minadanesh/apsc496/documents/concept alternatives assignment/Functional Decomposition.JPG

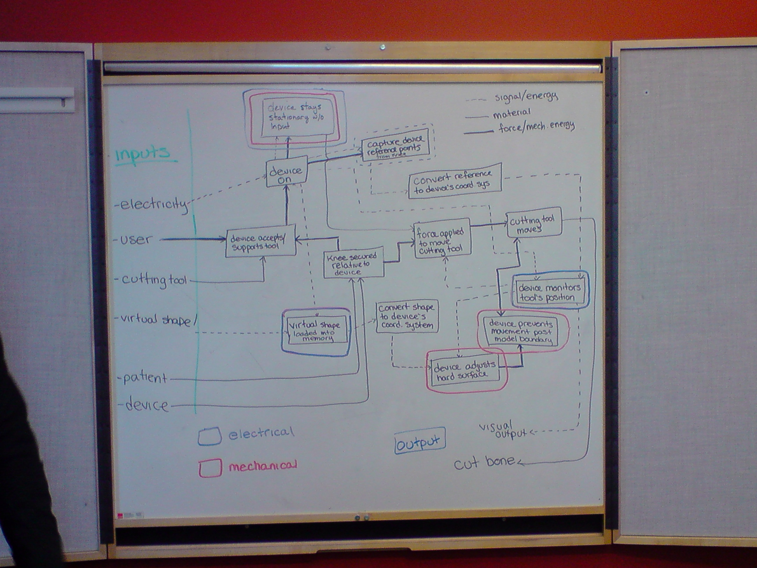
documents/concept alternatives assignment/Functional Decomposition.JPG
