minadanesh/apsc496/design_documents/Praxim Models/Joint 1_2 Cross Section.jpg

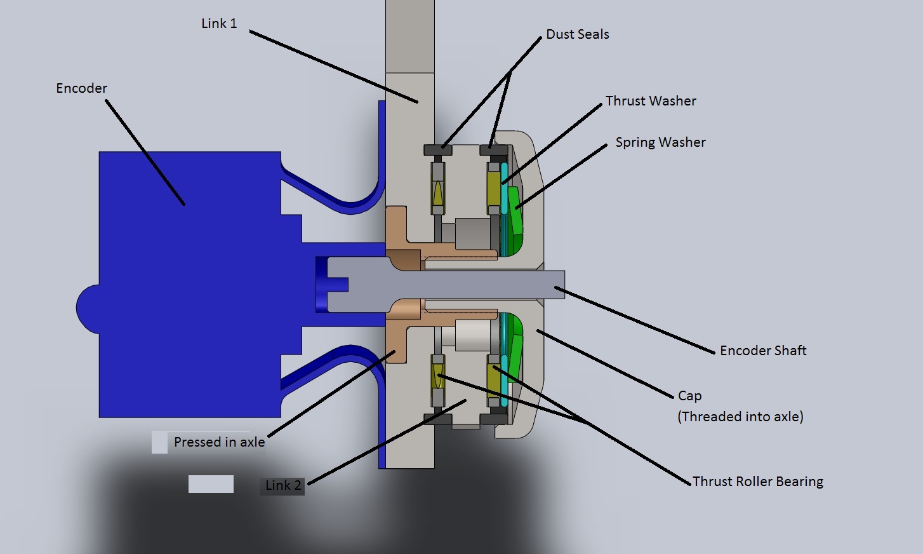
design_documents/Praxim Models/Joint 1_2 Cross Section.jpg
