minadanesh/apsc496/design_documents/control_system/rtos/bsp-TI-omap3530-src/readme.txt

QNX Neutrino 6.4.1 BSP for TI OMAP3530 1.0.0
Build: 201001071551
For documentation related to this BSP, please refer to the pages dedicated to this BSP on the Foundry27
http://community.qnx.com/sf/wiki/do/viewPage/projects.bsp/wiki/BSPAndDrivers
