minadanesh/apsc496/documents/concept alternatives assignment/APSC 496 - Concept Presentation (V2).pptx

## Praxim Haptic 3D Surface Emulation

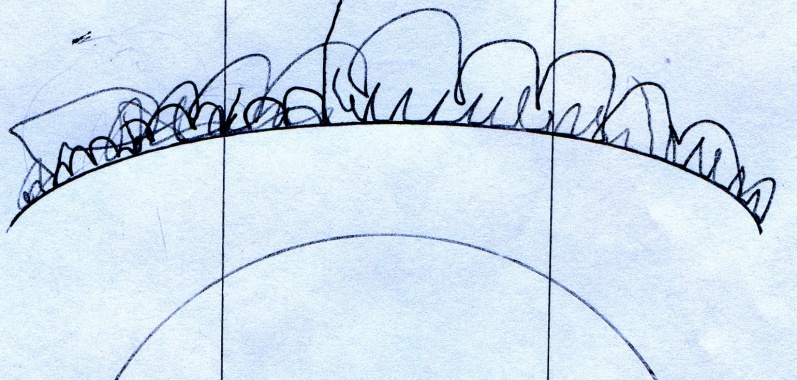
[picture p46: figure]
SCANNED 1

Erica Wodzak
Davy Chiu
David Mountford
Ibrahim Gadala
Nicholas Adams

## Outline


- Background
- Dynamic Constraint Concept
- Functional Decomposition
- Concepts Generation
- Concept Selection

## Project Background

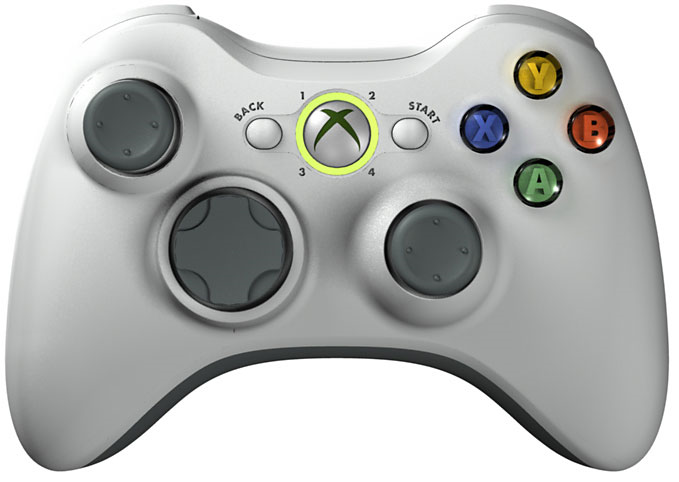
[picture p47: figure]
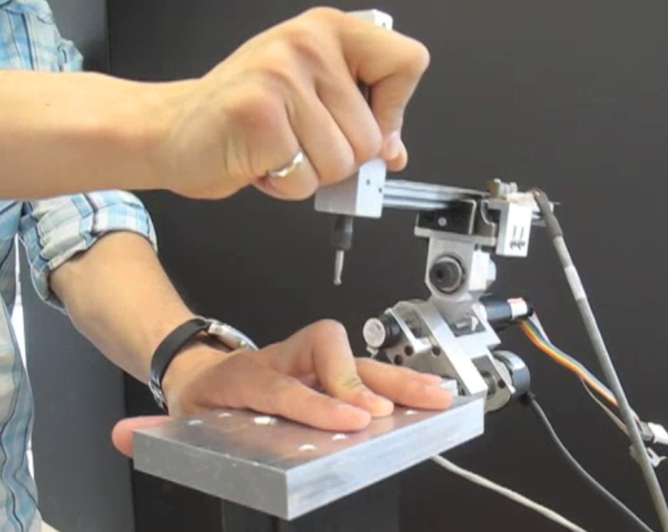
[picture p48: figure]
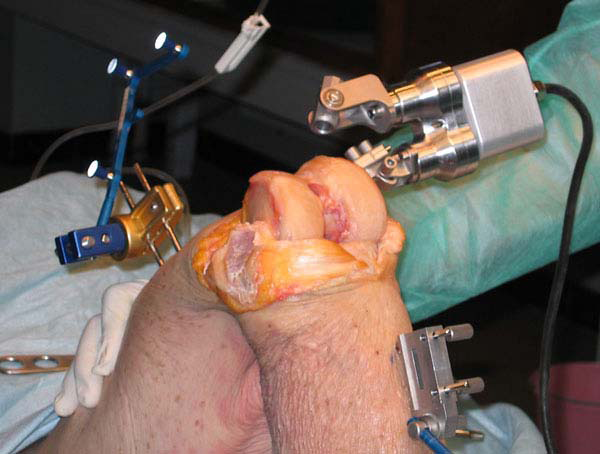
[picture p49: figure]

## Dynamic Physical Constraint Concept

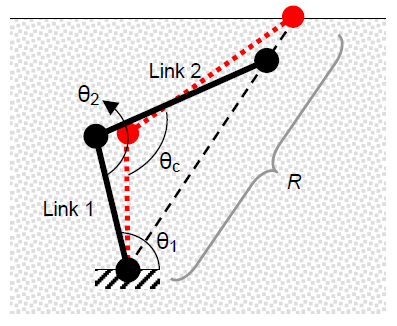
[picture p50: figure]
SCANNED 2-INVERTED 2

## Functional Decomposition

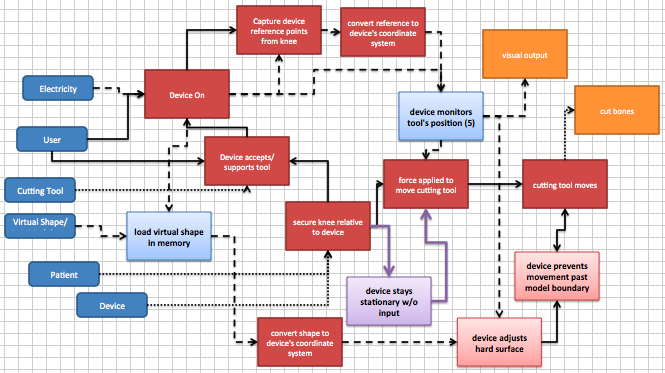
[picture p51: figure]

## Functional Decomposition

Device Stays In Position Under Gravitational Influence

## Concept Generation: High Joint Friction

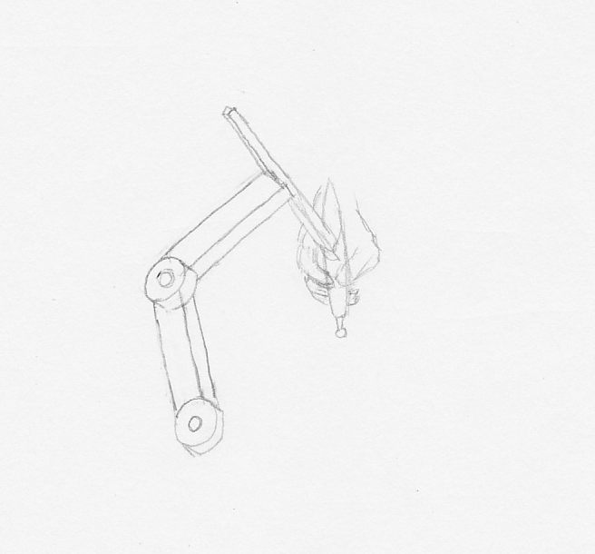
[picture p52: figure]

- Joint friction equal to arm’s free weight

## Concept Generation: Hydraulics

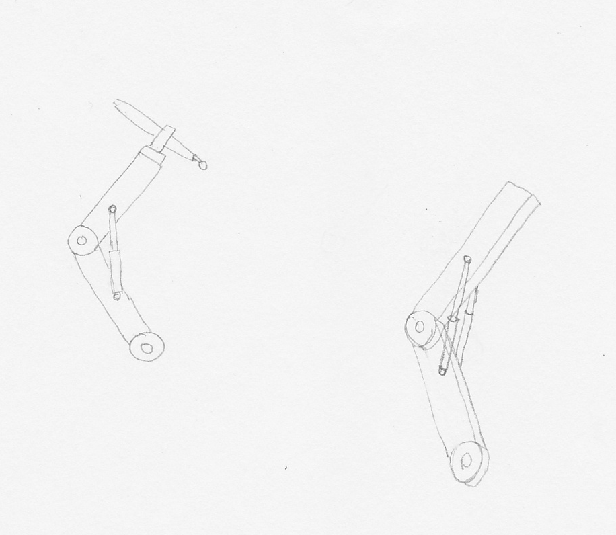
[picture p53: figure]

- Hydraulic damper resisting arm’s weight

## Concept Generation: Counterweight

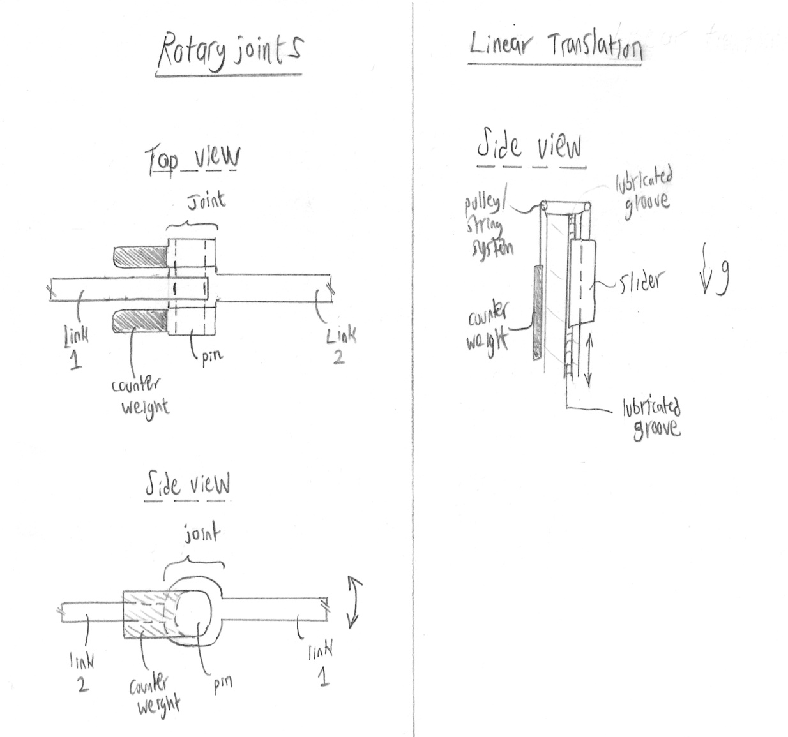
[picture p54: figure]

- Counterweight at joint balances the weight of the arm

## Concept Generation: Motor

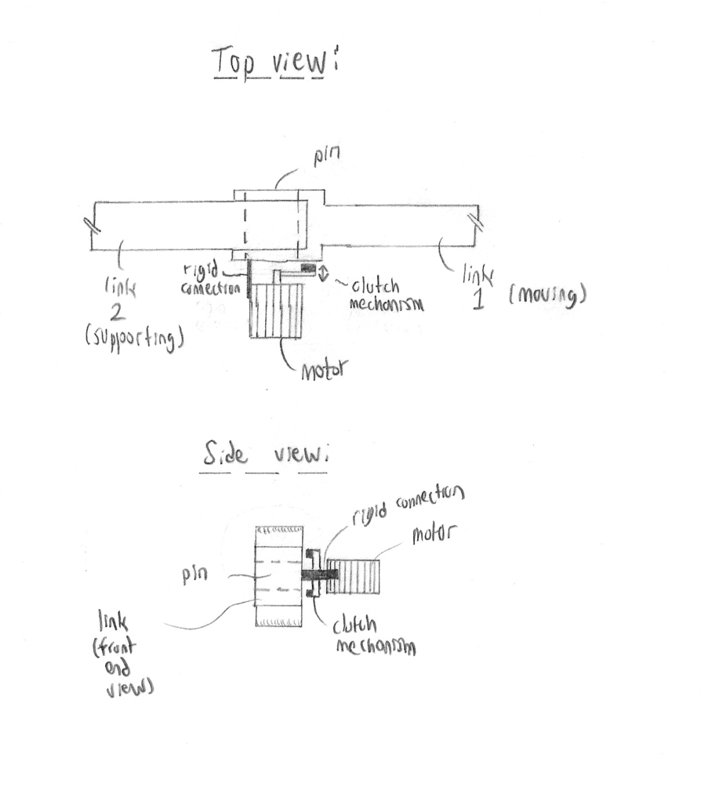
[picture p55: figure]

- Motor and clutch/brake mechanism prevents arm free-fall
