minadanesh/apsc496/documents/concept alternatives assignment/APSC 496 - Concept Presentation.pptx

## Praxim Haptic 3D Surface Emulation

SCANNED 1

Erica Wodzak
Davy Chiu
David Mountford
Ibrahim Gadala
Nicholas Adams

## Outline


- Background
- Dynamic Constraint Concept
- Functional Decomposition
- Concepts Generation
- Concept Selection

## Project Background


## Dynamic Physical Constraint Concept

SCANNED 2-INVERTED 2

## Functional Decomposition


## Functional Decomposition

Device Stays In Position Under Gravitational Influence

## Concept Generation: High Joint Friction


- Joint friction equal to arm’s free weight

## Concept Generation: High Joint Friction


- Hydraulic damper resisting arm’s weight
