minadanesh/apsc496/documents/concept alternatives assignment/APSC 496 - Praxim Haptic Emulation 3D Hard Surfaces.pptx

## Praxim Haptic Emulation of 3D Hard Surfaces

SCANNED 1

TEAM
Erica Wodzak
Davy Chiu
David Mountford
Ibrahim Gadala
Nicholas Adams

## Outline

- Project background
- Dynamic Physical Constraint concept
- Functional Decomposition
- Concepts
  - Counter weight
  - Motor
  - Friction
  - Damper
  - Spring
- Summary


## Project Background


## Dynamic Physical Constraint Concept

SCANNED 2-INVERTED 2
