minadanesh/apsc496/documents/concept alternatives assignment/friction & damper.pptx

## Friction

- Friction in joint equal to weight


## Damper

- Hydraulic damper resisting weight

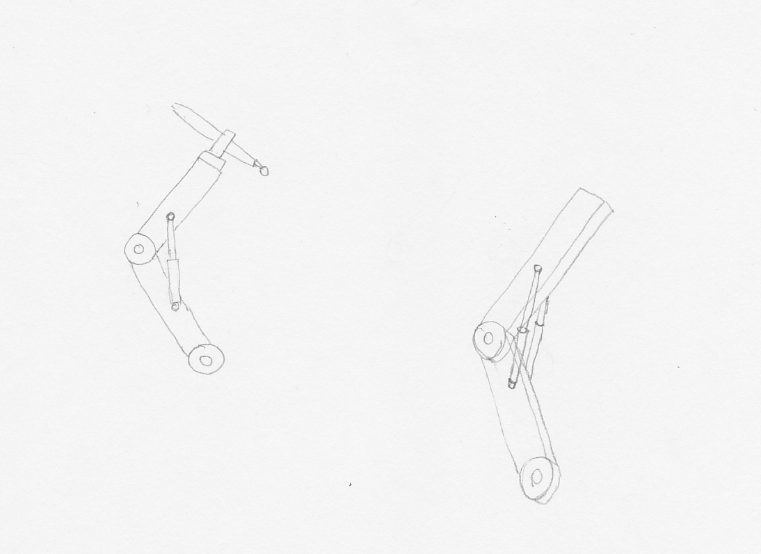
[picture p56: figure]
