minadanesh/apsc496/status reports/overall hours report.xlsx

Sheet: all
 | Working Hours | Meeting Hours | Total Hours
David | 133 | 39.5 | 172.5
Davy | 238.5 | 56 | 294.5
Erica | 68.25 | 32 | 100.25
Ibrahim | 123.5 | 46.5 | 170
Nich | 112.5 | 43 | 155.5
total | 675.75 | 217 | 892.75
average/person | 135.15 | 43.4 | 178.55
average/person/week | 9.01 | 2.89 | 11.90
number of weeks | 15.0 | 17.57142857

Sheet: weekly
2010-01-01 | 2010-01-10 | 2010-01-17 | 2010-01-24 | 2010-01-31 | 2010-02-07 | 2010-02-14 | 2010-02-21 | 2010-02-28 | 2010-03-07 | 2010-03-14 | 2010-03-21 | 2010-03-28 | 2010-04-04 | 2010-04-11 | 2010-04-18 | 2010-04-25 | 2010-05-02 | 2010-05-09 | 2010-05-16
David | 12.5 | 7 | 4.5 | 7 | 8 | 4.5 | 22 | 3 | 10.5 | 3 | 2 | 3.5 | 14 | 27 | 29 | 19 | 0 | 0 | 0
Davy | 24.5 | 9.5 | 13 | 27 | 3.5 | 9.5 | 10.5 | 11.5 | 24.5 | 22.5 | 4 | 26.5 | 17.5 | 51 | 50.5 | 39 | 0 | 0 | 0
Erica | 8 | 5.5 | 4.75 | 6.75 | 9 | 0 | 0.5 | 6.5 | 7 | 21 | 1 | 4 | 7 | 6 | 3 | 17 | 0 | 0 | 0
Ibrahim | 8 | 7 | 8 | 13 | 6 | 5.5 | 1 | 6 | 9.5 | 22 | 8 | 4 | 7 | 21 | 30.5 | 26.5 | 0 | 0 | 0
Nich | 15 | 2 | 13 | 14 | 6.5 | 7.5 | 10 | 3.5 | 5 | 6.5 | 12 | 4 | 2.5 | 15 | 34 | 17 | 0 | 0 | 0
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
