minadanesh/apsc496/status reports/david.xlsx

Date | Hours | Comment
2010-01-05 | 1 | Weekly Meeting
2010-01-05 | 3 | Group Meeting
2010-01-07 | 3 | Group Meeting
2010-01-08 | 2 | Knex Party
2010-01-09 | 0.5 | Purchase Meccano
2010-01-09 | 3 | Meccano Party
2010-01-14 | 1 | Group Meeting
2010-01-14 | 1 | Deriving equations for tool position
2010-01-14 | 3 | Update Matlab model for PT1b
2010-01-14 | 1 | Simplified gravity comp fbd and rough software block diagram
2010-01-15 | 1 | Freebody diagrams on gravity compensation
2010-01-18 | 0.5 | Analysis of motor placement
2010-01-19 | 1 | Group Meeting
2010-01-19 | 1 | Weekly Meeting
2010-01-20 | 1 | Meeting with Nich on gravity compensation
2010-01-21 | 1 | Group Meeting
2010-01-26 | 2 | Group Meeting
2010-01-26 | 1 | Weekly Meeting
2010-01-28 | 1 | Group Meeting
2010-01-29 | 2 | Solid Modelling
2010-01-29 | 1 | Solid Modelling
2010-02-01 | 1 | Client pre-meeting
2010-02-01 | 1 | Client Meeting
2010-02-02 | 4 | Solid Modelling
2010-02-04 | 2 | Design Breakdown
2010-02-08 | 0.5 | Group Meeting
2010-02-08 | 1 | Weekly Meeting
2010-02-11 | 3 | Design and Decisions Meeting
2010-02-18 | 1 | Group Meeting on Skype
2010-02-19 | 12 | Solid Modeling of design (span of reading break)
2010-02-19 | 4 | Joint 1-2 design
2010-02-19 | 4 | Bearing selection and research for joint 1-2
2010-02-20 | 1 | Group Meeting on Skype
2010-02-23 | 3 | Group Meeting
2010-03-02 | 1.5 | Group Meeting
2010-03-02 | 1 | Weekly Meeting
2010-03-01 | 2 | Power supply research
2010-03-01 | 2 | Preliminary wiring harness design
2010-03-02 | 1 | Trying to understand the bone mount
2010-03-06 | 3 | Log book catch-up
2010-03-09 | 2 | Group Meeting
2010-03-09 | 1 | Weekly Meeting
2010-03-16 | 2 | Group Meeting
2010-03-23 | 2.5 | Group Meeting
2010-03-23 | 1 | Weekly Meeting
2010-03-30 | 1 | Weekly Meeting
2010-04-01 | 9 | Finalizing Design and Modelling
2010-04-02 | 4 | Documenting Design
2010-04-05 | 2 | Producing Manufacturing Drawings
2010-04-06 | 3 | Producing Manufacturing Drawings
2010-04-06 | 6 | Lathe Work
2010-04-07 | 3 | Producing Manufacturing Drawings
2010-04-08 | 4 | Lathe Work
2010-04-08 | 3 | Updating Models and Producing Manufacting Drawings
2010-04-09 | 2 | Lathe Work
2010-04-11 | 4 | Updating backed up models after models became corrupt
2010-04-12 | 1 | Listed parts w/ status and estimated time required to finish
2010-04-12 | 1 | Reviewed parts list to ensure everything has been ordered
2010-04-12 | 4 | Lathe Work
2010-04-16 | 16 | Machining
2010-04-17 | 3 | Final Report - Drawings and writeup
2010-04-19 | 4 | Machining
2010-04-20 | 2 | Machining
2010-04-21 | 5 | Machining
2010-04-22 | 8 | Assembly
