minadanesh/apsc496/status reports/davy.xlsx

Date | Hours | Comment
2010-01-02 | 3 | Review reference material (Plaskos Thesis)
2010-01-03 | 3 | Review reference material (Nikolai, 2008 Group)
2010-01-05 | 1 | Weekly Meeting
2010-01-05 | 3 | Group Meeting
2010-01-06 | 4 | PM - Meeting Preparation
2010-01-07 | 3 | Group Meeting
2010-01-08 | 1 | Knex Party
2010-01-08 | 3 | PM - Meeting Summary, Calendar Updates
2010-01-09 | 0.5 | Purchase Meccano
2010-01-09 | 3 | Meccano Party
2010-01-11 | 2 | Microcontroller research
2010-01-11 | 0.5 | PM - Meeting Preparation
2010-01-12 | 2 | Group Meeting
2010-01-12 | 1 | Weekly Meeting
2010-01-14 | 1 | Group Meeting
2010-01-17 | 3 | Control System Research
2010-01-19 | 1 | Group Meeting
2010-01-19 | 1 | Weekly Meeting
2010-01-21 | 1 | Group Meeting
2010-01-22 | 2 | TAR Research
2010-01-24 | 1.5 | CFP Update
2010-01-24 | 1.5 | PM - Meeting Preparation and Updates
2010-01-24 | 2 | TAR - electrical and software (matlab)
2010-01-25 | 4 | TAR - electrical and software
2010-01-26 | 2 | Group Meeting
2010-01-26 | 1 | Weekly Meeting
2010-01-26 | 4 | TAR - microcontroller minimum speed calculation
2010-01-27 | 6 | TAR - microcontroller speed simulation and writeup
2010-01-28 | 4 | TAR compilation
2010-01-28 | 1 | Group Meeting
2010-02-01 | 1 | Group Meeting - Chris meeting prep
2010-02-01 | 1 | Chris Meeting
2010-02-02 | 1.5 | Group Meeting
2010-02-08 | 1.5 | Group Meeting
2010-02-08 | 1 | Weekly Meeting
2010-02-11 | 3 | Design and Decision Meeting
2010-02-13 | 1.5 | Researched sterilizable motor
2010-02-14 | 0.5 | Encoder speed requirement calculation
2010-02-14 | 2 | Researched QNX installation methods and issues
2010-02-15 | 3 | Ordered control system components
2010-02-18 | 1 | Group Meeting on Skype
2010-02-18 | 0.5 | Gravity Compensation motor experiment
2010-02-20 | 1 | Group Meeting on Skype
2010-02-21 | 2.5 | QNX Setup
2010-02-22 | 4 | QNX Setup
2010-02-22 | 1 | Motor controller cables research
2010-02-23 | 3 | Group Meeting
2010-02-24 | 1 | Motor Testing
2010-03-02 | 1.5 | Group Meeting
2010-03-02 | 1 | Weekly Meeting
2010-03-03 | 8 | QNX GPIO debug
2010-03-04 | 2 | Group Meeting
2010-03-06 | 4 | QNX - Interrupts
2010-03-07 | 8 | QNX - Interrupts
2010-03-08 | 1 | RMA/ship motor/encoder
2010-03-08 | 5 | QNX - Interrupts
2010-03-09 | 2 | Group Meeting
2010-03-09 | 1 | Weekly Meeting
2010-03-10 | 4 | QNX - Interrupts/Encoder test
2010-03-12 | 1.5 | Encoder/motor controller interface order
2010-03-16 | 2 | Group Meeting
2010-03-19 | 2 | OMAP UART documentation
2010-03-22 | 3 | QNX 3D implementation design
2010-03-23 | 2.5 | Group Meeting
2010-03-23 | 1 | Weekly Meeting
2010-03-24 | 3.5 | Physical interface board design
2010-03-25 | 2 | QNX - Encoder Test
2010-03-26 | 0.5 | Skype Meeting
2010-03-26 | 6 | QNX - Encoder Test
2010-03-27 | 8 | QNX - Encoder Test
2010-03-30 | 1.5 | Group Meeting
2010-03-30 | 1 | Weekly Meeting
2010-04-02 | 2 | Beagleboard diagnostic
2010-04-03 | 5 | AVR-CAN interface
2010-04-04 | 8 | beagleboard avr-can interface
2010-04-05 | 8 | beagleboard avr-can interface
2010-04-06 | 1.5 | Group Meeting
2010-04-06 | 1 | Weekly Meeting
2010-04-07 | 6 | beagleboard avr-can interface
2010-04-08 | 2 | Group Meeting
2010-04-09 | 1 | buying parts for interface board
2010-04-09 | 6.5 | interface board soldering and assembly
2010-04-10 | 8 | interface board debug
2010-04-11 | 3 | pair programming with Erica
2010-04-11 | 6 | serial interface debug
2010-04-12 | 1 | Ordering encoder and misc parts
2010-04-12 | 7 | serial interface debug
2010-04-13 | 0.5 | Weekly Meeting
2010-04-13 | 5 | serial interface debug
2010-04-14 | 1 | Buying parts for AVR board
2010-04-14 | 5 | Soldering AVR interface board/making cables
2010-04-15 | 4 | Helping out with machining
2010-04-16 | 1 | Looking for enclosure material
2010-04-17 | 1 | PM - Plan of action
2010-04-17 | 4 | Final Report - digrams and writeup
2010-04-18 | 12 | Final Report editing, Poster design
2010-04-19 | 10 | Soldering/making cables, searching for plexiglass supplier
2010-04-20 | 9 | Ordering enclosure parts and interface motor
2010-04-21 | 8 | Final debug and assembly
