minadanesh/apsc496/status reports/ibrahim.xlsx

Date | Hours | Comment
2010-01-05 | 1 | Weekly Meeting
2010-01-07 | 3 | Group Meeting
2010-01-08 | 1 | K'Nex Meeting
2010-01-09 | 3 | Meccano Meeting at Nick's Place
2010-01-11 | 4 | CFP Motor, Gear and Positioning write-up
2010-01-12 | 2 | Group Meeting
2010-01-12 | 1 | Weekly Meeting
2010-01-19 | 1 | Group Meeting
2010-01-19 | 1 | Weekly Meeting
2010-01-21 | 1 | Group Meeting
2010-01-24 | 5 | Torque theta graphs and motor selction writeup for TAR
2010-01-26 | 2 | Group Meeting
2010-01-26 | 1 | Weekly Meeting
2010-01-27 | 4 | TAR - motor and torque
2010-01-28 | 1 | Group Meeting
2010-02-01 | 1 | Group Meeting - Chris meeting prep
2010-02-01 | 1 | Chris Meeting
2010-02-01 | 1 | encoder analysis
2010-02-02 | 1 | Group Meeting
2010-02-04 | 2 | Encoder Research
2010-02-08 | 1.5 | Group Meeting
2010-02-08 | 1 | Weekly Meeting
2010-02-11 | 3 | Design and Decision Meeting
2010-02-18 | 1 | Group Meeting on Skype
2010-02-22 | 3 | Motor controller cables order
2010-02-23 | 3 | Group Meeting
2010-03-02 | 1.5 | Group Meeting
2010-03-02 | 1 | Weekly Meeting
2010-03-04 | 2 | Group Meeting
2010-03-06 | 5 | Preliminary Offest Joint Design
2010-03-08 | 6 | Detailed Offset Link/Link5/Tool Mount Drawings
2010-03-09 | 2 | Group Meeting
2010-03-09 | 1 | Weekly Meeting
2010-03-09 | 3 | Session 1 with Dave (design and solidworks) - Markus Talk
2010-03-10 | 2 | Session 2 with Dave (design and solidworks)
2010-03-11 | 4 | Final Tool Mount/Offset Drawings and Part research/listing
2010-03-11 | 1 | Lecture in Scarfe
2010-03-12 | 3 | Final Tool Mount/Offset Drawings and Part research/listing cont'd
2010-03-16 | 2 | Group Meeting
2010-03-16 | 1 | Material Ordering
2010-03-18 | 2 | Fastener Ordering and checkup with Perry
2010-03-19 | 3 | Bearing ordering-chechup-switch-reordering
2010-03-23 | 2.5 | Group Meeting
2010-03-23 | 1 | Weekly Meeting
2010-03-26 | 0.5 | Skype Meeting
2010-03-30 | 1.5 | Group Meeting
2010-03-30 | 1 | Weekly Meeting
2010-04-01 | 4.5 | Machine Shop: Rotating Base cutting and milling
2010-04-06 | 7.5 | Machine Shop (extended hours): Rotating Base milling
2010-04-07 | 4.5 | Machine work, preparation, discussions, cleanup
2010-04-08 | 4.5 | Machine work, preparation, discussions, cleanup
2010-04-09 | 4.5 | Machine work, preparation, discussions, cleanup
2010-04-12 | 4.5 | Machine work, preparation, discussions, cleanup
2010-04-13 | 4.5 | Machine work, preparation, discussions, cleanup
2010-04-14 | 4.5 | Machine work, preparation, discussions, cleanup
2010-04-15 | 4.5 | Machine work, preparation, discussions, cleanup
2010-04-16 | 4.5 | Machine work, preparation, discussions, cleanup
2010-04-18 | 8 | Final Report writeup
2010-04-19 | 4.5 | Machine work, preparation, discussions, cleanup
2010-04-20 | 2 | Machine work, preparation, discussions, cleanup
2010-04-21 | 12 | Machine work, assembly, poster
