minadanesh/apsc496/status reports/nicholas.xlsx

Date | Hours | Comment
2010-01-05 | 1 | Weekly Meeting
2010-01-05 | 3 | Group Meeting
2010-01-07 | 3 | Group Meeting
2010-01-07 | 2 | Winnowing Documentation
2010-01-08 | 2 | Knex Party
2010-01-09 | 3 | Meccano Party
2010-01-10 | 1 | Tool Research
2010-01-12 | 1 | Weekly Meeting
2010-01-19 | 1 | Group Meeting
2010-01-19 | 1 | Weekly Meeting
2010-01-19 | 3 | Physical Prototyping writeup
2010-01-20 | 1 | Meeting with David on gravity compensation
2010-01-21 | 1 | Group Meeting
2010-01-23 | 3 | TAR writeup
2010-01-24 | 3 | Gravity compensation model
2010-01-26 | 2 | Group Meeting
2010-01-26 | 1 | Weekly Meeting
2010-01-27 | 7 | TAR - gravity compensation
2010-01-28 | 1 | Group Meeting
2010-02-01 | 1 | Group Meeting - Chris meeting prep
2010-02-01 | 1 | Chris Meeting
2010-02-02 | 1.5 | Group Meeting
2010-02-04 | 3 | Design breakdown
2010-02-08 | 1.5 | Group Meeting
2010-02-08 | 1 | Weekly Meeting
2010-02-11 | 3 | Design and Decision Meeting
2010-02-14 | 1 | Rotating base design
2010-02-14 | 1 | Sizing calculations
2010-02-15 | 3 | Coupling selection
2010-02-18 | 1 | Group Meeting on Skype
2010-02-19 | 0.5 | Sizing calculations
2010-02-19 | 0.5 | Gear box calculations
2010-02-19 | 2 | Motor selection background
2010-02-20 | 1 | Group Meeting on Skype
2010-02-23 | 3 | Group Meeting
2010-02-23 | 0.5 | Maxon motor types
2010-03-04 | 2 | Group Meeting
2010-03-04 | 2 | Implant Review
2010-03-04 | 1 | Motor precision requirements
2010-03-09 | 1.5 | Group Meeting
2010-03-09 | 1 | Weekly Meeting
2010-03-14 | 4 | Previous documentation review
2010-03-15 | 2 | Final documentation structure
2010-03-16 | 2 | Group Meeting
2010-03-18 | 1 | TAR Review
2010-03-18 | 3 | Rotation gravity compensation spreadsheet for new design
2010-03-23 | 2.5 | Group Meeting
2010-03-23 | 1 | Weekly Meeting
2010-03-26 | 0.5 | Skype Meeting
2010-03-30 | 1.5 | Group Meeting
2010-03-30 | 1 | Weekly Meeting
2010-04-05 | 3 | Gravity comp. curves
2010-04-06 | 6 | Gravity comp write up
2010-04-06 | 1 | Testing procedure
2010-04-09 | 4 | Machining
2010-04-10 | 1 | Testing procedure
2010-04-12 | 4 | Machining
2010-04-13 | 4 | Machining
2010-04-15 | 4 | Machining
2010-04-17 | 4 | Machining
2010-04-16 | 4 | Final documentation
2010-04-17 | 12 | Final documentation
2010-04-18 | 2 | Final documentation
2010-04-19 | 5 | Final Report Editing
2010-04-20 | 2 | Machining
2010-04-21 | 8 | Maching, assembly
