minadanesh/apsc496/design_documents/control_system/power.xlsx

consumer | voltage | current | peak current | power | peak power
HC motor | 24 | 1.41 | 6.97 | 33.84 | 167.28
HC encoder | 5 | 0.05 | 0.05 | 0.25 | 0.25
HC motor controller | 24 | 0.05 | 0.05 | 1.2 | 1.2
GC motor | 24 | 1.41 | 6.97 | 33.84 | 167.28
GC encoder | 5 | 0.05 | 0.05 | 0.25 | 0.25
GC motor controller | 24 | 0.05 | 0.05 | 1.2 | 1.2
processor circuit | 5 | 0.2 | 0.5 | 1 | 2.5
link1-2 encoder | 24 | 0.05 | 0.05 | 1.2 | 1.2
link5 encoder | 5 | 0.06 | 0.06 | 0.3 | 0.3
total |  | 3.33 | 14.75 | 73.08 | 341.46
