minadanesh/apsc496/documents/proposal/graphs.pdf

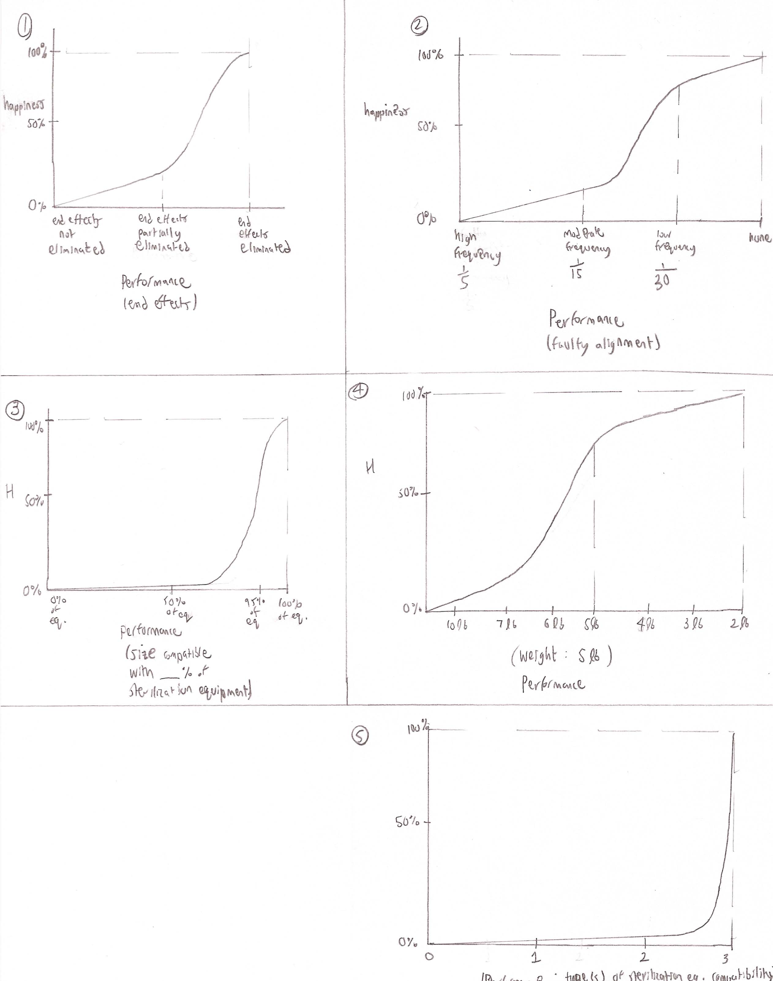
[picture p95: page 1]
