minadanesh/apsc496/finance/receipts/sawbones.pdf

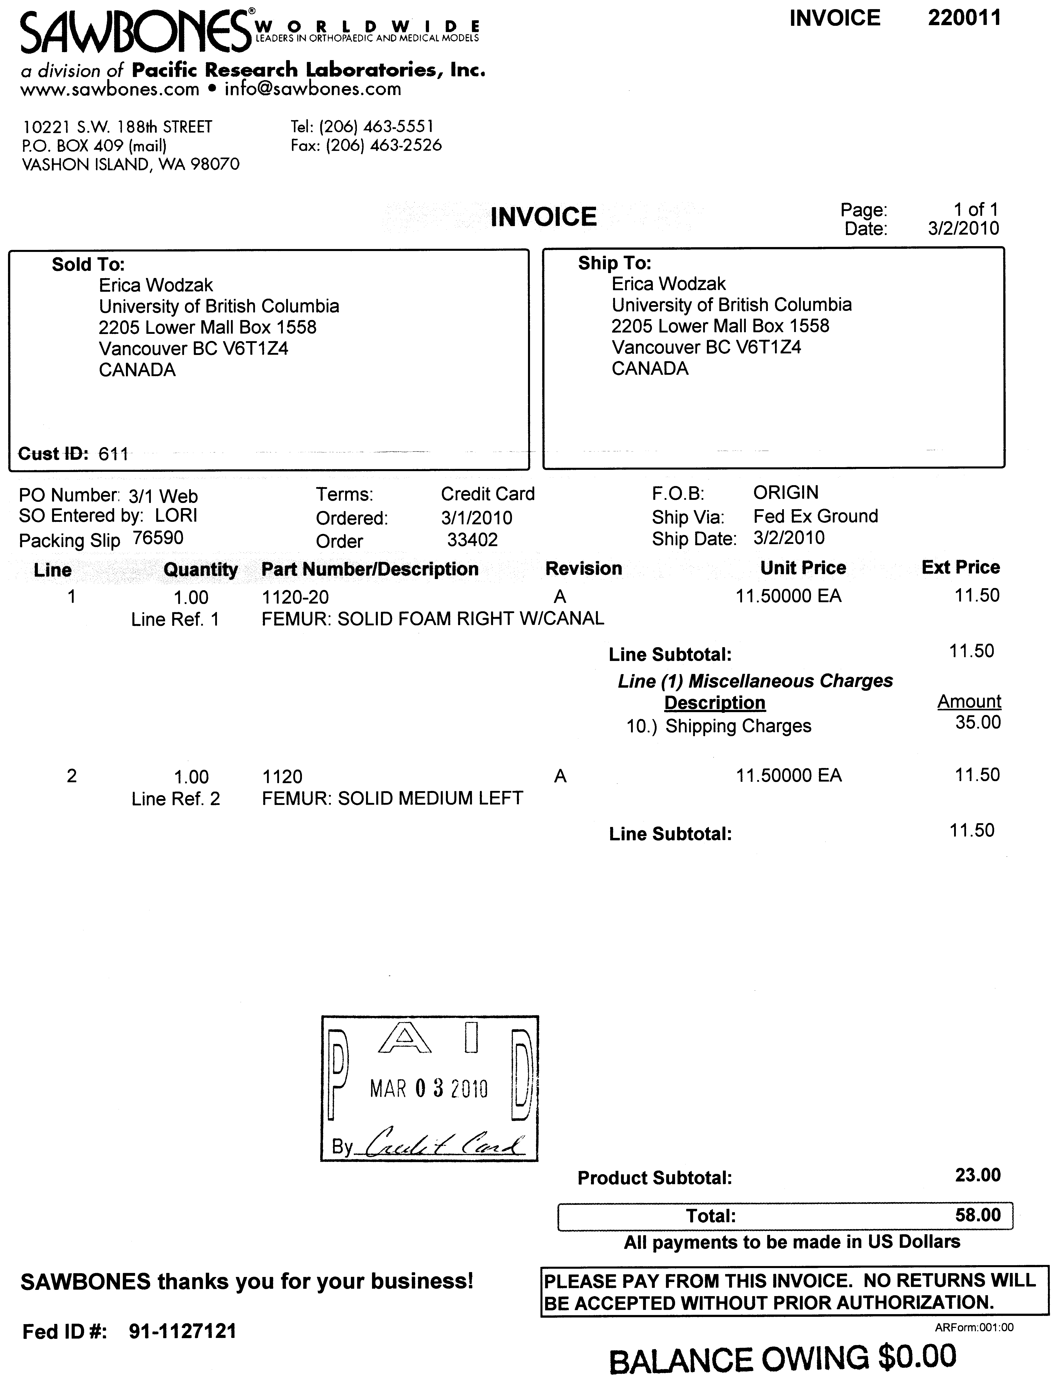
[picture p96: page 1]
