minadanesh/apsc496/status reports/erica.xlsx

Date | Hours | Comment
2010-01-05 | 1 | Weekly Meeting
2010-01-07 | 3 | Group Meeting
2010-01-09 | 4 | Knee Implant Research
2010-01-12 | 2 | Weekly Meeting
2010-01-12 | 1 | Group Meeting
2010-01-14 | 1 | Group Meeting
2010-01-16 | 1.5 | Research Implant Company
2010-01-19 | 1 | Group Meeting
2010-01-19 | 1 | Weekly Meeting
2010-01-21 | 1 | Group Meeting
2010-01-24 | 1.75 | CFP Update/Edit
2010-01-26 | 1 | TAR - motor speed
2010-01-27 | 3 | TAR - motor speed
2010-01-28 | 1 | Group Meeting
2010-02-01 | 1 | Group Meeting - Chris meeting prep
2010-02-01 | 1 | Chris Meeting
2010-02-02 | 1.5 | Group Meeting
2010-02-03 | 2.5 | CFP Update/Edit
2010-02-06 | 3 | CFP Update and misc
2010-02-20 | 0.5 | Group Meeting on Skype
2010-02-23 | 2 | Group Meeting
2010-02-26 | 2.5 | Order Femurs
2010-02-28 | 2 | Experimental Procedure
2010-03-02 | 1 | Weekly Meeting
2010-03-04 | 2 | Group Meeting
2010-03-05 | 2 | Pseudocode writeup
2010-03-09 | 2 | Group Meeting
2010-03-09 | 1 | Weekly Meeting
2010-03-10 | 8 | QNX & protocol procedure
2010-03-11 | 7 | Hard Constrait Programming
2010-03-13 | 3 | Hard Constrait Programming
2010-03-16 | 1 | Group Meeting
2010-03-23 | 2.5 | Group Meeting
2010-03-23 | 1 | Weekly Meeting
2010-03-26 | 0.5 | Skype Meeting
2010-04-02 | 7 | Hard Constrait Programming
2010-04-06 | 1 | Weekly Meeting
2010-04-08 | 2 | Group Meeting
2010-04-11 | 3 | Pair Programming Hard Constraint
2010-04-19 | 2 | Final Report Editing
2010-04-20 | 3 | Poster writeup
2010-04-21 | 12 | Poster and presentation
