minadanesh/apsc496/documents/technical analysis report/speed calculations [Erica].xlsx

 |  |  |  |  |  | Using Solver:
Preset Conditions:
Link 1 Length: | 7 | cm |  |  |  | if theta = | 160 | degrees
Link 2 Length: | 7 | cm
 |  |  |  |  |  | then h = | 13.787 | cm
 |  |  |  |  |  |  |  |  | ∆q = | 2.247
Tool Height, h (cm) | q (deg) | c (deg) | a (deg) | h | ∆a
13.950 | 170.3122995 | 4.8 | 175.16 | 13.95 |  | if h = | 13.737 | (0.5mm less than above)
13.900 | 166.2954885 | 6.9 | 173.15 | 13.90 | 2.008
13.850 | 163.2104915 | 8.4 | 171.61 | 13.85 | 1.542 | then theta = | 157.753 | degrees
13.800 | 160.6073478 | 9.7 | 170.30 | 13.80 | 1.302
13.750 | 158.3118869 | 10.8 | 169.16 | 13.75 | 1.148
13.700 | 156.2347427 | 11.9 | 168.12 | 13.70 | 1.039 | Iteration 2:
13.650 | 154.3228385 | 12.8 | 167.16 | 13.65 | 0.956
13.600 | 152.5417466 | 13.7 | 166.27 | 13.60 | 0.891 | if theta = | 100 | degrees
13.550 | 150.8673404 | 14.6 | 165.43 | 13.55 | 0.837
13.500 | 149.2822189 | 15.4 | 164.64 | 13.50 | 0.793 | then h = | 10.725 | cm
13.450 | 147.7731891 | 16.1 | 163.89 | 13.45 | 0.755 |  | 10.675 |  | ∆q = | 0.630
13.400 | 146.3300155 | 16.8 | 163.17 | 13.40 | 0.722
13.350 | 144.9445923 | 17.5 | 162.47 | 13.35 | 0.693 | if h = | 10.675 | (0.5mm less than above)
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
