minadanesh/apsc496/documents/technical analysis report/Torque vs Theta [Ibrahim].xlsx

L1 (cm) | 7 |  | Motor Arm Length (cm) | 1
L2 (cm) | 7
Load (kg) | 15
theta2 (deg) | L3 (cm) | theta1 (deg) | Force perpindicular to link 1 (N) | Motor Torque required (Nm)
90 | 4.288019592e-16 | 90 | 9.014029757e-15 | 9.014029757e-17
89 | 0.1221668451 | 89 | 2.568121607 | 0.02568121607
88 | 0.2442964769 | 88 | 5.13546094 | 0.0513546094
87 | 0.3663516937 | 87 | 7.701235961 | 0.07701235961
86 | 0.4882953162 | 86 | 10.26466511 | 0.1026466511
85 | 0.6100901992 | 85 | 12.82496755 | 0.1282496755
84 | 0.7316992429 | 84 | 15.38136337 | 0.1538136337
83 | 0.8530854038 | 83 | 17.93307388 | 0.1793307388
82 | 0.9742117067 | 82 | 20.47932181 | 0.2047932181
81 | 1.095041255 | 81 | 23.01933153 | 0.2301933153
80 | 1.215537244 | 80 | 25.55232934 | 0.2555232934
79 | 1.335662968 | 79 | 28.07754367 | 0.2807754367
78 | 1.455381836 | 78 | 30.5942053 | 0.305942053
77 | 1.57465738 | 77 | 33.10154765 | 0.3310154765
76 | 1.693453269 | 76 | 35.59880694 | 0.3559880694
75 | 1.811733316 | 75 | 38.08522249 | 0.3808522249
74 | 1.929461491 | 74 | 40.56003691 | 0.4056003691
73 | 2.046601933 | 73 | 43.02249635 | 0.4302249635
72 | 2.163118961 | 72 | 45.47185072 | 0.4547185072
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
