minadanesh/apsc496/documents/proposal/happy graphs.xlsx

performace | happiness
end effects not eliminated | 0%
 | 8%
end effects partially eliminated | 25%
 | 75%
end effects eliminated | 100%
performance | happiness
high frequency 1/5 | 0%
 | 5%
moderate frequency 1/15 | 11%
 | 25%
low frequency 1/30 | 80%
 | 94%
none | 100%
performance | happiness
0% | 0%
 | 2%
50% | 3%
 | 15%
95% | 90%
100% | 100%
performance | happiness
 | 0%
10 | 2%
7 | 10%
6 | 30%
5 | 75%
4 | 87%
3 | 93%
2 | 100%
performance | happiness
0 | 0%
 | 1%
1 | 2%
 | 3%
2 | 6.5%
 | 25%
3 | 100%
