minadanesh/apsc496/design_documents/Praxim Models/Full model v1.jpg

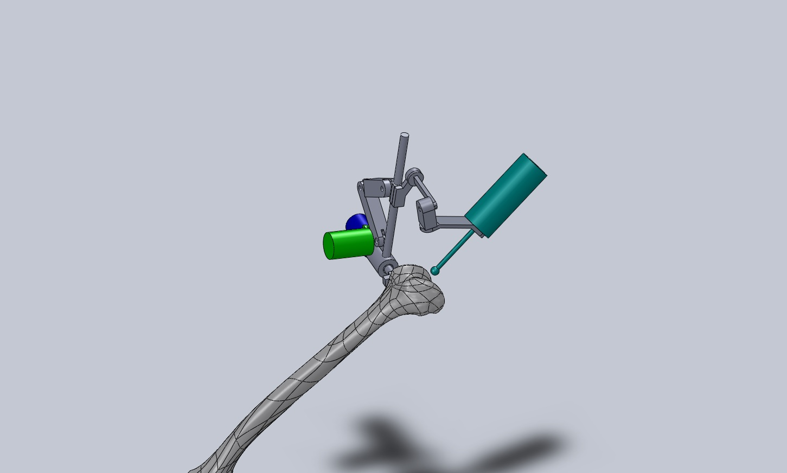
design_documents/Praxim Models/Full model v1.jpg
