minadanesh/apsc496/design_documents/Praxim Models/Pt1b_modified.jpg

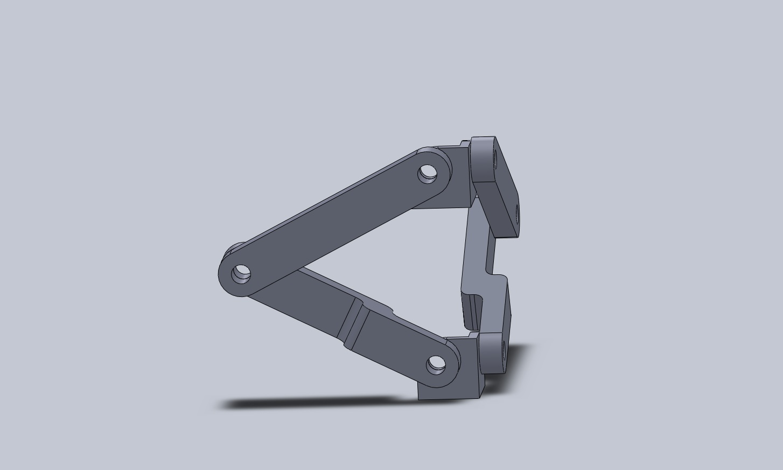
design_documents/Praxim Models/Pt1b_modified.jpg
