minadanesh/apsc496/finance/receipts/beagleboard-digikey (davy)/Image0001.JPG

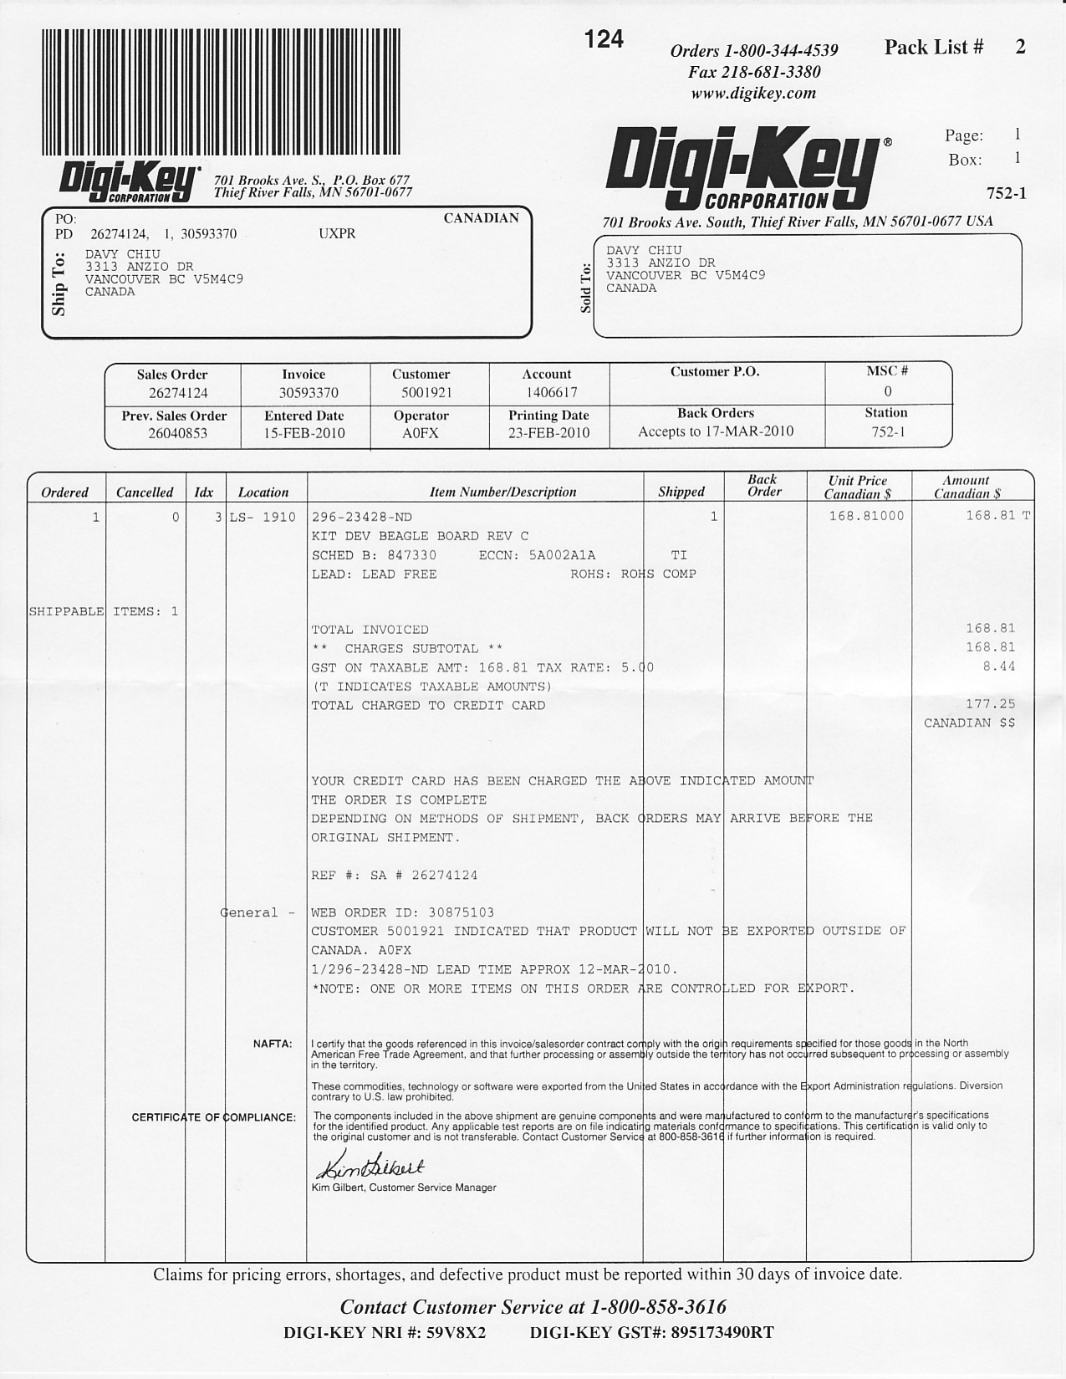
finance/receipts/beagleboard-digikey (davy)/Image0001.JPG
