minadanesh/apsc496/finance/receipts/beagleboard-digikey (davy)/Image0002.JPG

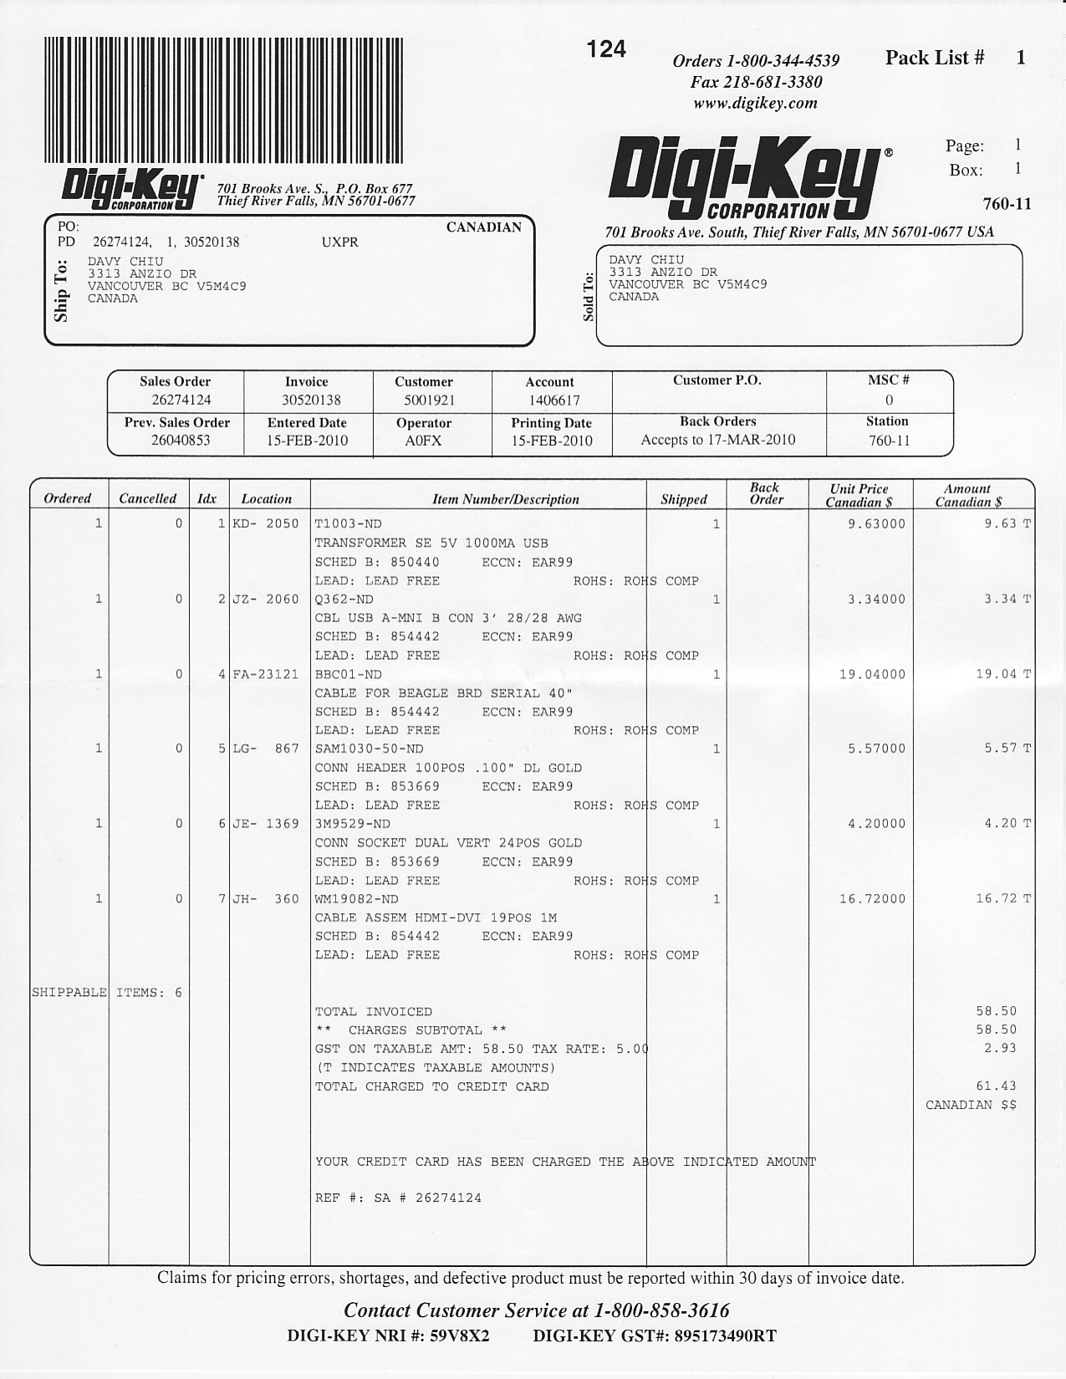
finance/receipts/beagleboard-digikey (davy)/Image0002.JPG
