minadanesh/apsc496/finance/receipts/beagleboard-digikey (davy)/Image0006.JPG

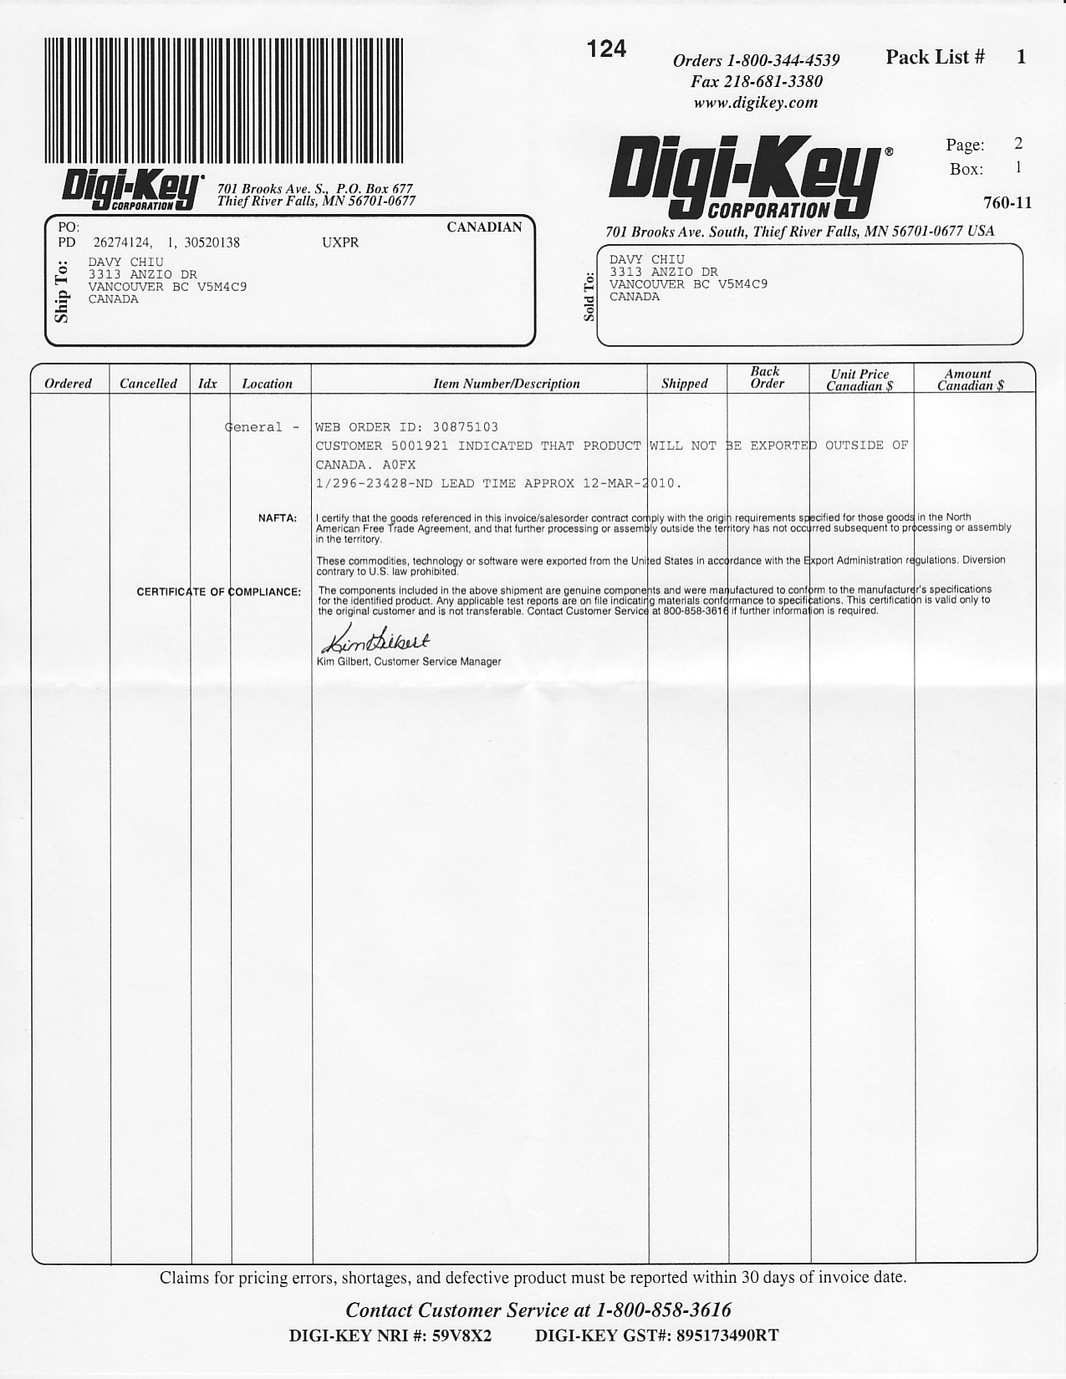
finance/receipts/beagleboard-digikey (davy)/Image0006.JPG
