minadanesh/apsc496/finance/receipts/circuitboard 2 (davy).JPG

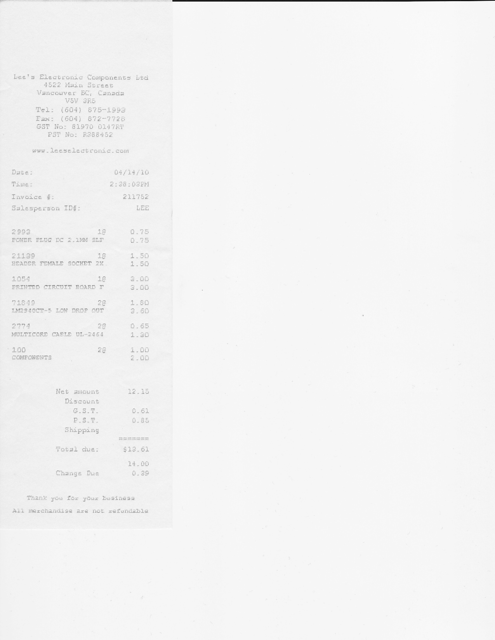
finance/receipts/circuitboard 2 (davy).JPG
