minadanesh/apsc496/finance/receipts/circuitboard (davy).JPG

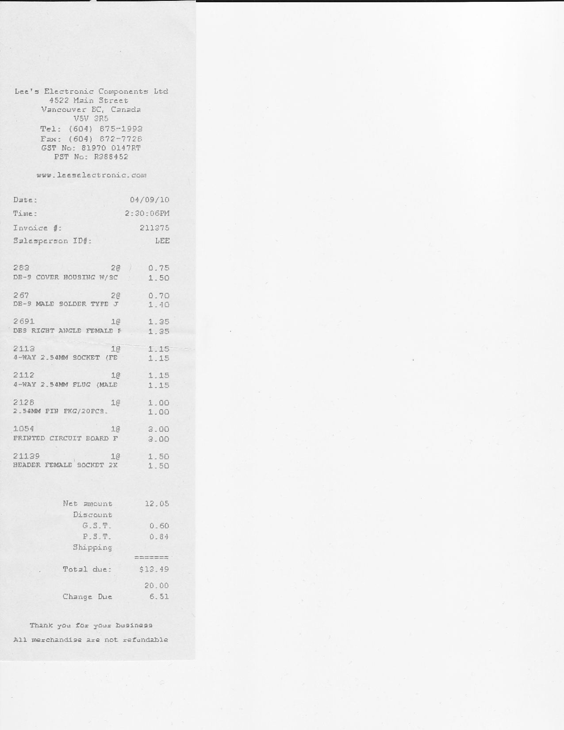
finance/receipts/circuitboard (davy).JPG
