minadanesh/apsc496/finance/receipts/encoder-digikey (davy)/Image0001.JPG

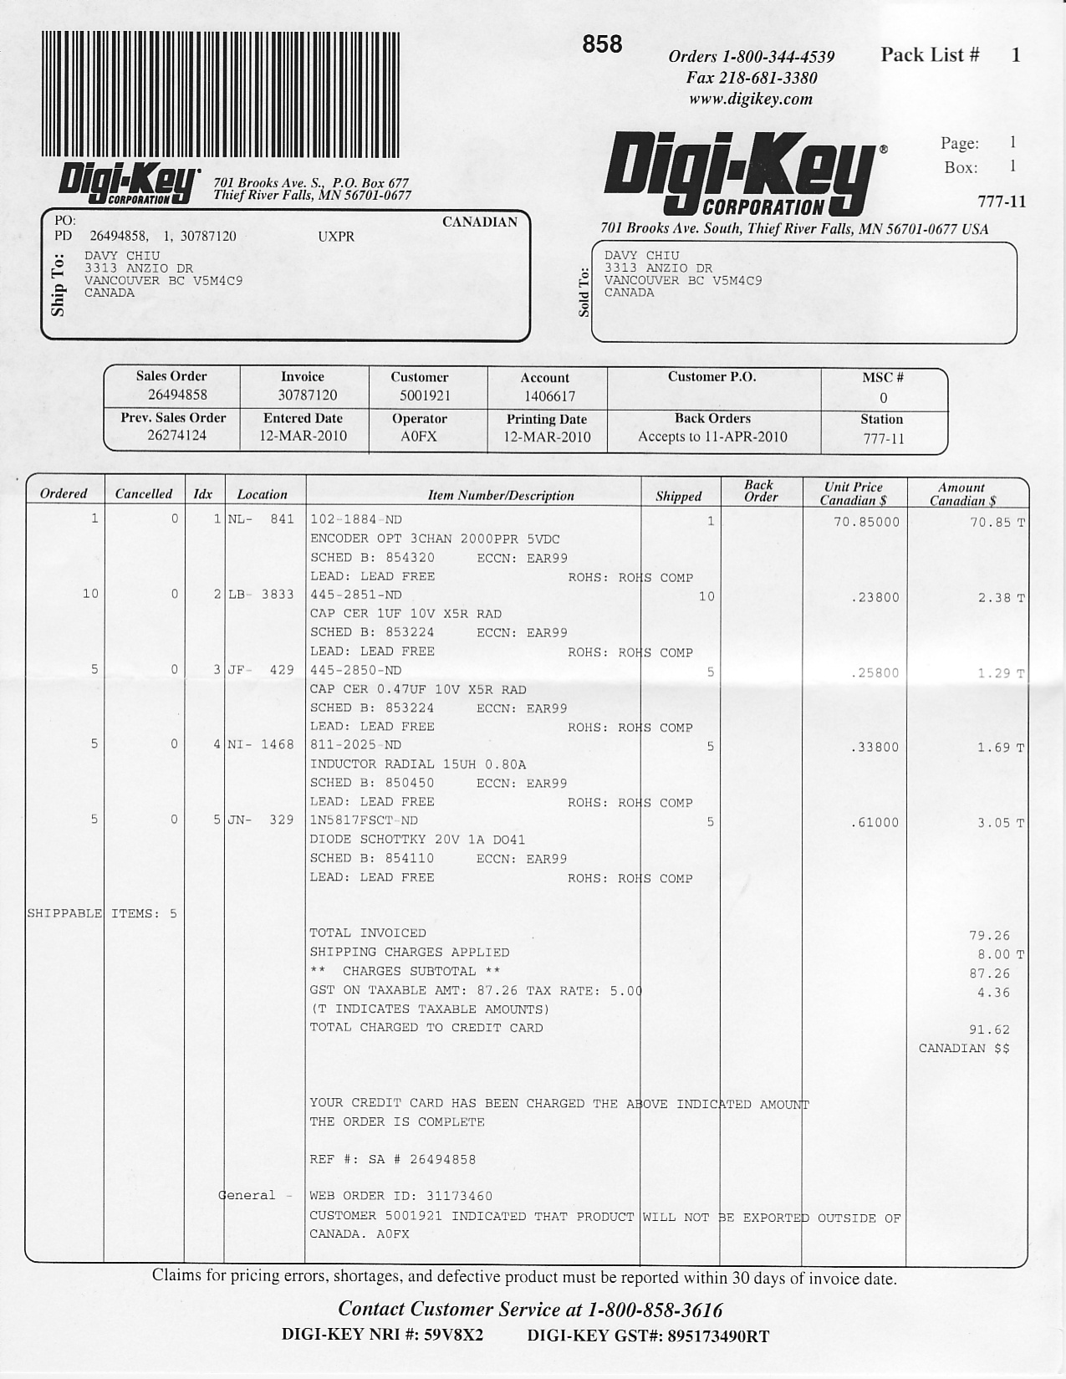
finance/receipts/encoder-digikey (davy)/Image0001.JPG
