minadanesh/apsc496/finance/receipts/encoder-digikey (davy)/Image0002.JPG

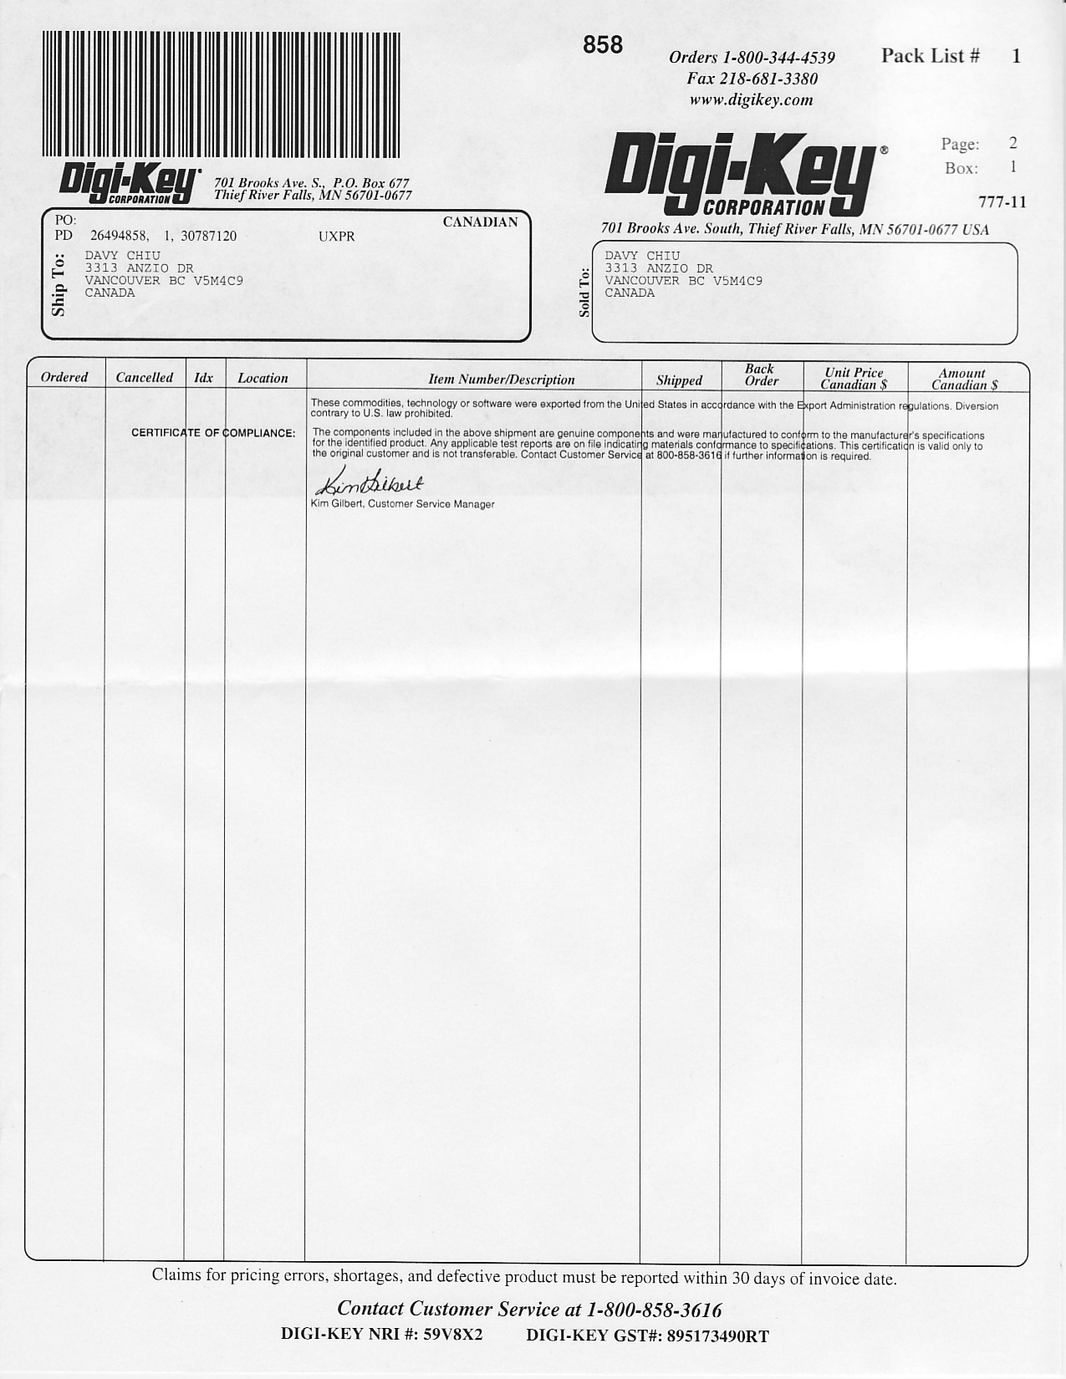
finance/receipts/encoder-digikey (davy)/Image0002.JPG
