minadanesh/apsc496/finance/receipts/encoder-digikey (davy)/Image0003.JPG

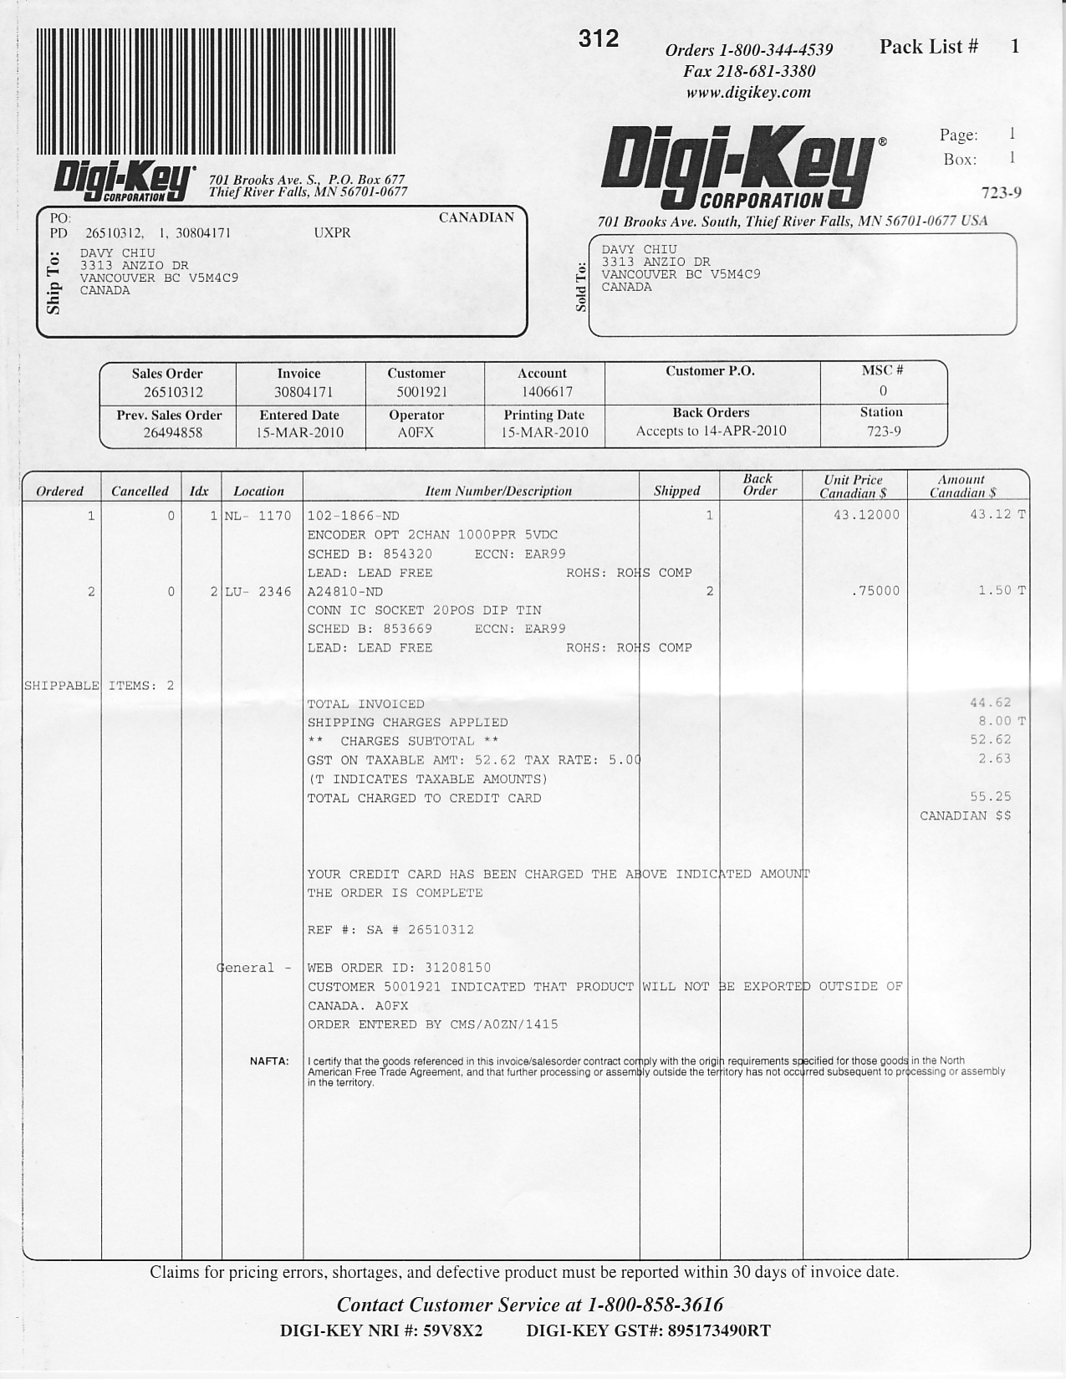
finance/receipts/encoder-digikey (davy)/Image0003.JPG
