minadanesh/apsc496/finance/receipts/encoder-digikey (davy)/Image0004.JPG

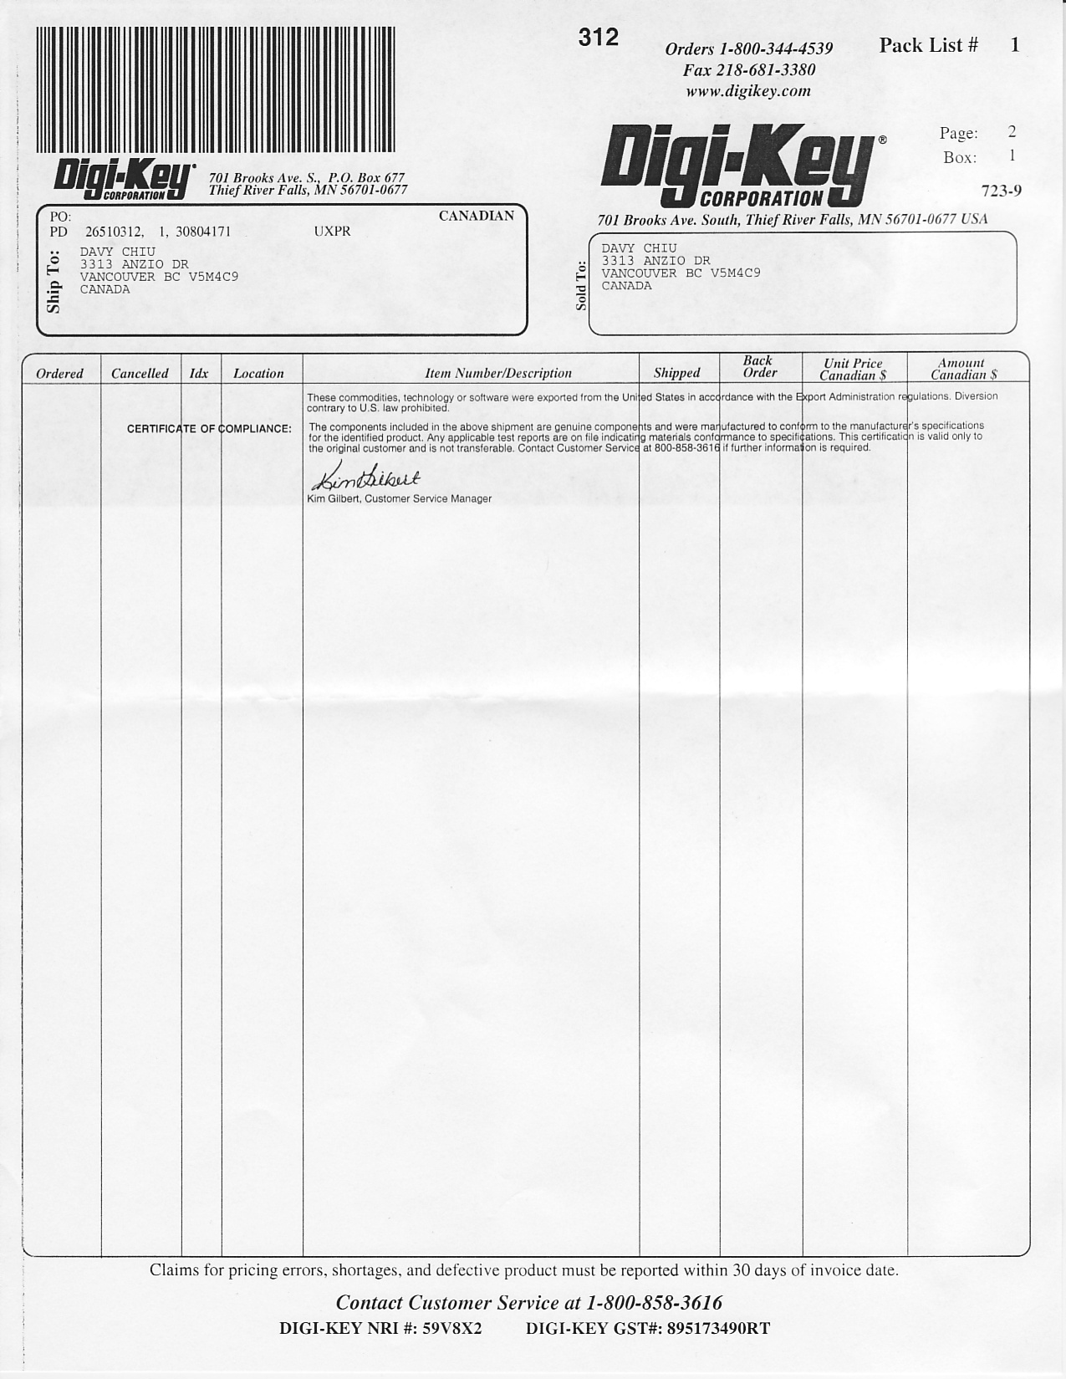
finance/receipts/encoder-digikey (davy)/Image0004.JPG
