minadanesh/apsc496/finance/receipts/encoder-digikey (davy)/Image0005.JPG

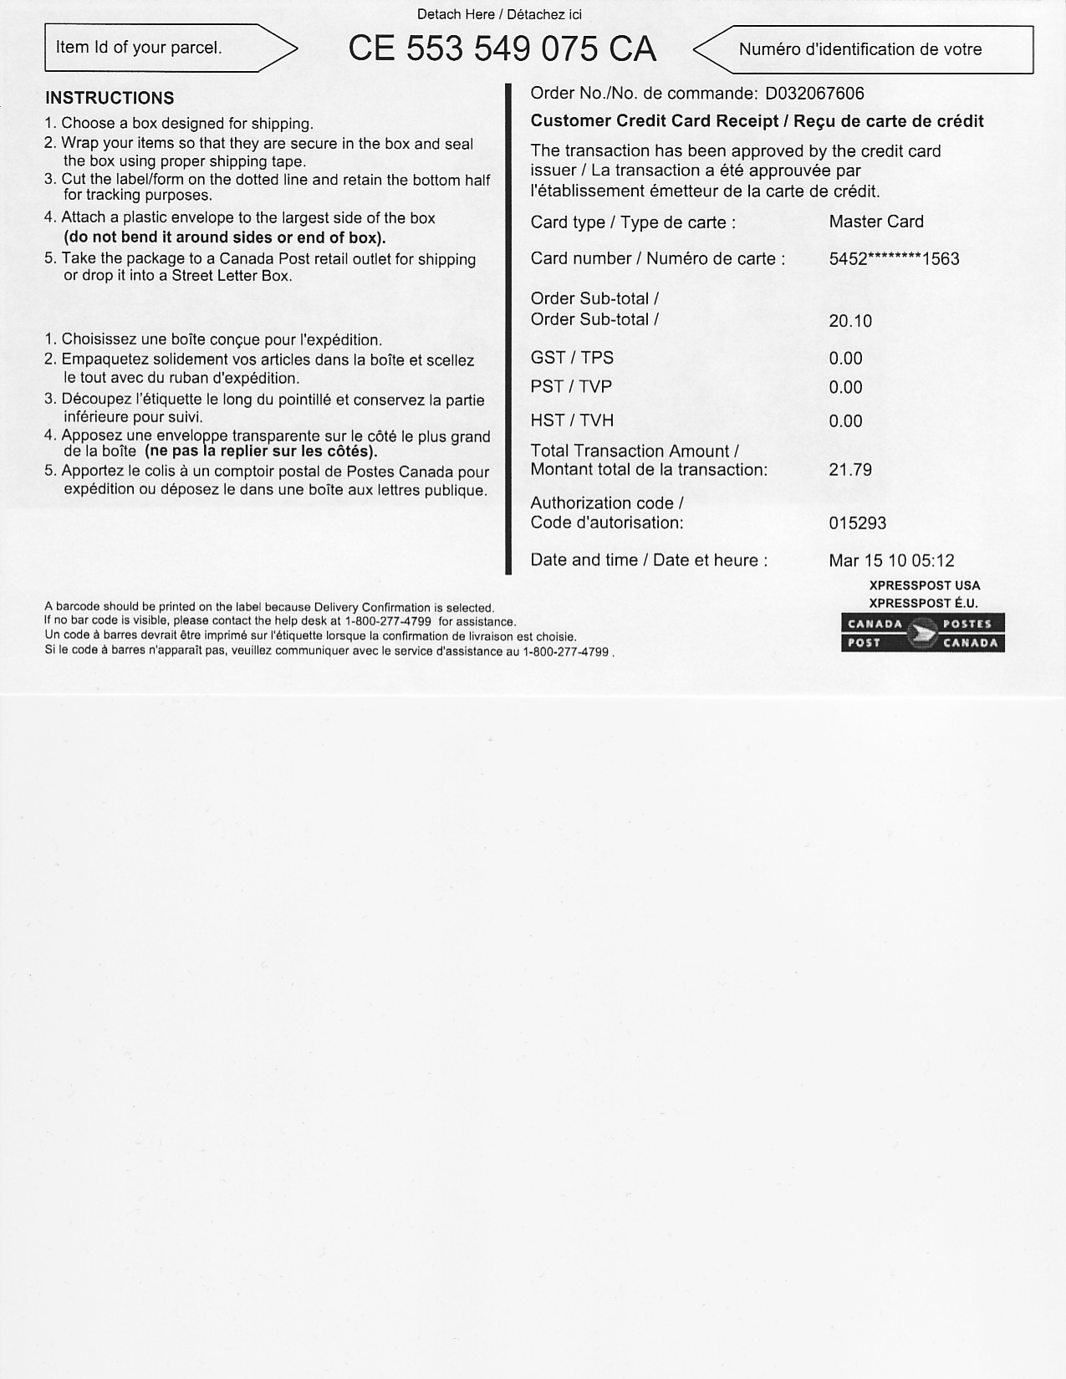
finance/receipts/encoder-digikey (davy)/Image0005.JPG
