minadanesh/apsc496/finance/receipts/knex (dave).JPG

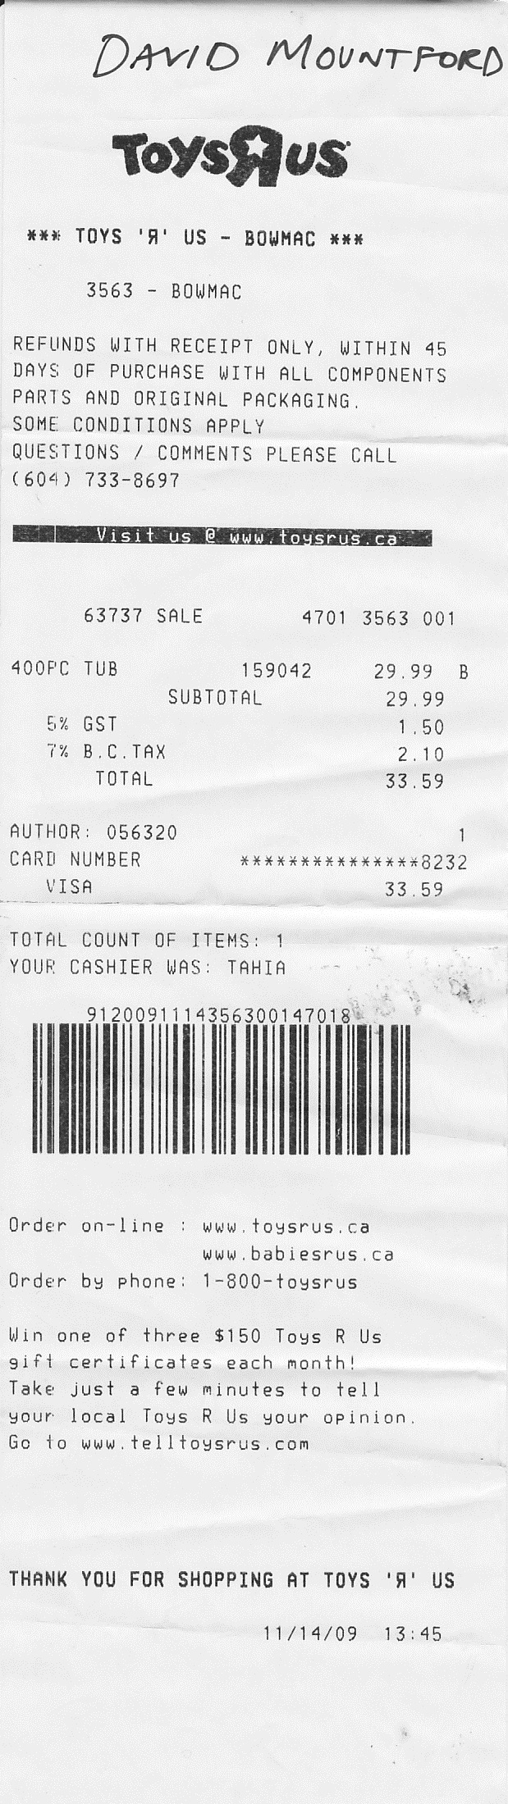
finance/receipts/knex (dave).JPG
