minadanesh/apsc496/finance/receipts/plexiglass (davy).JPG

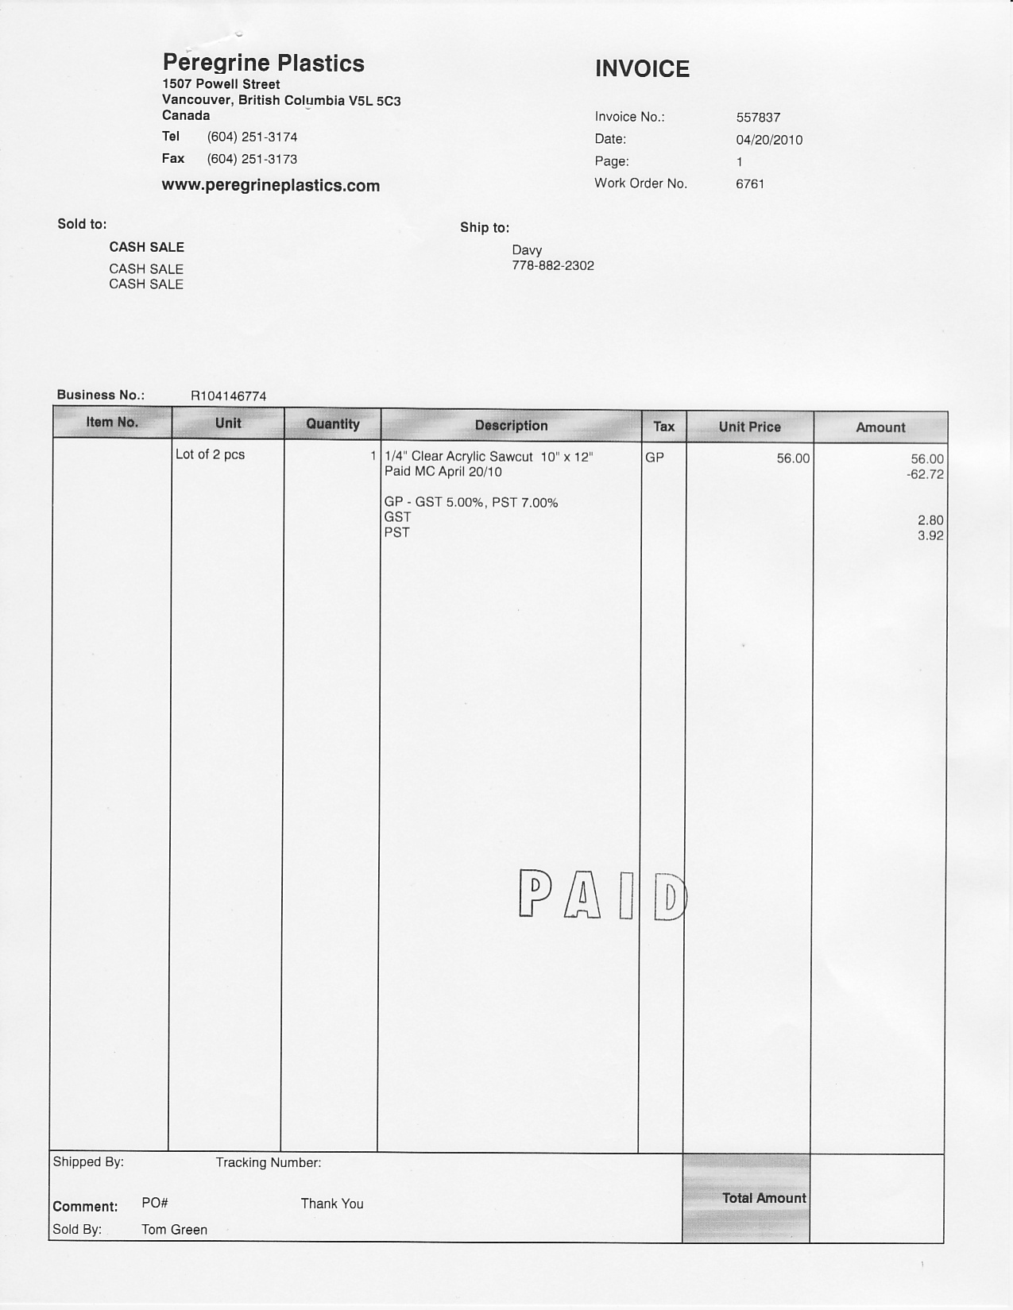
finance/receipts/plexiglass (davy).JPG
