minadanesh/apsc496/meeting minutes/meeting files/1-7 KNex Meeting/DSC04099.JPG

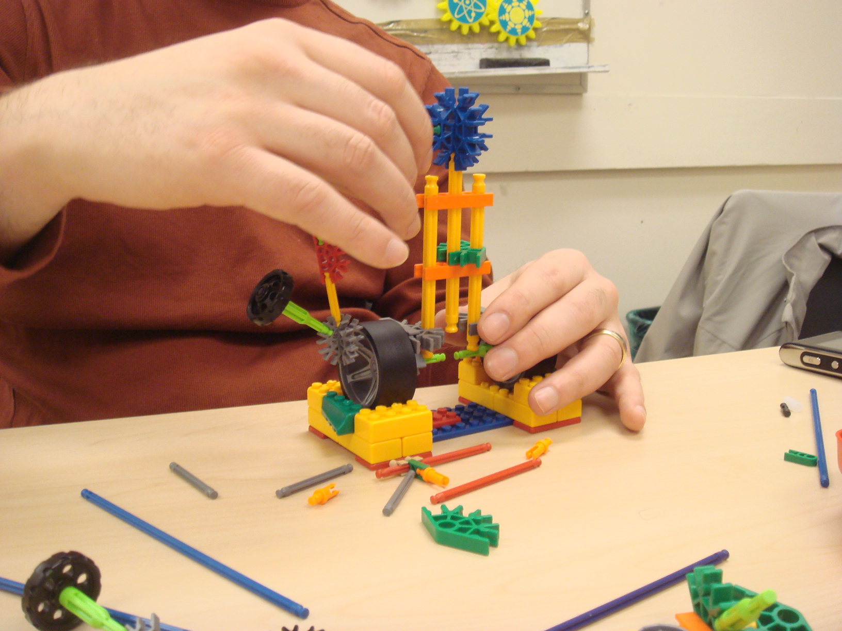
meeting minutes/meeting files/1-7 KNex Meeting/DSC04099.JPG
