minadanesh/apsc496/schedules/David.jpg

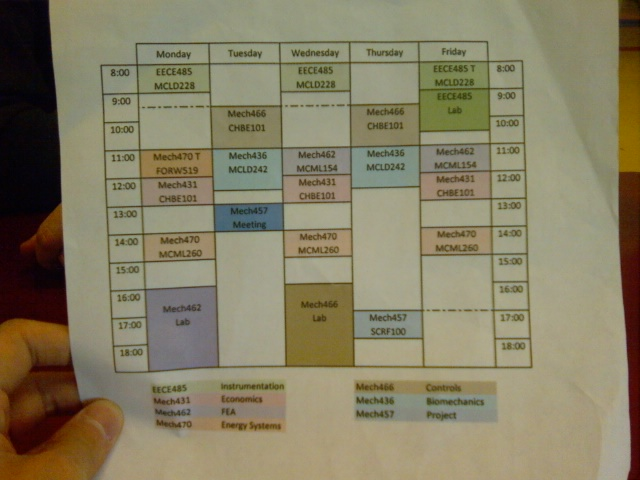
schedules/David.jpg
