minadanesh/apsc496/schedules/Davy.jpg

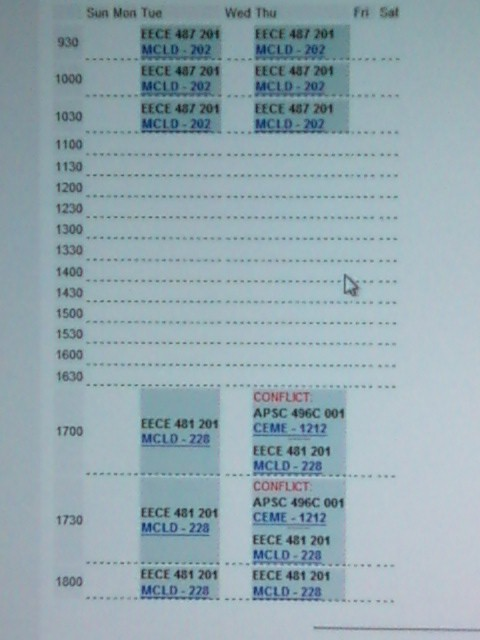
schedules/Davy.jpg
