minadanesh/apsc496/schedules/Nich.png

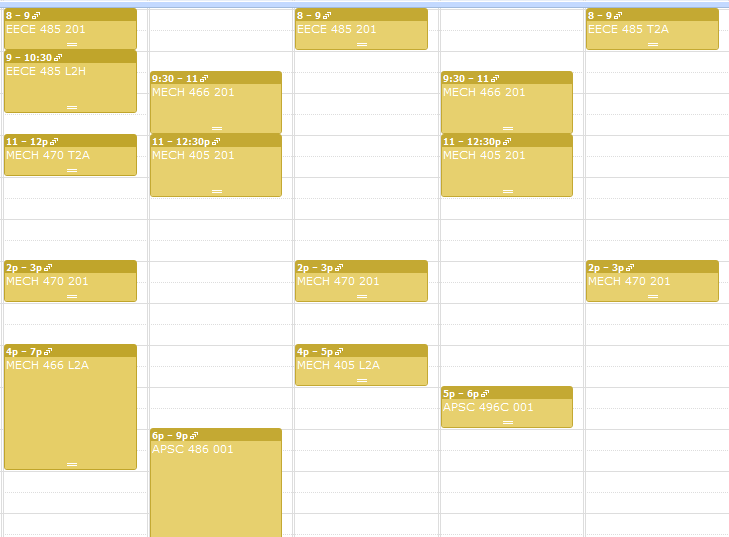
schedules/Nich.png
