minadanesh/apsc496/documents/BOM total.xls

Sheet: SKF
SKF
Part Number | QTY
618/7 | 4
618/4 | 10
618/6 | 2
619/4 | 2

Sheet: McMaster Carr
ALL FROM MCMASTER CARR |  |  | Unit Price | Total
Part # | QTY
8448k21 | 2 | Rubber gasket material | 7.86 | 15.72
92168a101 | 1 | M3 Wave Washers | 5.05 | 5.05
95263A122 | 1 | M3 Hex Cap Screws | 5.93 | 5.93
96445K227 | 1 | Disc Spring 7mm | 3.47 | 3.47
96475K221 | 2 | Disc Spring 4mm | 9 | 18
91828A255 | 1 | M7 Thin Hex Nuts | 4.34 | 4.34
90710A035 | 1 | M4 Thin Hex Nuts | 5.19 | 5.19
90270A655 | 3 | M4 Hex Cap Bolt | 2.57 | 7.71
91111A118 | 1 | 4mm Lockspring | 1.43 | 1.43
93849A103 | 2 | Washer/Bearing Spacer | 0.92 | 1.84
93395A147 | 1 | M2 Machine Screw | 4.53 | 4.53
92125A130 | 1 | M3 Machine Screw | 4.48 | 4.48
93475A250 | 1 | Bearing Spacer | 3.4 | 3.4
91111A132 | 1 | 13mm OD Washer | 5.4 | 5.4
90967A110 | 1 | Axle Retaining Ring | 4.69 | 4.69
93395A262 | 1 | M4 Machine Screw | 7.78 | 7.78
94205A250 (http://www.mcmaster.com/) | 1 | 6mm Hex Lock Nut | 6.52 | 6.52
8984K393 | 1 | 303 SS Round 1.5" | 29.96 | 29.96
9084K253 | 1 | 303 SS Flat 3/16" x 2" | 44.76 | 44.76
88915K221 | 1 | 303 SS Round .5" | 12.28 | 12.28
89665K691 | 1 | 303 SS Hex 9/16" | 9.6 | 9.6
9084K451 | 1 | 303 SS Flat 3/8" x 5/4" | 21.68 | 21.68
8984K183 | 1 | 303 SS Round 1" | 15.73 | 15.73
9084K681 | 1 | 303 SS Flat 5/8" x 1.5" | 35.33 | 35.33
9084K233 (http://www.mcmaster.com/itm/find.ASP?tab=find&context=psrchDtlLink&fasttrack=False&searchstring=9084K233) | 1 | 303 SS Flat 3/16" x 5/4" | 30.36 | 30.36
9084K564 (http://www.mcmaster.com/itm/find.ASP?tab=find&context=psrchDtlLink&fasttrack=False&searchstring=9084K564) | 1 | 303 SS Square 3" | 166.36 | 166.36
 |  |  | TOTAL: | 471.54
