minadanesh/apsc496/documents/Parts Left w Est Time.xlsx

Sheet: Waterjet
Part | Qty | Status
Primary Links | 2 | Complete
Secondary Links | 2 | Complete
H. Offset | 1 | In progress
Link 5 | 1 | Complete
Tool Mount | 1 | Complete
Link Caps | 5 | Complete

Sheet: Mill
Part | Status | Est Time Remaining
P Link 1 | Not started | 2
P link 2 | Not started | 2
S Link 1 | Not started | 2
S Link 2 | Not started | 2
H Offset | Waiting for WJ | 2
Link 5 | Waiting for drawing | 2
Tool Mount | Waiting for drawing | 1
Link Caps | Waiting for drawing | 6
Rotating Base | Needs tapping | 2
Link 3 | In progress | 3
V Offset | Not started | 5
 |  | 29

Sheet: Lathe
Part | Status | Est Time Remaining
Bone Mount | Not started | 3
Base Axles | Need tapping | 1
P Link Axle | Need tapping | 0.5
S Link Axle | Need tapping | 0.5
Link 3 Axles | Need tapping | 0.5
Link 5 Axle | Need tapping | 0.5
P Link Encoder Shaft | Not started | 1
Link 5 Encoder Shaft | Not started | 1
 |  | 8
