minadanesh/apsc496/design_documents/Praxim Models/Final Model/687.sldasm

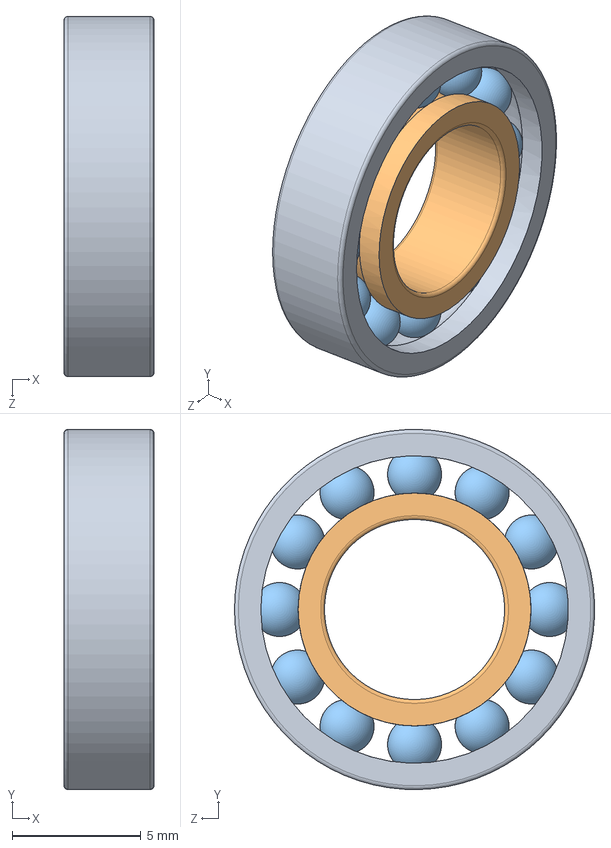
[picture p121: CAD file, 2010-04-12]
design_documents/Praxim Models/Final Model/687.sldasm
3.50 x 14.0 x 14.0 mm
687_Outer_Ring
687_Inner_Ring
687_Ball x 12
