minadanesh/apsc496/design_documents/Praxim Models/Tony idea/tony idea rough.SLDASM

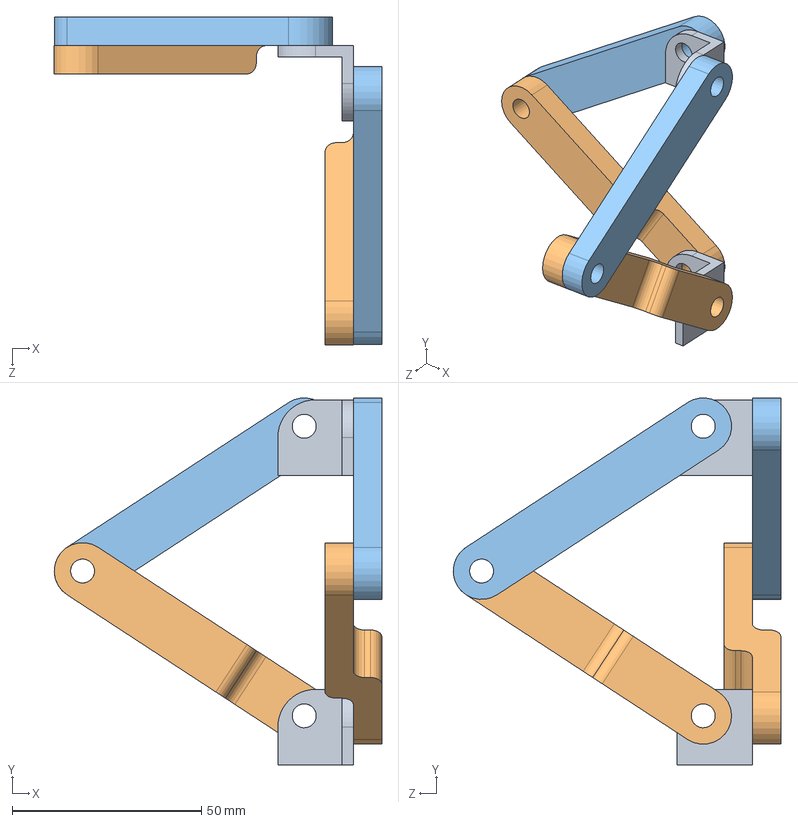
[picture p122: CAD file, 2010-02-20]
design_documents/Praxim Models/Tony idea/tony idea rough.SLDASM
86.6 x 97.0 x 86.6 mm
link1 x 2
link2 x 2
