minadanesh/apsc496/design_documents/Praxim Models/Version 3/AXK_2035.sldasm

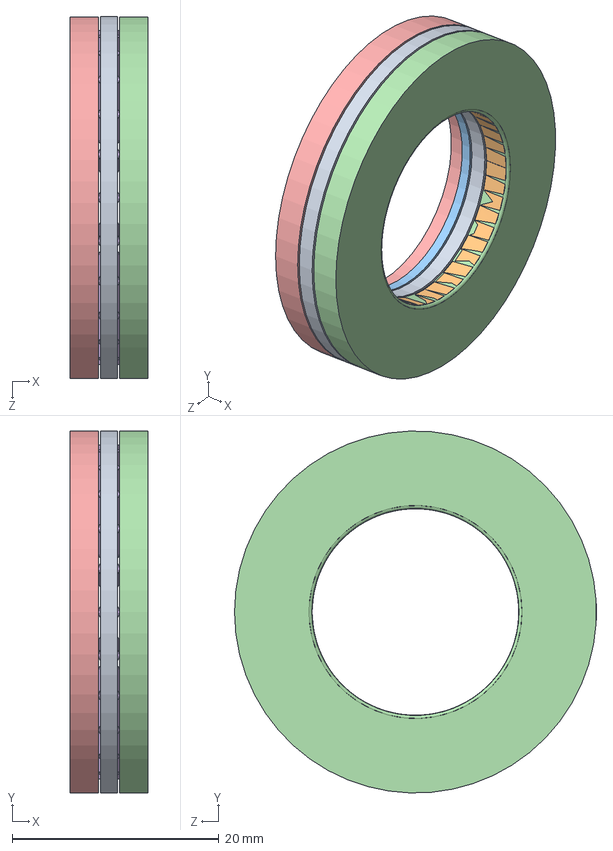
[picture p123: CAD file, 2010-02-20]
design_documents/Praxim Models/Version 3/AXK_2035.sldasm
7.50 x 35.0 x 35.0 mm
AXK_2035_PART1
AXK_2035_PART2
AXK_2035_PART3
AXK_2035_PART4
AXK_2035_PART5
AXK_2035_PART6 x 24
