minadanesh/apsc496/design_documents/Praxim Models/Final Model/MR74.sldasm

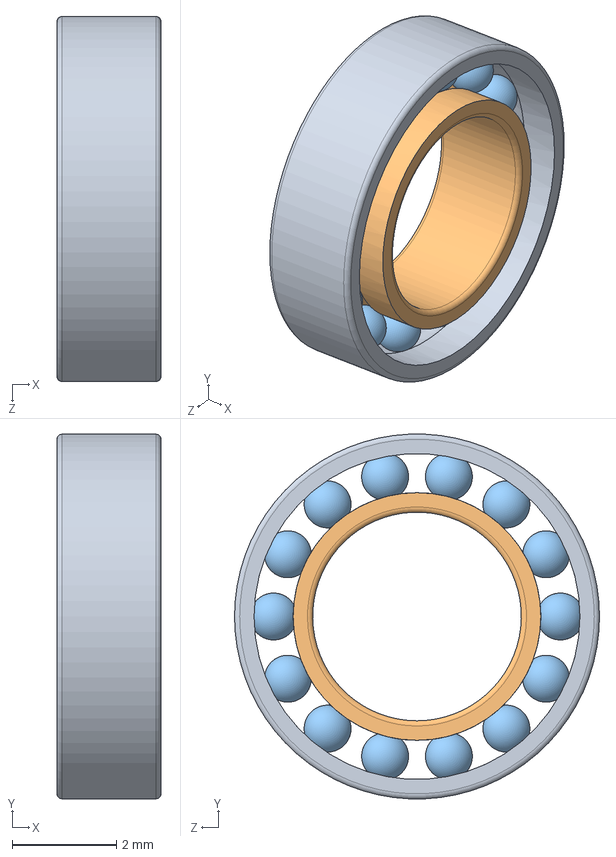
[picture p124: CAD file, 2010-04-12]
design_documents/Praxim Models/Final Model/MR74.sldasm
2.00 x 6.99 x 7.00 mm
MR74_Outer_Ring
MR74_Inner_Ring
MR74_Ball x 14
