minadanesh/apsc496/design_documents/Praxim Models/Final Model/Praxim Final.SLDASM

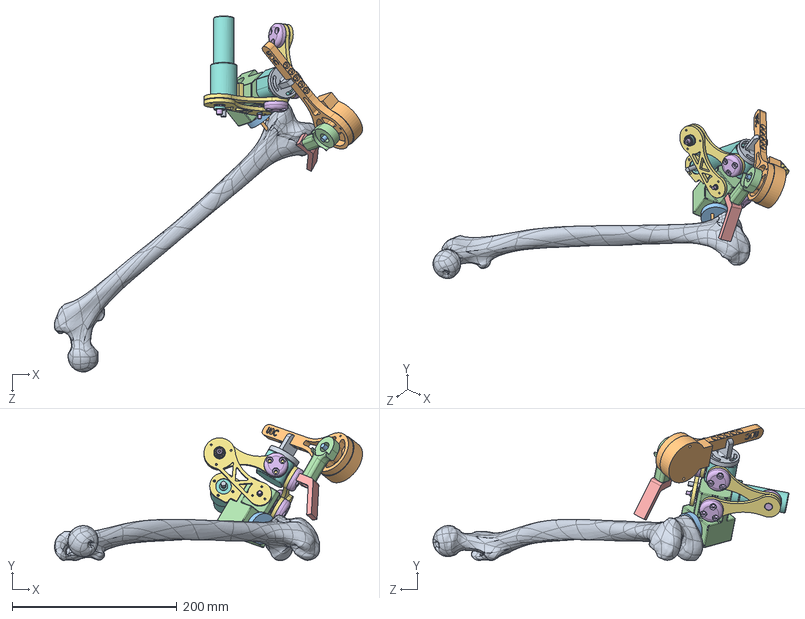
[picture p125: CAD file, 2010-04-12]
design_documents/Praxim Models/Final Model/Praxim Final.SLDASM
374.3 x 165.7 x 432.5 mm
SW3dPS-Large Human Femur
bone pin x 2
Bone Mount
Rotating Base
Axle Cap 1
Base Axle x 4
Primary Links x 2
687_Outer_Ring x 4
687_Inner_Ring x 4
687_Ball x 48
MR74_Outer_Ring x 10
MR74_Inner_Ring x 10
MR74_Ball x 140
link axke x 2
Seconday Links x 2
upper connection
vertical offset
h offeset v2
Tool Axle 1
Link 5
tool mount
Link Cap x 4
motor mount
motor
Motor Shart
LME-2000V-600K
