minadanesh/apsc496/design_documents/Praxim Models/Final Model/Primary Links.SLDPRT

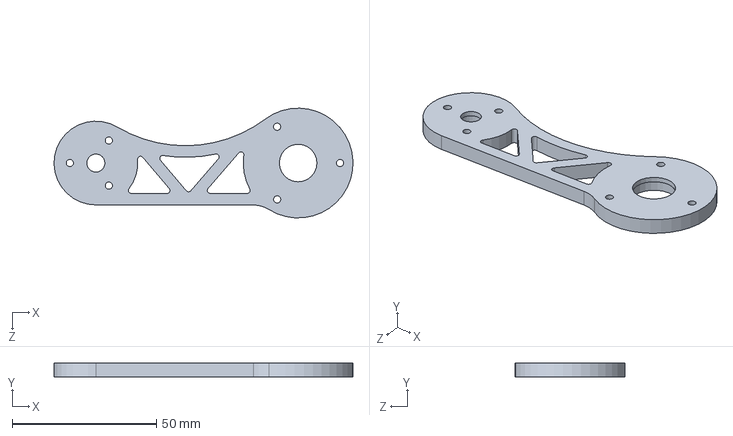
[picture p126: CAD file, 2010-04-12]
design_documents/Praxim Models/Final Model/Primary Links.SLDPRT
103.5 x 4.76 x 38.0 mm
