minadanesh/apsc496/design_documents/Praxim Models/Tony idea/link2.SLDPRT

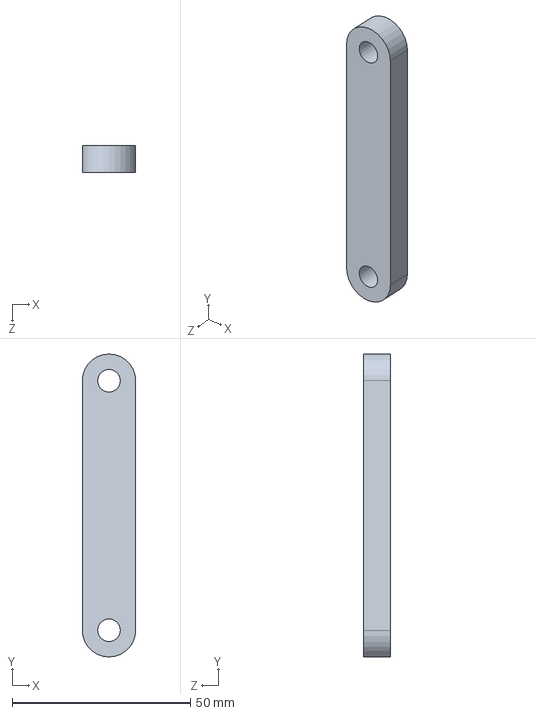
[picture p127: CAD file, 2010-02-20]
design_documents/Praxim Models/Tony idea/link2.SLDPRT
15.0 x 85.0 x 7.50 mm
