minadanesh/apsc496/design_documents/Praxim Models/Version 3/AXK_2035_PART3.sldprt

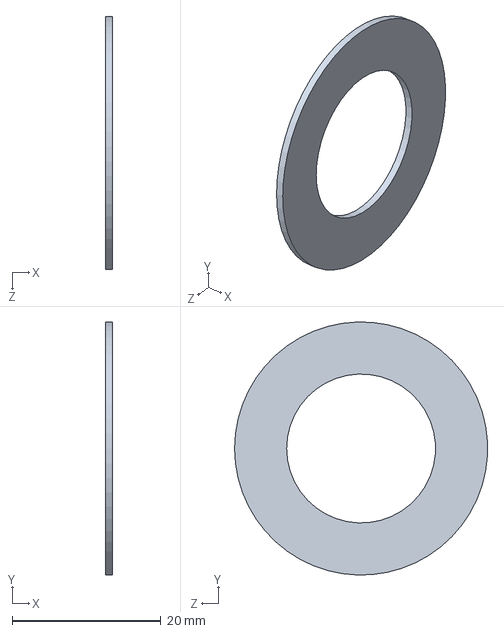
[picture p128: CAD file, 2010-02-20]
design_documents/Praxim Models/Version 3/AXK_2035_PART3.sldprt
1.00 x 34.0 x 34.0 mm
