minadanesh/apsc496/design_documents/Praxim Models/Tony idea/Part1.SLDPRT

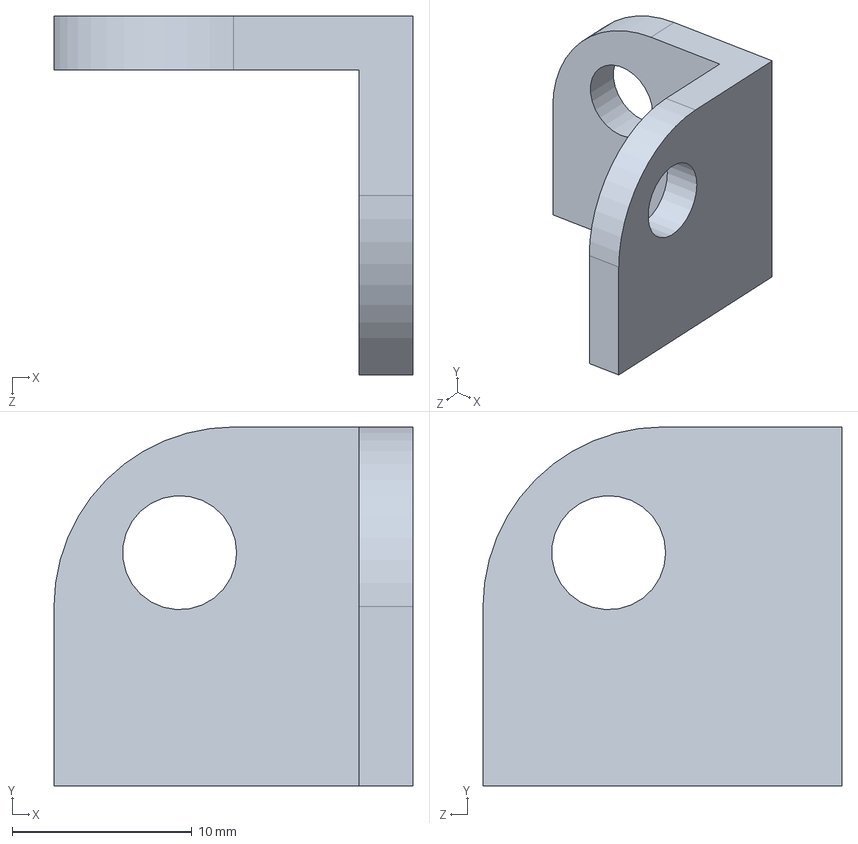
[picture p129: CAD file, 2010-02-20]
design_documents/Praxim Models/Tony idea/Part1.SLDPRT
20.0 x 20.0 x 20.0 mm
