minadanesh/apsc496/design_documents/Praxim Models/Version 3/Link 2_v3.SLDPRT

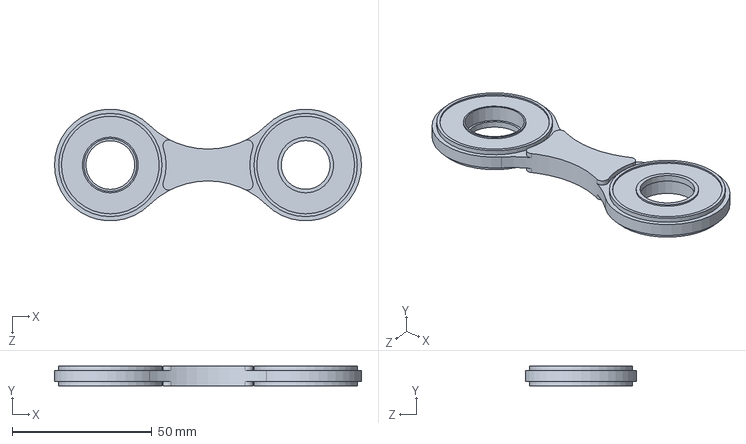
[picture p130: CAD file, 2010-02-20]
design_documents/Praxim Models/Version 3/Link 2_v3.SLDPRT
110.0 x 7.00 x 39.9 mm
