minadanesh/apsc496/design_documents/Praxim Models/Final Model/MR74_Outer_Ring.sldprt

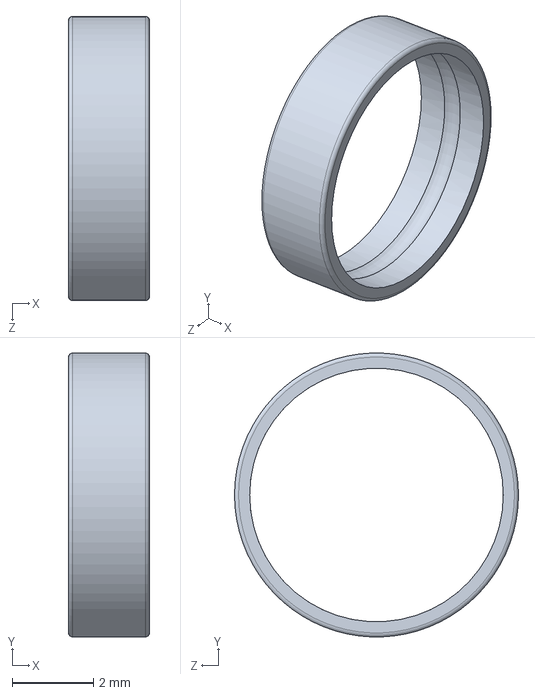
[picture p131: CAD file, 2010-04-12]
design_documents/Praxim Models/Final Model/MR74_Outer_Ring.sldprt
2.00 x 6.99 x 7.00 mm
