minadanesh/apsc496/design_documents/Praxim Models/Version 3/End Cap.SLDPRT

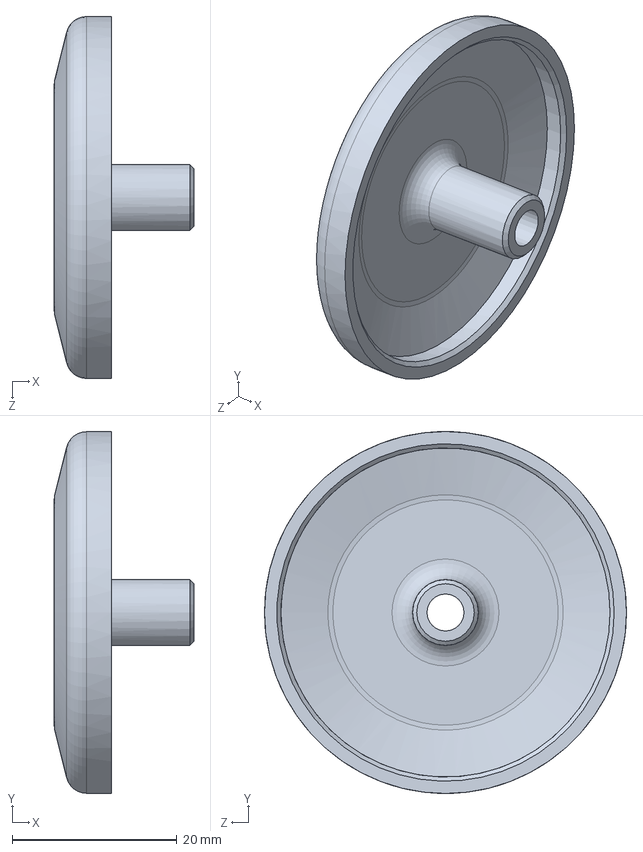
[picture p132: CAD file, 2010-02-20]
design_documents/Praxim Models/Version 3/End Cap.SLDPRT
17.0 x 44.0 x 44.0 mm
