minadanesh/apsc496/design_documents/Praxim Models/Final Model/687_Ball.sldprt

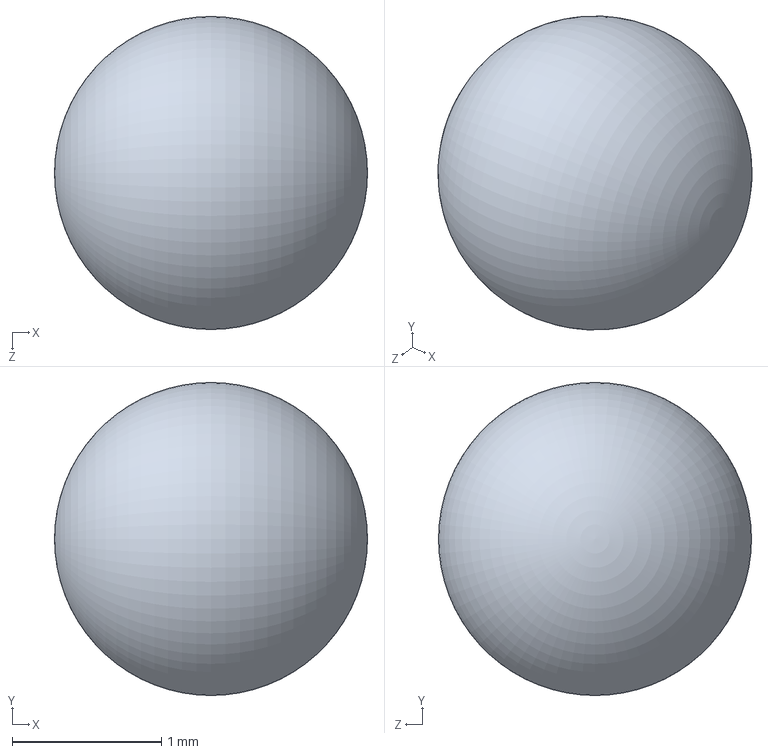
[picture p133: CAD file, 2010-04-12]
design_documents/Praxim Models/Final Model/687_Ball.sldprt
2.10 x 2.10 x 2.10 mm
