minadanesh/apsc496/design_documents/Praxim Models/Tony idea/link1.SLDPRT

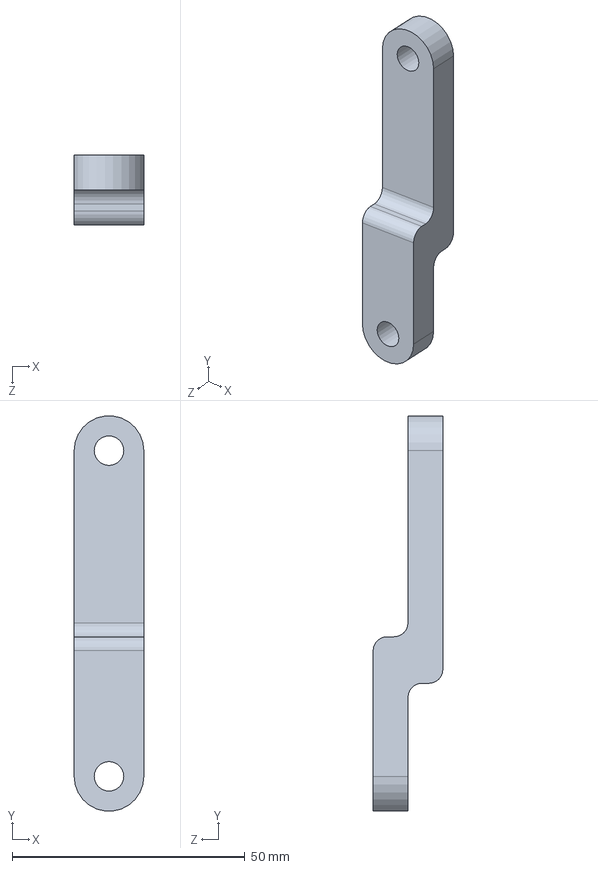
[picture p134: CAD file, 2010-02-20]
design_documents/Praxim Models/Tony idea/link1.SLDPRT
15.0 x 84.9 x 15.0 mm
