minadanesh/apsc496/design_documents/Praxim Models/Version 3/AXK_2035_PART2.sldprt

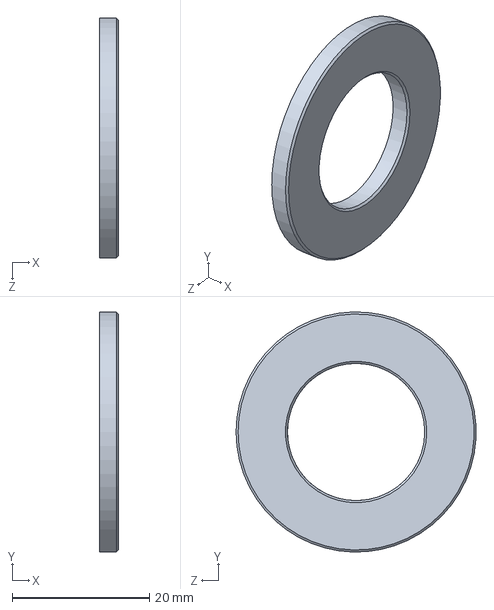
[picture p135: CAD file, 2010-02-20]
design_documents/Praxim Models/Version 3/AXK_2035_PART2.sldprt
2.75 x 35.0 x 35.0 mm
