minadanesh/apsc496/design_documents/Praxim Models/Final Model/motor.SLDPRT

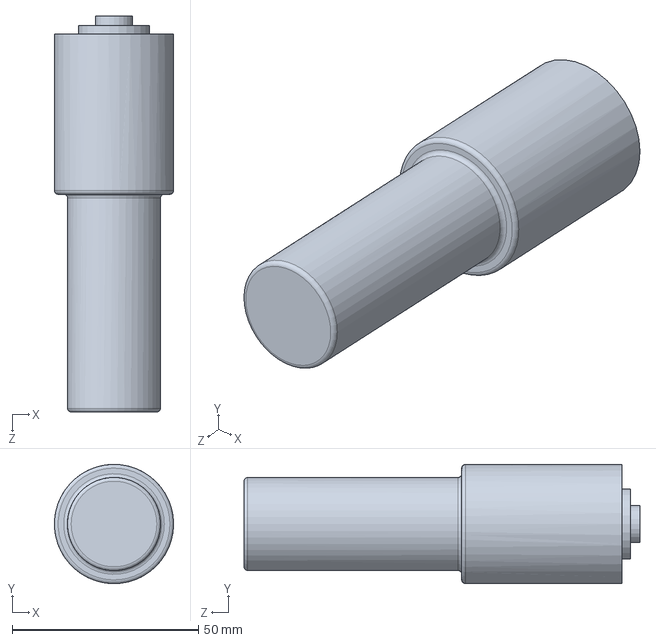
[picture p136: CAD file, 2010-04-12]
design_documents/Praxim Models/Final Model/motor.SLDPRT
32.0 x 32.0 x 106.2 mm
