minadanesh/apsc496/design_documents/Praxim Models/Version 3/AXK_2035_PART6.sldprt

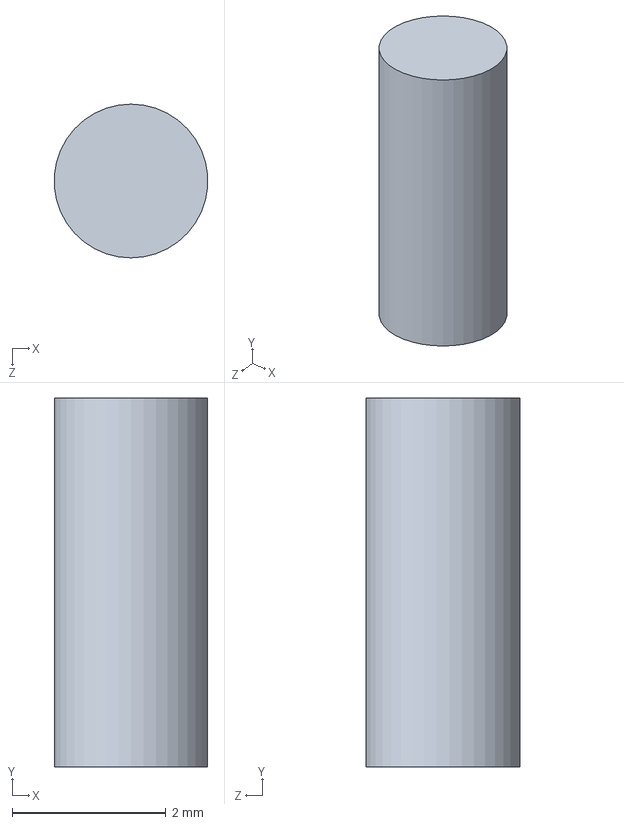
[picture p137: CAD file, 2010-02-20]
design_documents/Praxim Models/Version 3/AXK_2035_PART6.sldprt
1.99 x 4.80 x 2.00 mm
