minadanesh/apsc496/design_documents/Praxim Models/Final Model/LME-2000V-600K.SLDPRT

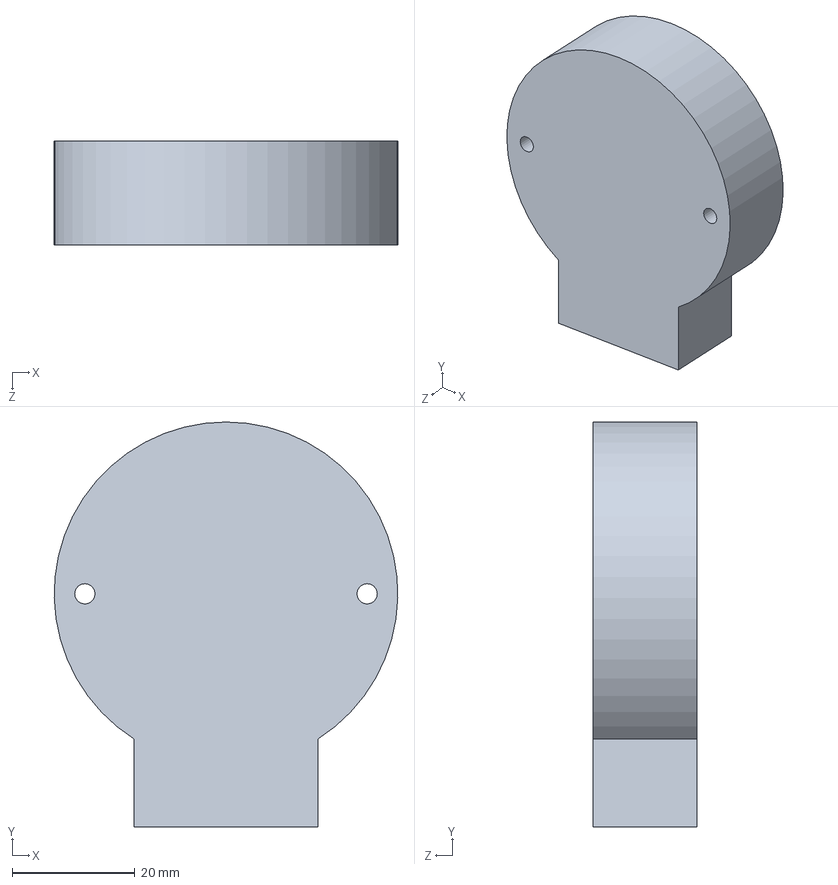
[picture p138: CAD file, 2010-04-12]
design_documents/Praxim Models/Final Model/LME-2000V-600K.SLDPRT
56.0 x 66.0 x 17.0 mm
