minadanesh/apsc496/design_documents/Praxim Models/Version 3/TRD-SH2500-BD.SLDPRT

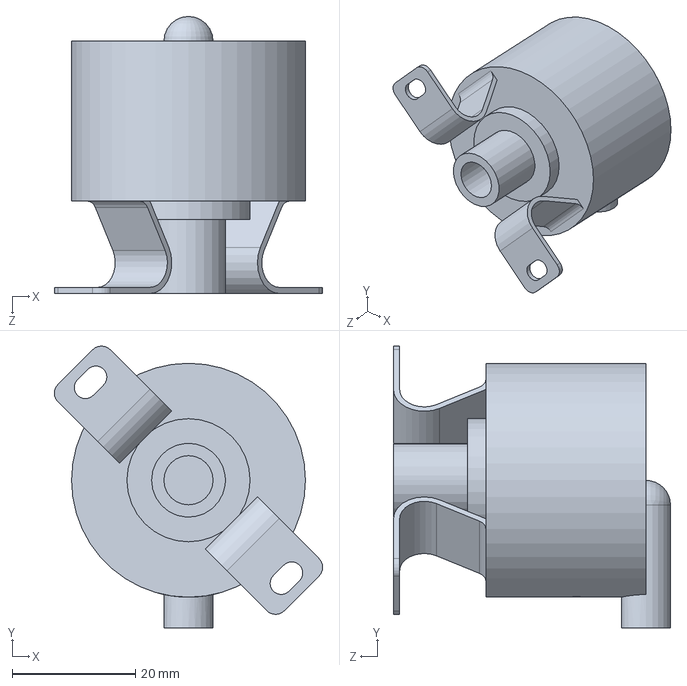
[picture p139: CAD file, 2010-02-20]
design_documents/Praxim Models/Version 3/TRD-SH2500-BD.SLDPRT
43.6 x 45.8 x 45.0 mm
