minadanesh/apsc496/design_documents/Praxim Models/Final Model/link axke.SLDPRT

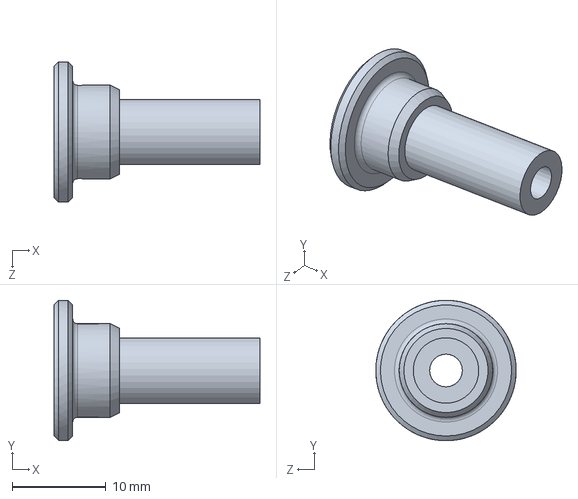
[picture p140: CAD file, 2010-04-12]
design_documents/Praxim Models/Final Model/link axke.SLDPRT
22.0 x 15.0 x 15.0 mm
