minadanesh/apsc496/design_documents/Praxim Models/Version 3/Shaft Attachment.SLDPRT

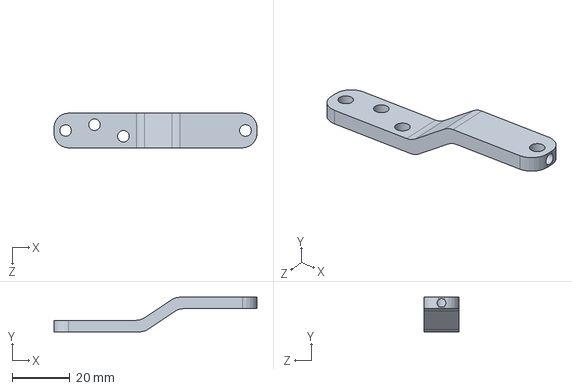
[picture p141: CAD file, 2010-02-20]
design_documents/Praxim Models/Version 3/Shaft Attachment.SLDPRT
70.2 x 12.0 x 12.0 mm
