minadanesh/apsc496/design_documents/Praxim Models/Final Model/Rotating Base.SLDPRT

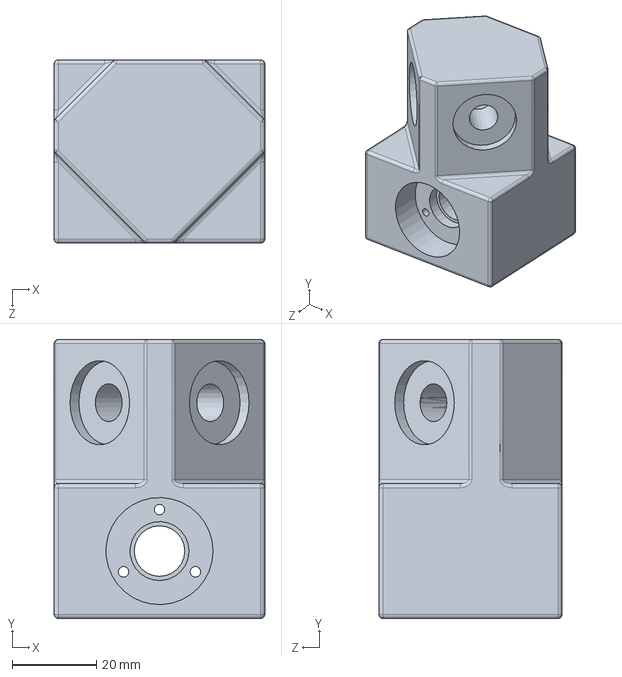
[picture p142: CAD file, 2010-04-12]
design_documents/Praxim Models/Final Model/Rotating Base.SLDPRT
50.0 x 66.2 x 43.5 mm
