minadanesh/apsc496/design_documents/Praxim Models/Final Model/687_Outer_Ring.sldprt

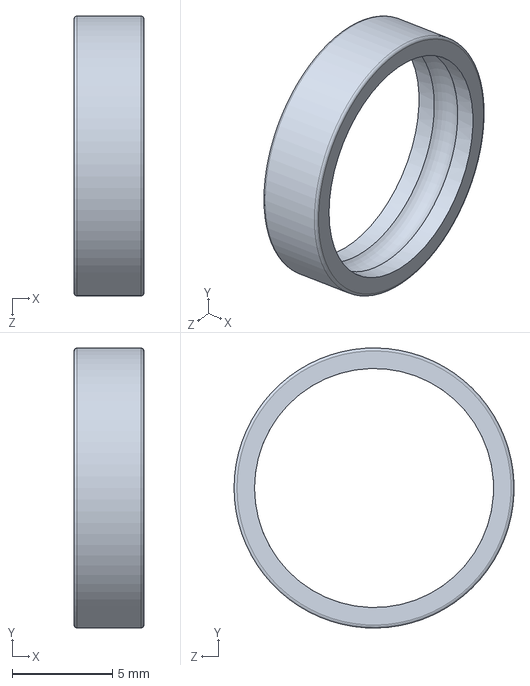
[picture p143: CAD file, 2010-04-12]
design_documents/Praxim Models/Final Model/687_Outer_Ring.sldprt
3.50 x 14.0 x 14.0 mm
