minadanesh/apsc496/design_documents/Praxim Models/Version 3/Encoder Shaft.SLDPRT

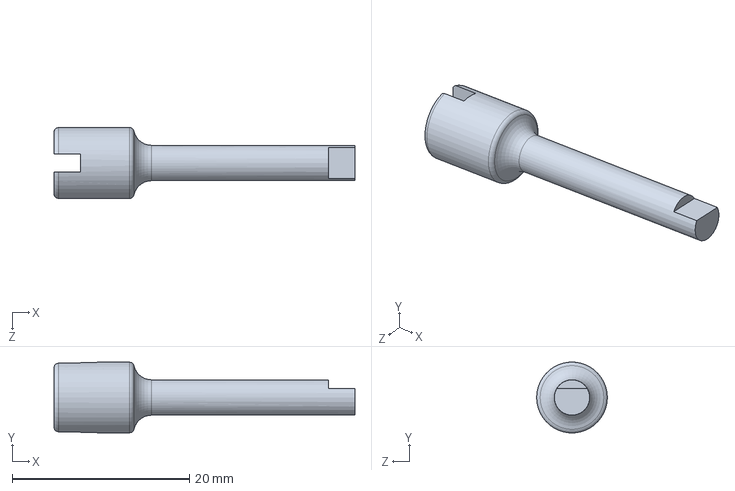
[picture p144: CAD file, 2010-02-20]
design_documents/Praxim Models/Version 3/Encoder Shaft.SLDPRT
34.0 x 7.98 x 8.00 mm
