minadanesh/apsc496/design_documents/Praxim Models/Final Model/Seconday Links.SLDPRT

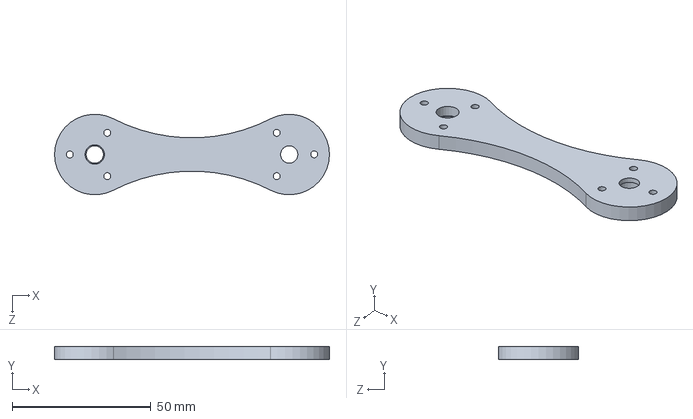
[picture p145: CAD file, 2010-04-12]
design_documents/Praxim Models/Final Model/Seconday Links.SLDPRT
99.0 x 4.76 x 28.9 mm
