minadanesh/apsc496/design_documents/Praxim Models/Final Model/Link Cap.SLDPRT

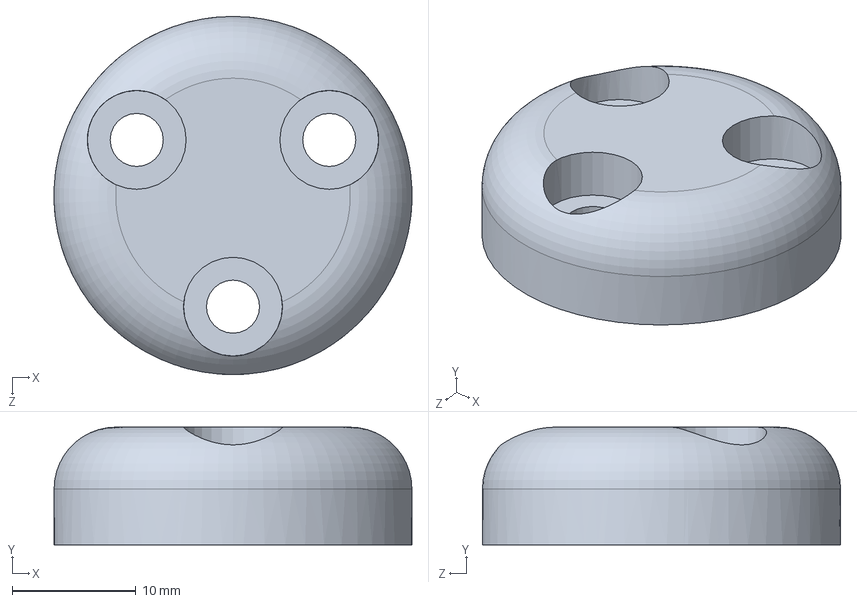
[picture p146: CAD file, 2010-04-12]
design_documents/Praxim Models/Final Model/Link Cap.SLDPRT
29.0 x 9.53 x 29.0 mm
