minadanesh/apsc496/design_documents/Praxim Models/Final Model/h offeset v2.SLDPRT

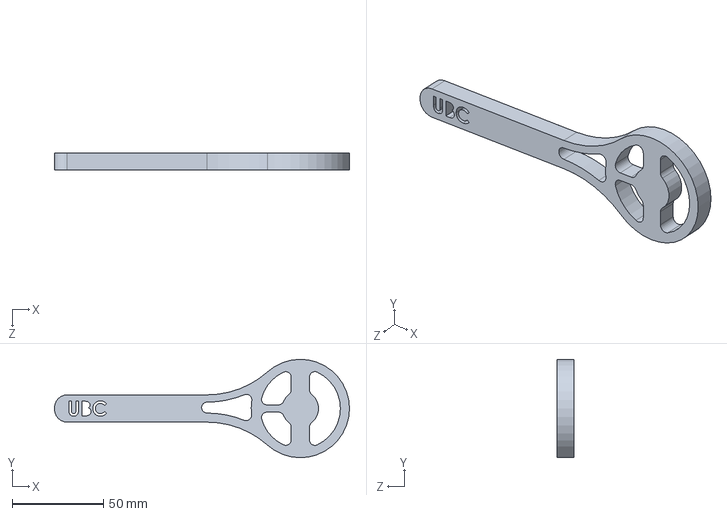
[picture p148: CAD file, 2010-04-12]
design_documents/Praxim Models/Final Model/h offeset v2.SLDPRT
162.0 x 54.0 x 9.53 mm
