minadanesh/apsc496/design_documents/Praxim Models/Version 3/Dust Seal.SLDPRT

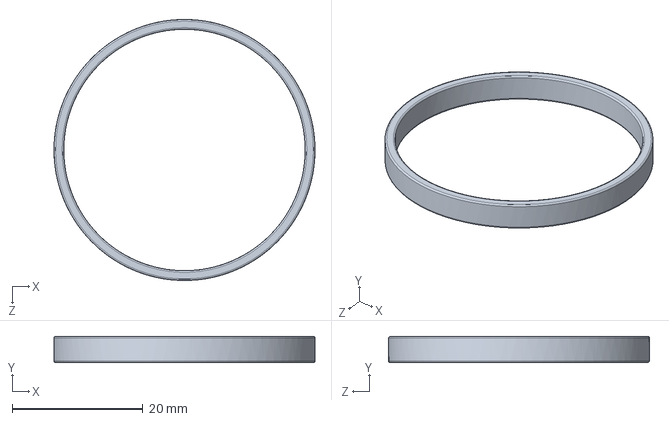
[picture p149: CAD file, 2010-02-20]
design_documents/Praxim Models/Version 3/Dust Seal.SLDPRT
40.0 x 4.00 x 40.0 mm
