minadanesh/apsc496/design_documents/Praxim Models/Final Model/Link 5.SLDPRT

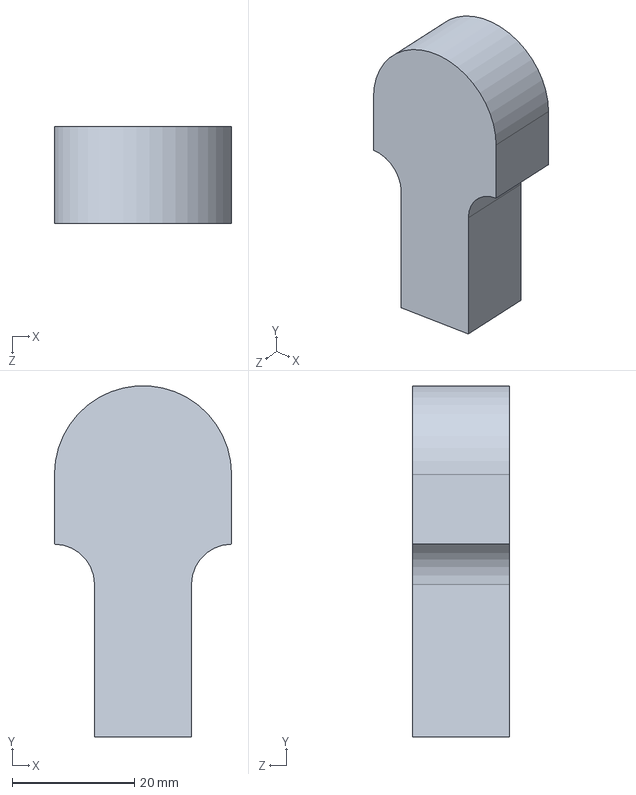
[picture p150: CAD file, 2010-04-12]
design_documents/Praxim Models/Final Model/Link 5.SLDPRT
29.0 x 57.5 x 15.9 mm
