minadanesh/apsc496/design_documents/Praxim Models/Version 3/Link 1_v3.SLDPRT

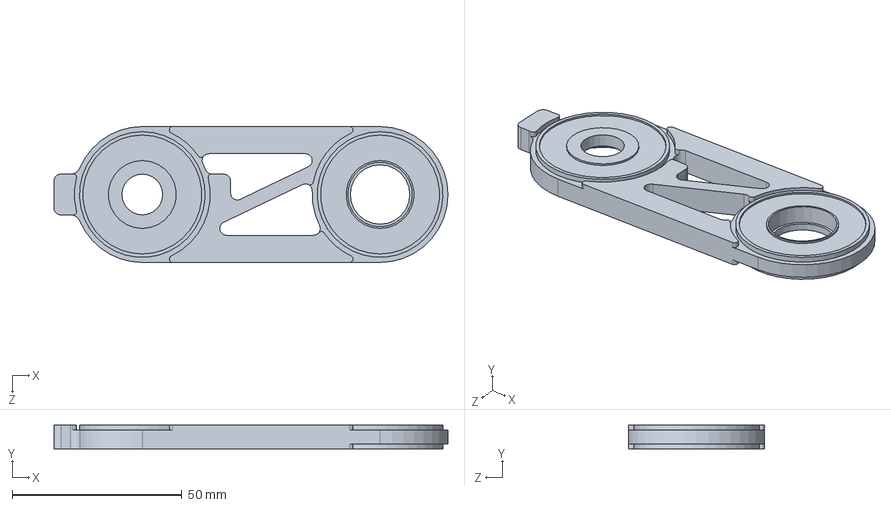
[picture p151: CAD file, 2010-02-20]
design_documents/Praxim Models/Version 3/Link 1_v3.SLDPRT
116.0 x 7.00 x 40.0 mm
