minadanesh/apsc496/design_documents/Praxim Models/Final Model/Motor Shart.SLDPRT

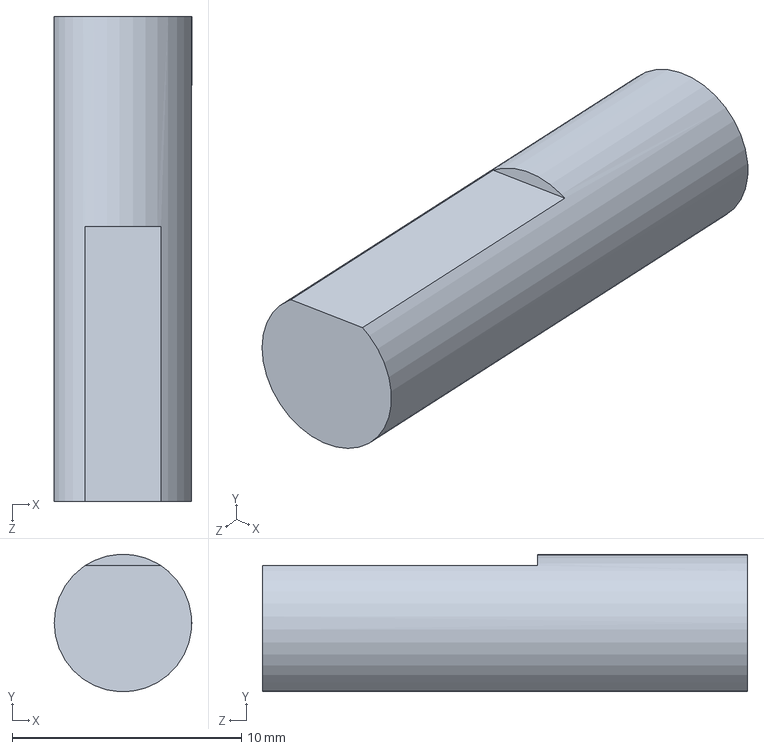
[picture p152: CAD file, 2010-04-12]
design_documents/Praxim Models/Final Model/Motor Shart.SLDPRT
6.00 x 5.99 x 21.1 mm
