minadanesh/apsc496/design_documents/Praxim Models/Version 3/AS2035.SLDPRT

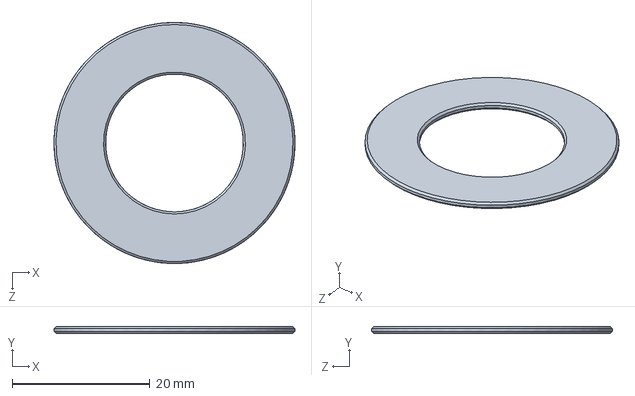
[picture p153: CAD file, 2010-02-20]
design_documents/Praxim Models/Version 3/AS2035.SLDPRT
35.0 x 1.00 x 35.0 mm
