minadanesh/apsc496/design_documents/Praxim Models/Final Model/Tool Axle 1.SLDPRT

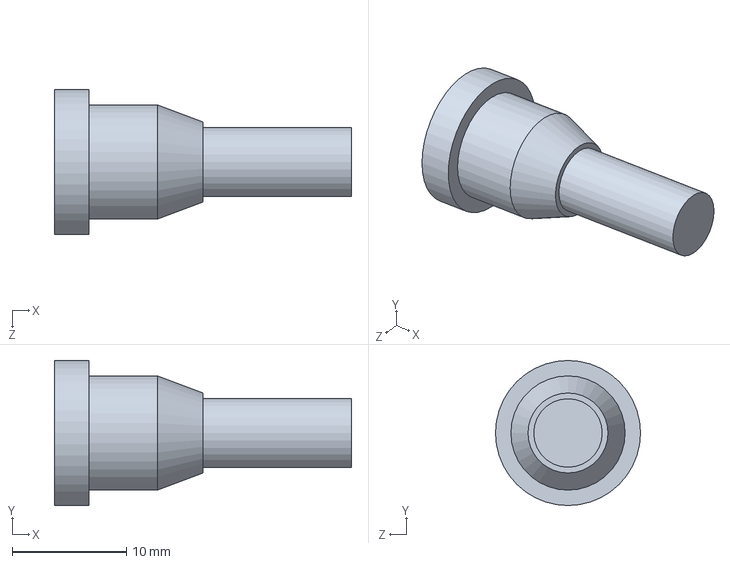
[picture p154: CAD file, 2010-04-12]
design_documents/Praxim Models/Final Model/Tool Axle 1.SLDPRT
26.0 x 12.7 x 12.7 mm
