minadanesh/apsc496/design_documents/Praxim Models/Version 3/AXK_2035_PART1.sldprt

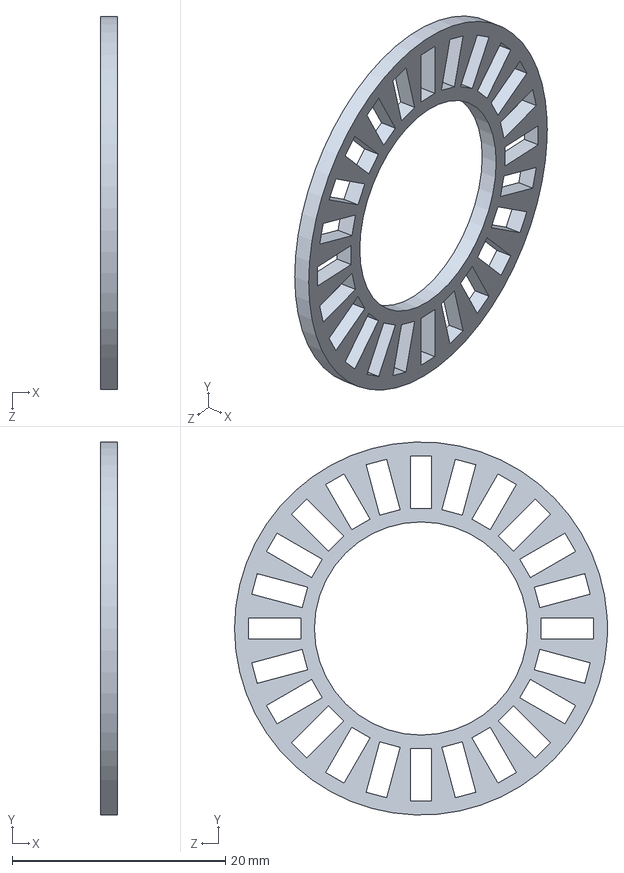
[picture p155: CAD file, 2010-02-20]
design_documents/Praxim Models/Version 3/AXK_2035_PART1.sldprt
1.60 x 35.0 x 35.0 mm
