minadanesh/apsc496/design_documents/Praxim Models/Final Model/Base Axle.SLDPRT

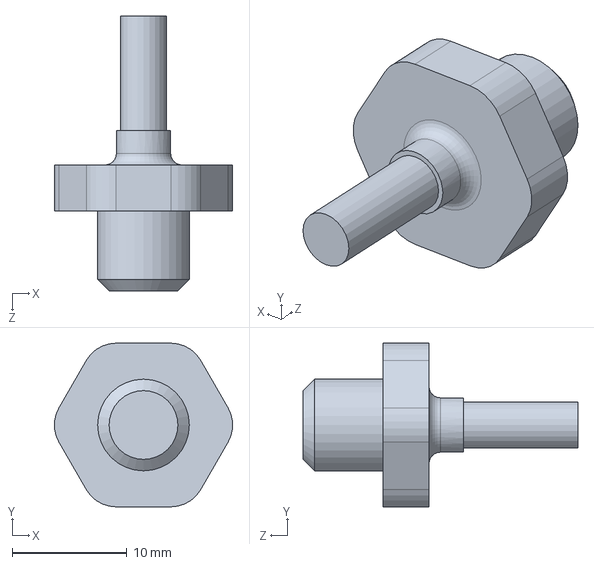
[picture p156: CAD file, 2010-04-12]
design_documents/Praxim Models/Final Model/Base Axle.SLDPRT
15.5 x 14.3 x 24.0 mm
