minadanesh/apsc496/design_documents/Praxim Models/Version 3/axle.SLDPRT

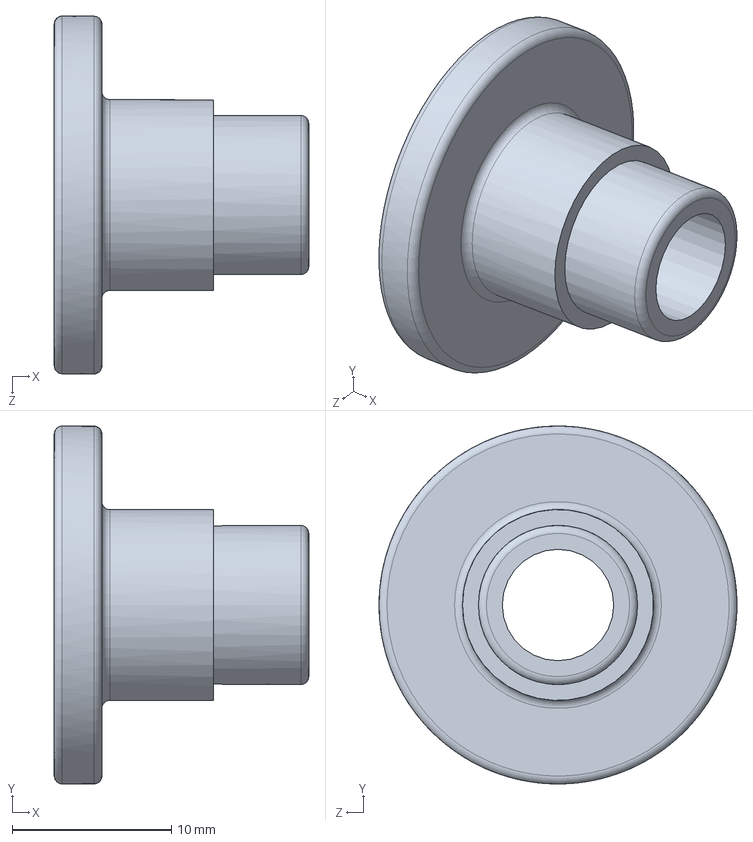
[picture p157: CAD file, 2010-02-20]
design_documents/Praxim Models/Version 3/axle.SLDPRT
16.0 x 22.5 x 22.5 mm
