minadanesh/apsc496/design_documents/Praxim Models/Final Model/vertical offset.SLDPRT

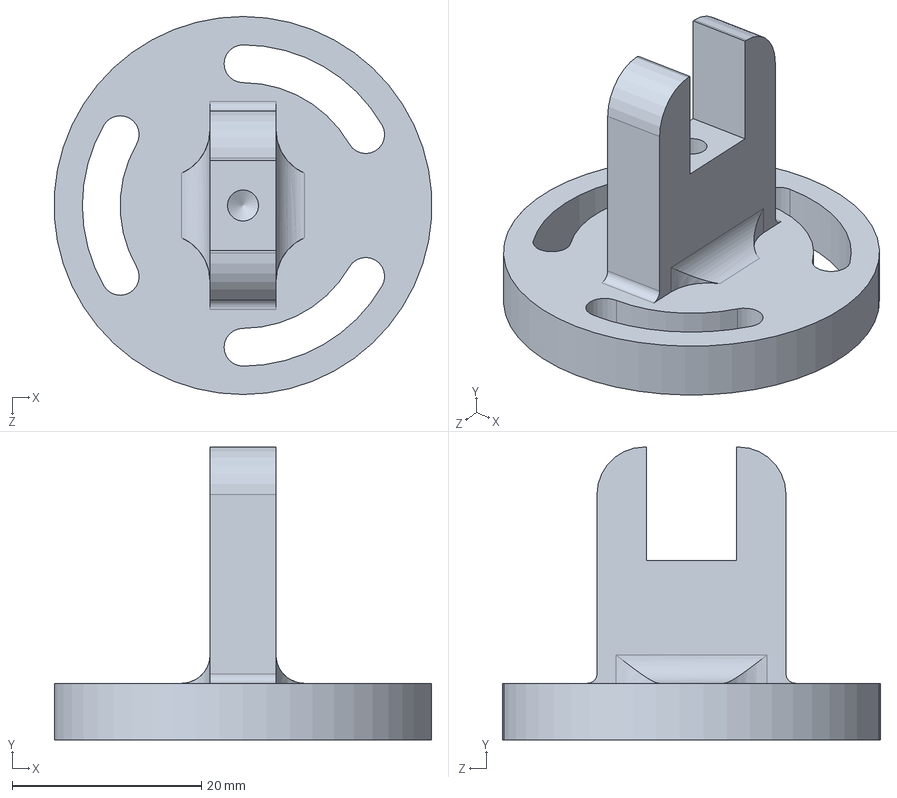
[picture p158: CAD file, 2010-04-12]
design_documents/Praxim Models/Final Model/vertical offset.SLDPRT
39.9 x 31.0 x 40.0 mm
