minadanesh/apsc496/design_documents/Praxim Models/Final Model/Bone Mount.SLDPRT

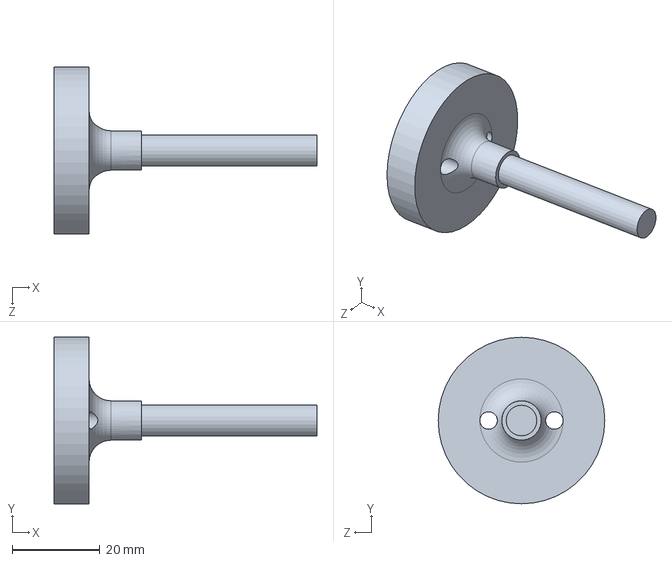
[picture p159: CAD file, 2010-04-12]
design_documents/Praxim Models/Final Model/Bone Mount.SLDPRT
60.0 x 38.0 x 38.0 mm
