minadanesh/apsc496/design_documents/Praxim Models/Final Model/Axle Cap 1.SLDPRT

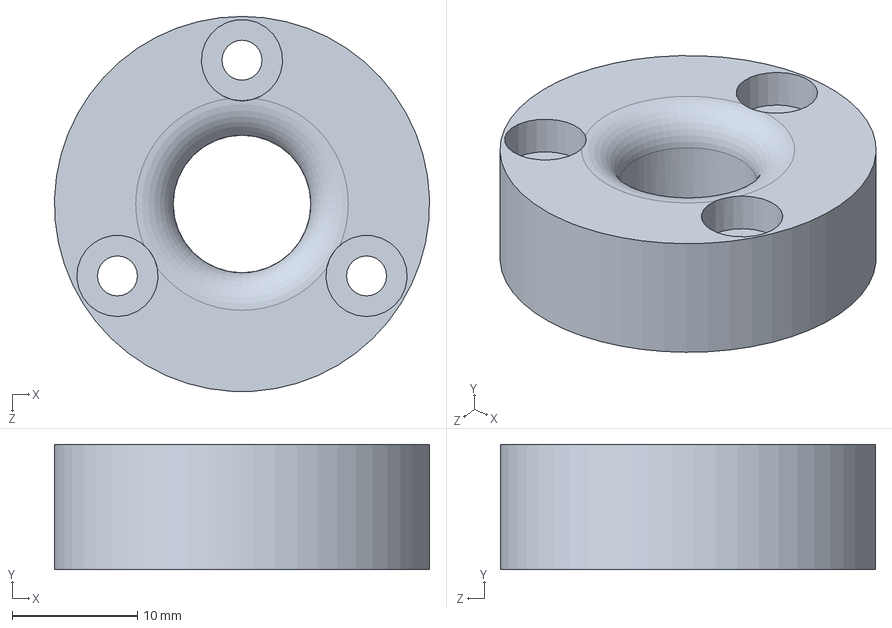
[picture p160: CAD file, 2010-04-12]
design_documents/Praxim Models/Final Model/Axle Cap 1.SLDPRT
30.0 x 10.0 x 30.0 mm
