minadanesh/apsc496/design_documents/Praxim Models/Final Model/MR74_Ball.sldprt

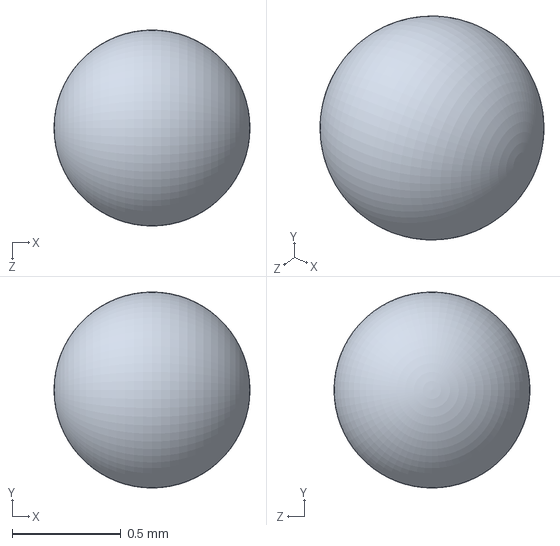
[picture p161: CAD file, 2010-04-12]
design_documents/Praxim Models/Final Model/MR74_Ball.sldprt
0.9 x 0.9 x 0.9 mm
