minadanesh/apsc496/design_documents/Praxim Models/Final Model/bone pin.SLDPRT

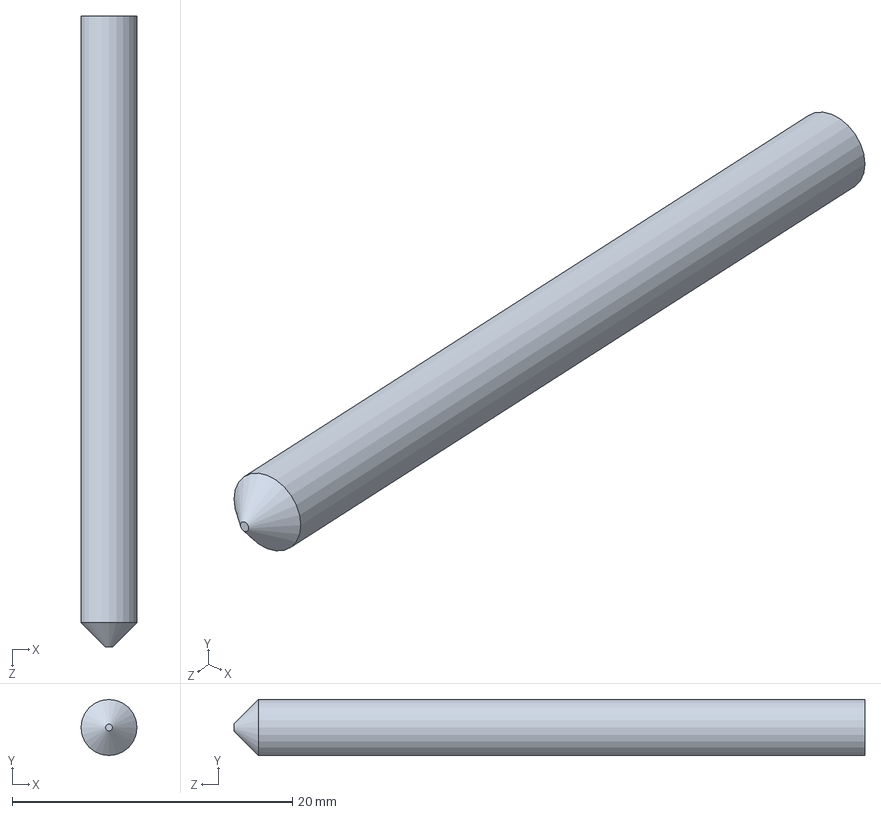
[picture p162: CAD file, 2010-04-12]
design_documents/Praxim Models/Final Model/bone pin.SLDPRT
4.00 x 4.00 x 45.0 mm
