minadanesh/apsc496/design_documents/Praxim Models/Final Model/tool mount.SLDPRT

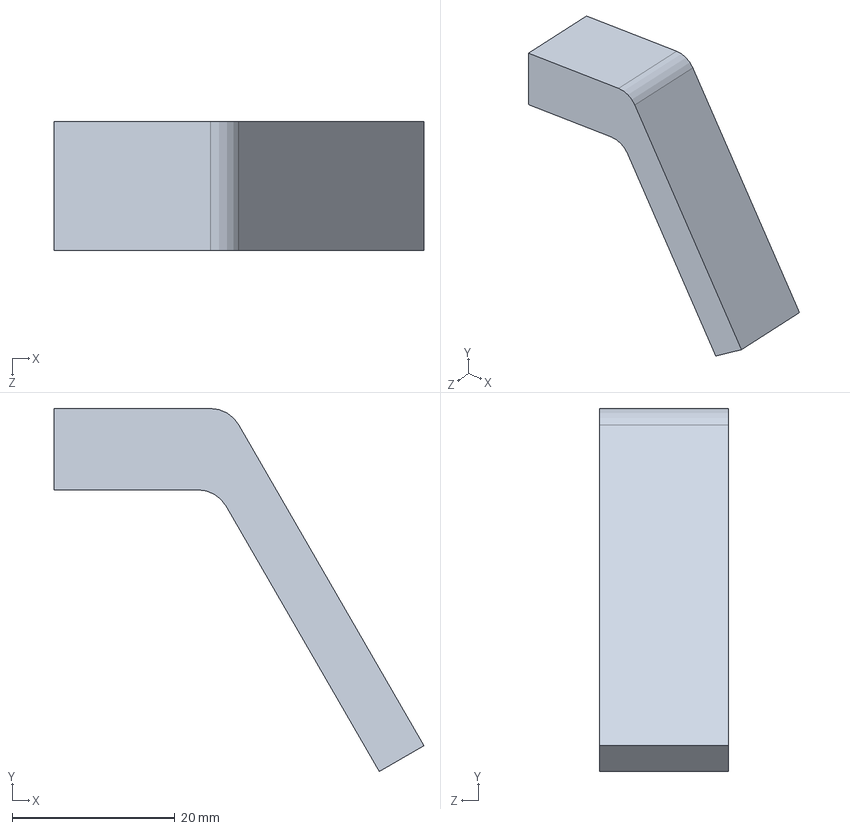
[picture p163: CAD file, 2010-04-12]
design_documents/Praxim Models/Final Model/tool mount.SLDPRT
45.5 x 44.6 x 15.9 mm
