minadanesh/apsc496/design_documents/Praxim Models/Final Model/primary cap.SLDPRT

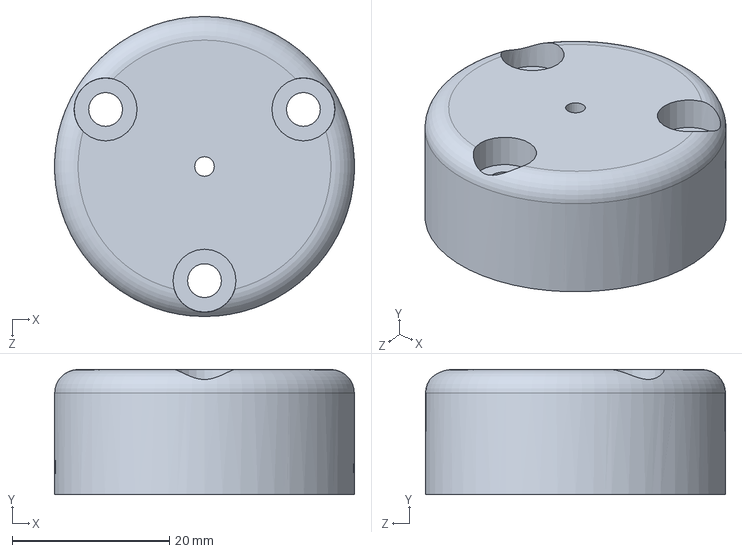
[picture p164: CAD file, 2010-04-12]
design_documents/Praxim Models/Final Model/primary cap.SLDPRT
38.1 x 15.9 x 38.1 mm
