minadanesh/apsc496/design_documents/Praxim Models/Final Model/upper connection.SLDPRT

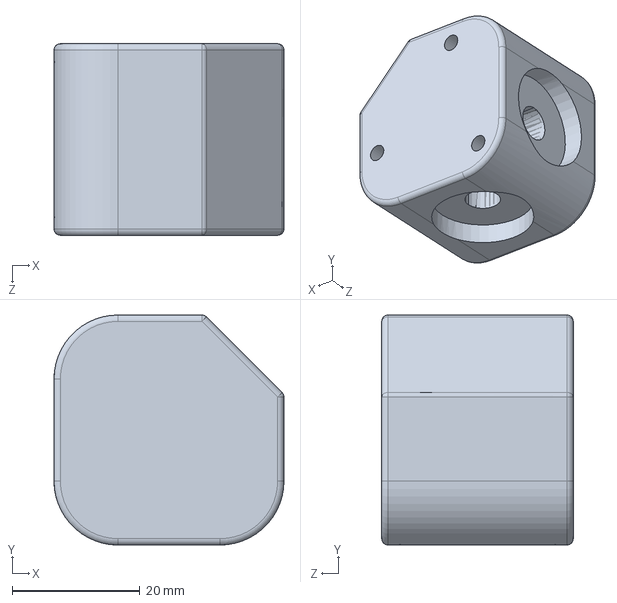
[picture p165: CAD file, 2010-04-12]
design_documents/Praxim Models/Final Model/upper connection.SLDPRT
36.0 x 36.0 x 30.0 mm
