minadanesh/apsc496/design_documents/Praxim Models/Final Model/MR74_Inner_Ring.sldprt

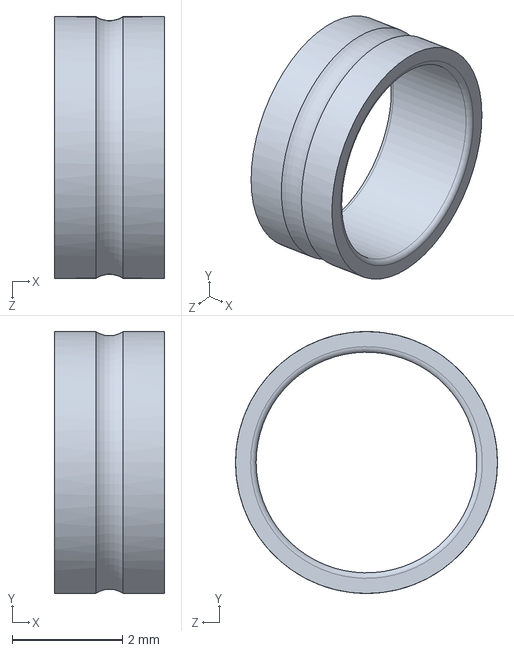
[picture p166: CAD file, 2010-04-12]
design_documents/Praxim Models/Final Model/MR74_Inner_Ring.sldprt
2.00 x 4.75 x 4.75 mm
