minadanesh/apsc496/design_documents/Praxim Models/Final Model/687_Inner_Ring.sldprt

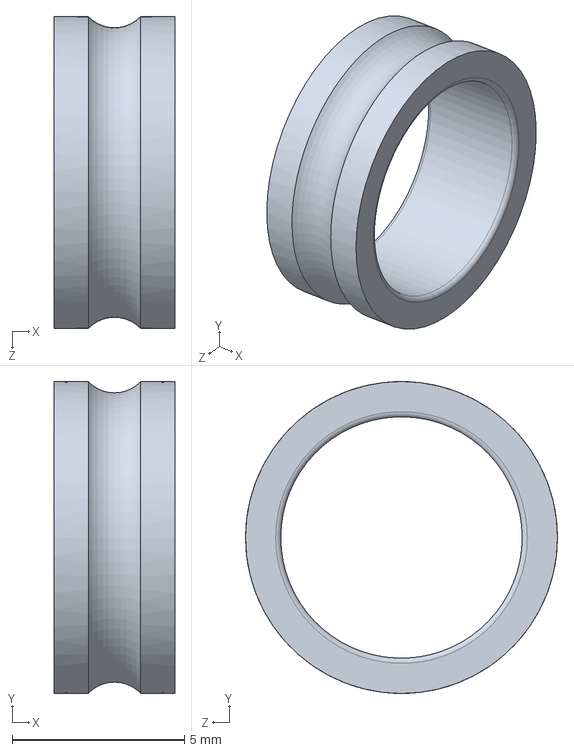
[picture p167: CAD file, 2010-04-12]
design_documents/Praxim Models/Final Model/687_Inner_Ring.sldprt
3.50 x 9.05 x 9.05 mm
