minadanesh/apsc496/design_documents/Praxim Models/Final Model/motor mount.SLDPRT

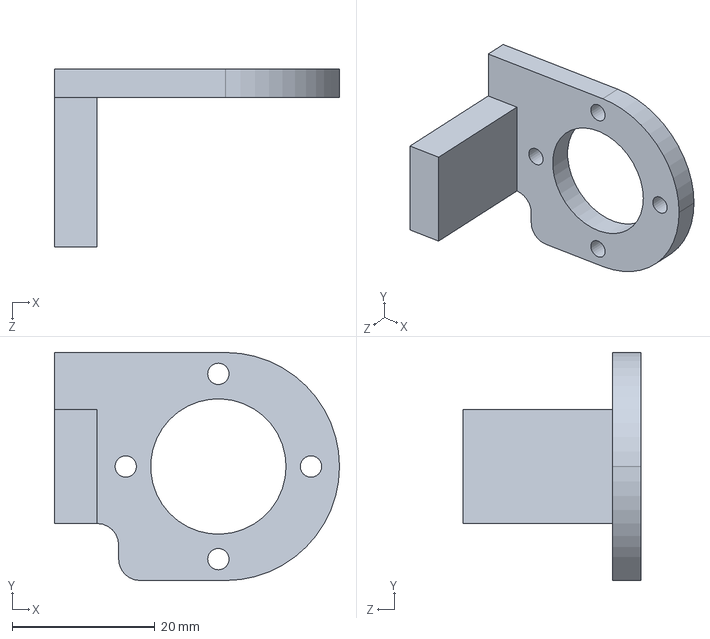
[picture p168: CAD file, 2010-04-12]
design_documents/Praxim Models/Final Model/motor mount.SLDPRT
40.0 x 32.0 x 25.0 mm
