minadanesh/apsc496/(list of files, cad)

Other CAD files:
design_documents/Praxim Models/Version 3/AXK_2035_PART5.sldprt
design_documents/Praxim Models/Version 3/Part1.SLDPRT
design_documents/Praxim Models/Final Model/Lathe Drawings.SLDDRW
design_documents/Praxim Models/Final Model/Link 5.SLDDRW
design_documents/Praxim Models/Final Model/Link Profiles.SLDDRW
design_documents/Praxim Models/Final Model/Links.SLDDRW
design_documents/Praxim Models/Final Model/Rotating Base.SLDDRW
design_documents/Praxim Models/Final Model/Seconday Links.SLDDRW
design_documents/Praxim Models/Final Model/h offeset v2.SLDDRW
design_documents/Praxim Models/Final Model/h offset.SLDDRW
design_documents/Praxim Models/Version 2/3200_A_2RS1TN9_MT33.sldasm
design_documents/Praxim Models/Version 2/3200_A_2RS1TN9_MT33_PART1.sldprt
design_documents/Praxim Models/Version 2/3200_A_2RS1TN9_MT33_PART2.sldprt
design_documents/Praxim Models/Version 2/3200_A_2RS1TN9_MT33_PART3.sldprt
design_documents/Praxim Models/Version 2/3200_A_2RS1TN9_MT33_PART4.sldprt
design_documents/Praxim Models/Version 2/3200_A_2RS1TN9_MT33_PART5.sldprt
design_documents/Praxim Models/Version 2/3200_A_2RS1TN9_MT33_PART6.sldprt
design_documents/Praxim Models/Version 2/Link 1.SLDPRT
design_documents/Praxim Models/Version 2/Link 2.SLDPRT
design_documents/Praxim Models/Version 2/Version 2.SLDASM
design_documents/Praxim Models/Version 2/axle1.SLDPRT
design_documents/Praxim Models/Version 2/axle2.SLDPRT
design_documents/Praxim Models/Version 2/link 3 a.SLDPRT
design_documents/Praxim Models/Version 2/link guide.SLDPRT
design_documents/Praxim Models/Version 2/rotating base.SLDPRT
design_documents/Praxim Models/Version 3/Spring Washer.SLDPRT
