minadanesh/apsc496/design_documents/Final Drawings/lathe 2.pdf

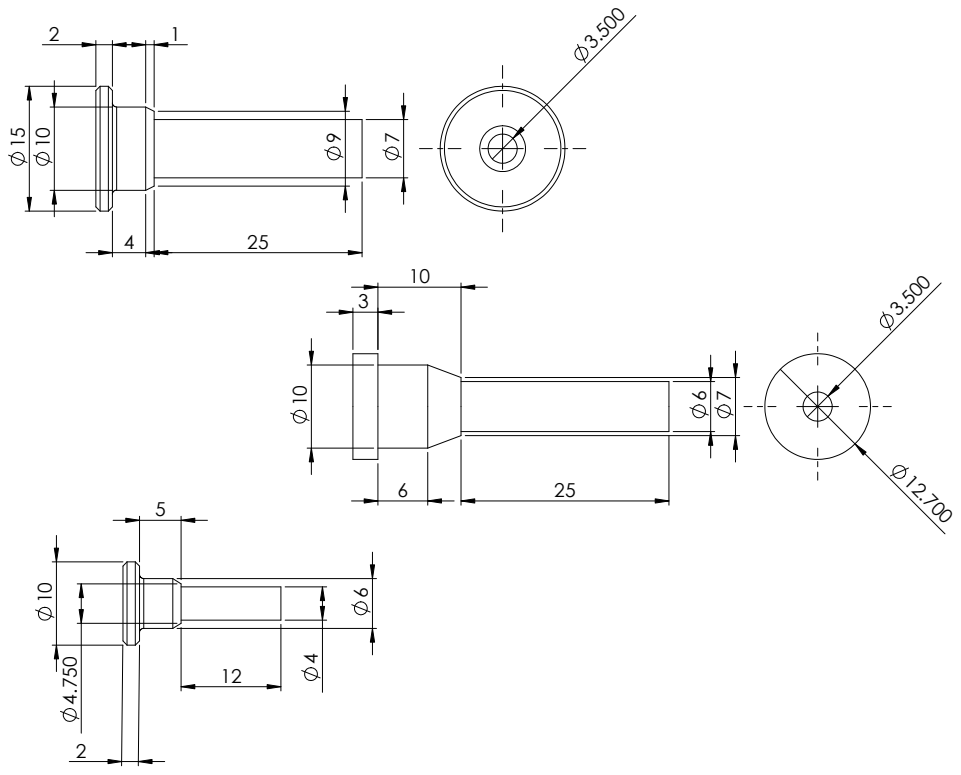
[picture p174: page 1]
