minadanesh/apsc496/design_documents/Final Drawings/vertical offset - Sheet1.pdf

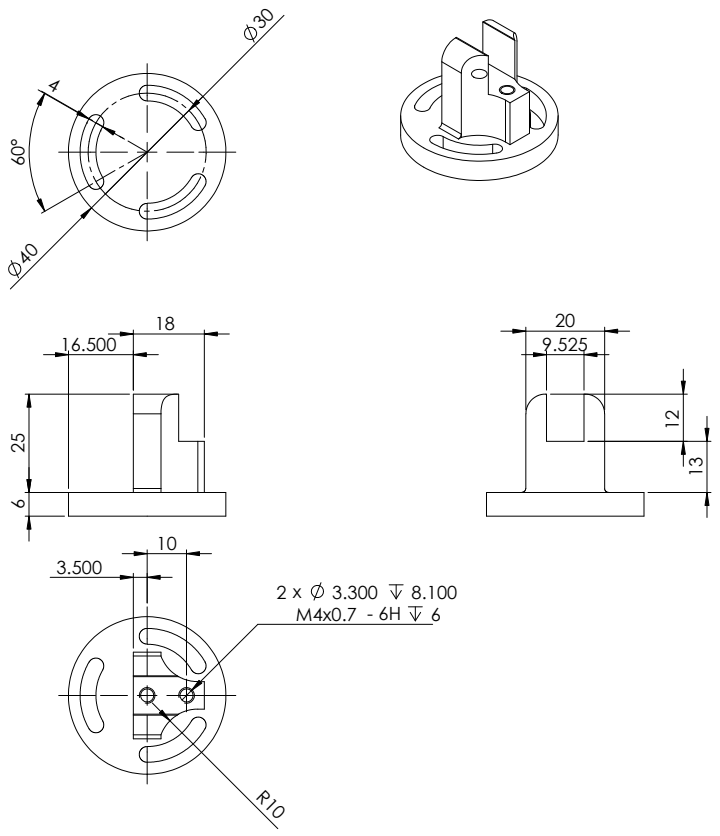
[picture p175: page 1]
