minadanesh/apsc496/design_documents/Final Drawings/Primary Links - Sheet1.pdf

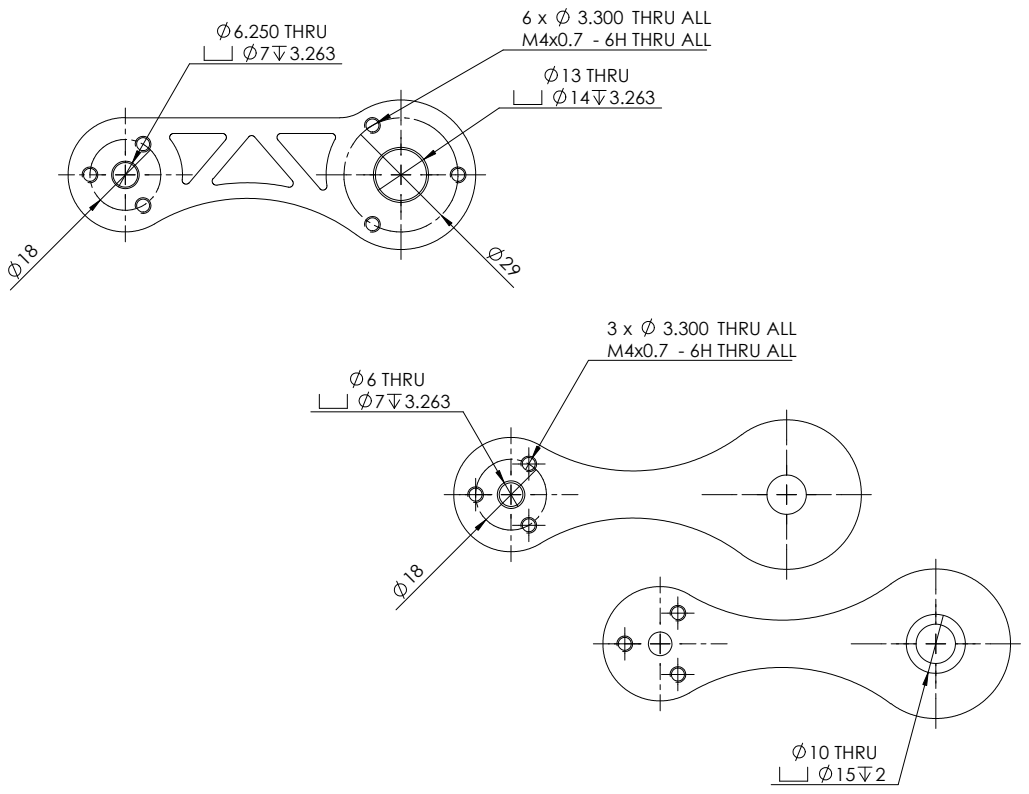
[picture p176: page 1]
10 THRU; 3.300 THRU ALL; M4x0.7 - 6H THRU ALL; 6 THRU; 13 THRU; 6.250 THRU 3.263 M4x0.7 - 6H THRU ALL
