minadanesh/apsc496/design_documents/Final Drawings/Seconday Links after WJ - Sheet.pdf

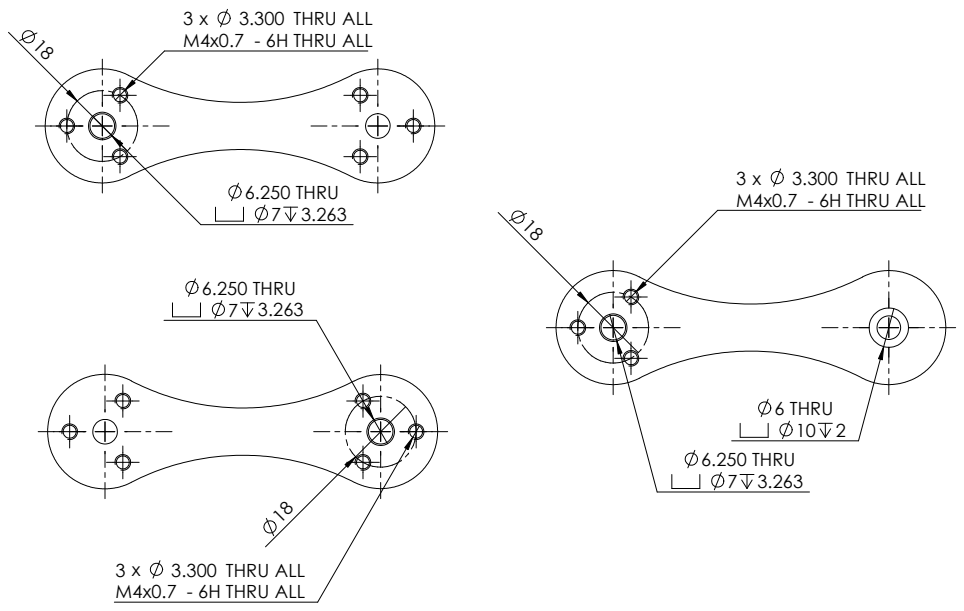
[picture p177: page 1]
THRU ALL x; M4x0.7 - 6H THRU ALL; 6.250 THRU; 3.300 THRU ALL; 6 THRU
