minadanesh/apsc496/design_documents/Final Drawings/Mill Parts - Sheet1.pdf

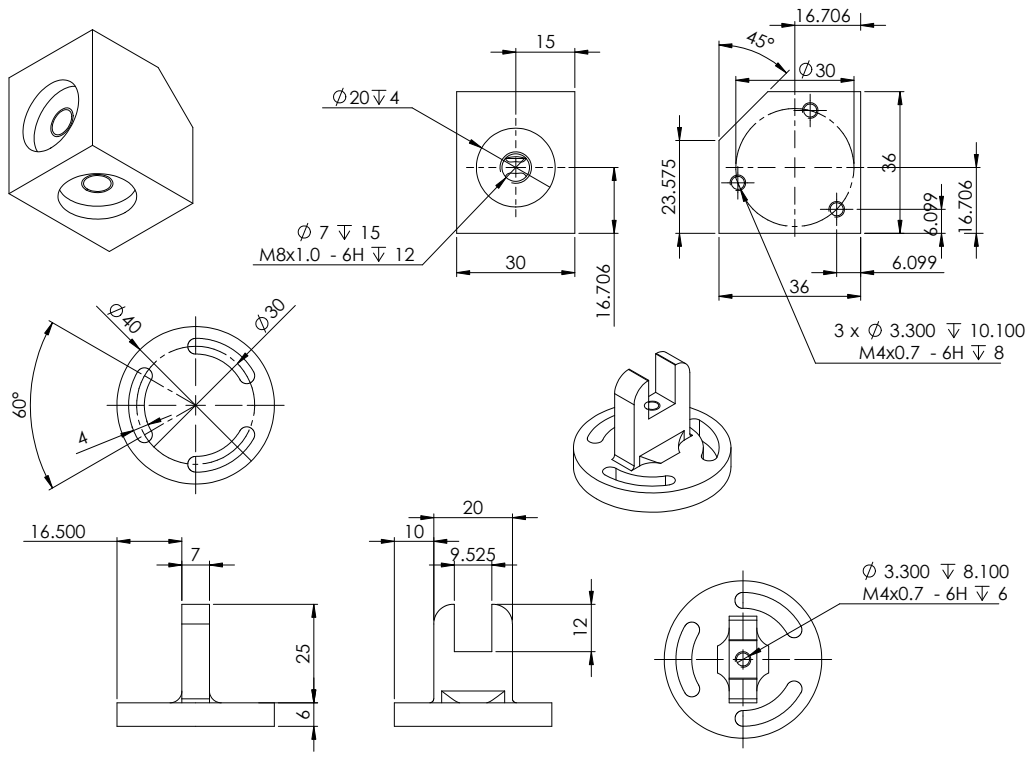
[picture p178: page 1]
