minadanesh/apsc496/design_documents/Final Drawings/Lathe Drawings.pdf

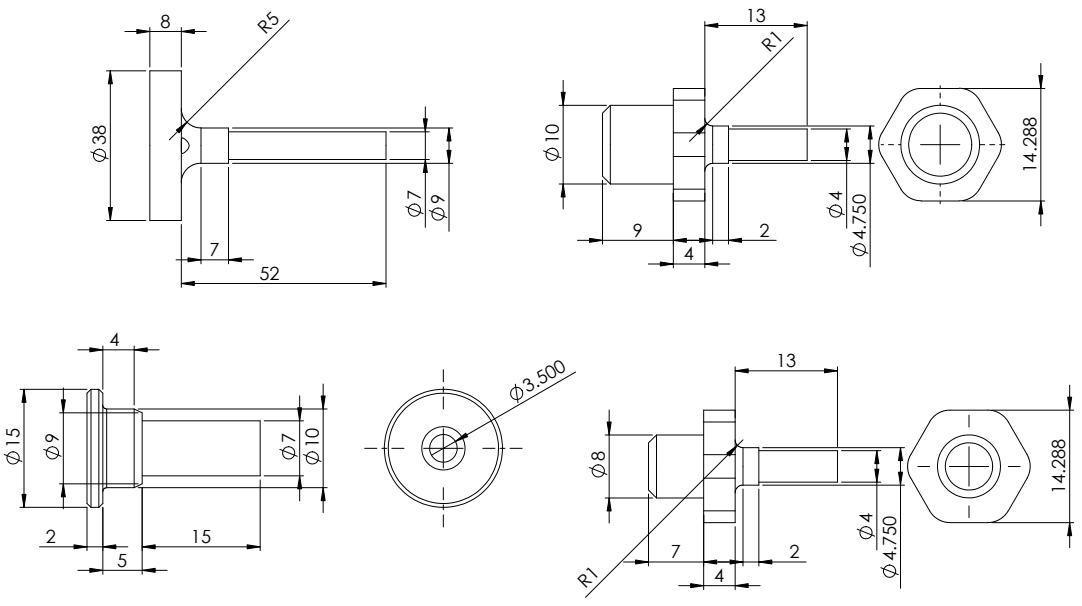
[picture p179: page 1]
