minadanesh/apsc496/design_documents/Final Drawings/Links Drawing.pdf

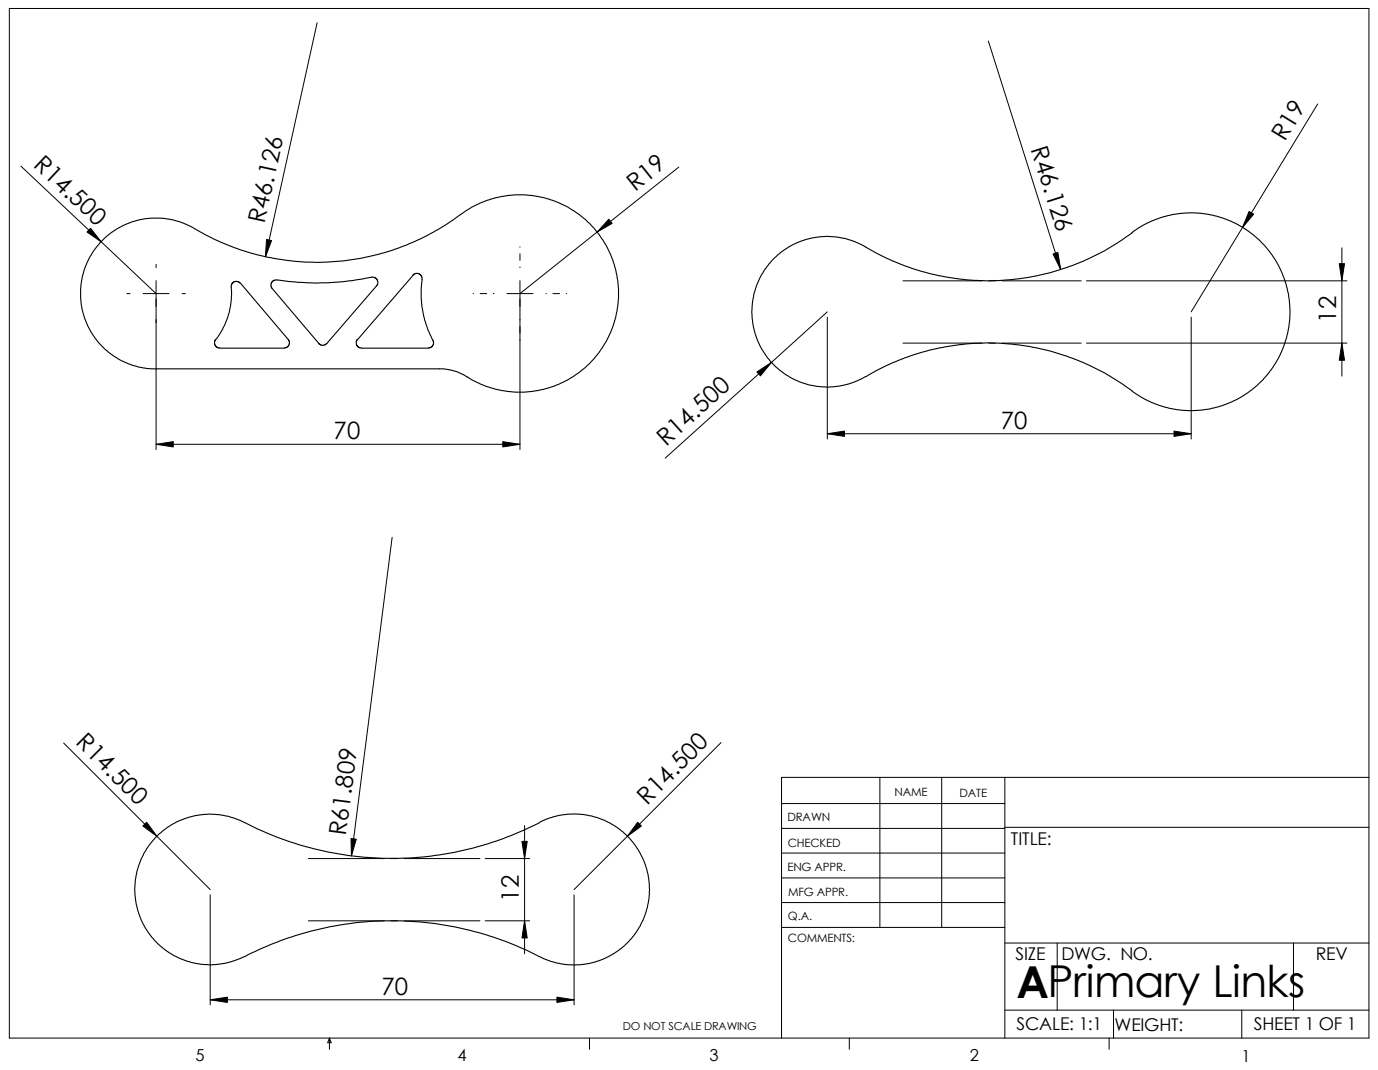
[picture p180: page 1]
COMMENTS:

NAME | DATE

DRAWN
CHECKED | | | TITLE:

ENG APPR.

MFG APPR.

SIZE Primary Links A | DWG. NO. | REV

DO NOT SCALE DRAWING

SCALE: 1:1 | WEIGHT: | SHEET 1 OF 1
