minadanesh/apsc496/design_documents/Final Drawings/WJ Profiles Dimensions.pdf

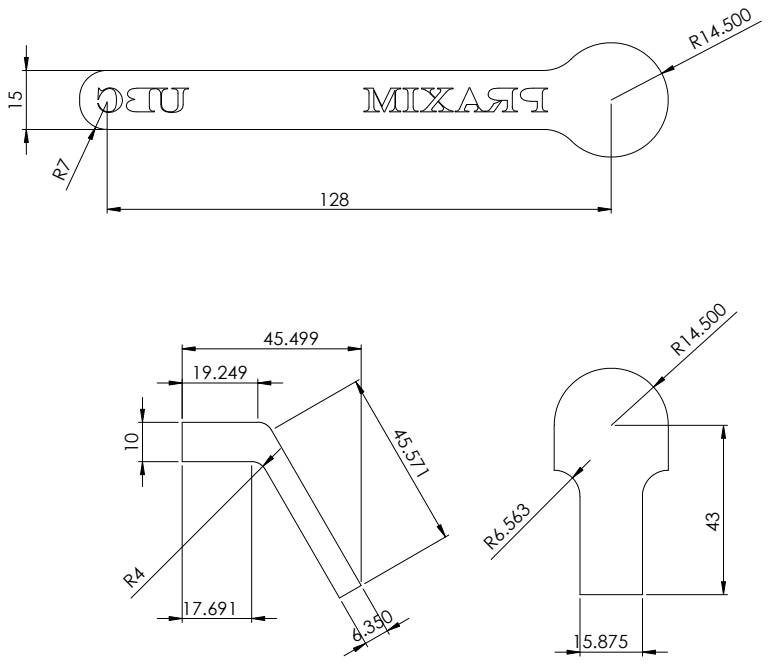
[picture p181: page 1]
