minadanesh/apsc496/design_documents/control_system/rtos/bsp-TI-omap3530-src/install/usr/include/arm/pxa250.h

/*
 * $QNXLicenseC:
 * Copyright 2008, QNX Software Systems. 
 * 
 * Licensed under the Apache License, Version 2.0 (the "License"). You 
 * may not reproduce, modify or distribute this software except in 
 * compliance with the License. You may obtain a copy of the License 
 * at: http://www.apache.org/licenses/LICENSE-2.0 
 * 
 * Unless required by applicable law or agreed to in writing, software 
 * distributed under the License is distributed on an "AS IS" basis, 
 * WITHOUT WARRANTIES OF ANY KIND, either express or implied.
 *
 * This file may contain contributions from others, either as 
 * contributors under the License or as licensors under other terms.  
 * Please review this entire file for other proprietary rights or license 
 * notices, as well as the QNX Development Suite License Guide at 
 * http://licensing.qnx.com/license-guide/ for other information.
 * $
 */




/*
 * Intel PXA250 Processor
 *

 *
 */

#ifndef	ARM_PXA250_H_INCLUDED
#define	ARM_PXA250_H_INCLUDED

/*
 * -------------------------------------------------------------------------
 * Interrupt controller
 * -------------------------------------------------------------------------
 */
#define	PXA250_INTR_BASE	0x40d00000		/* base physical address */
#define	PXA250_INTR_SIZE	0x0000001c

/*
 * Register offsets from PXA250_INTR_BASE
 */
#define	PXA250_ICIP			0x00			/* IRQ pending register */
#define	PXA250_ICMR			0x04			/* mask register */
#define	PXA250_ICLR			0x08			/* level register */
#define	PXA250_ICFP			0x0c			/* FIQ pending register */
#define	PXA250_ICPR			0x10			/* pending register */
#define	PXA250_ICCR			0x14			/* control register */

/*
 * PXA250_ICCR register bits
 */
#define	PXA250_ICCR_DIM		0x00000001		/* disable IDLE mask */

/*
 * -------------------------------------------------------------------------
 * GPIO controller
 * -------------------------------------------------------------------------
 */
#define	PXA250_GPIO_BASE	0x40e00000		/* base physical address */
#define	PXA250_GPIO_SIZE	0x0000006c

/*
 * Register offsets from PXA250_GPIO_BASE
 */
#define	PXA250_GPLR0		0x00			/* pin level GPIO 0-31  */
#define	PXA250_GPLR1		0x04			/* pin level GPIO 31-63 */
#define	PXA250_GPLR2		0x08			/* pin level GPIO 64-80 */
#define	PXA250_GPDR0		0x0c			/* pin direction GPIO 0-31  */
#define	PXA250_GPDR1		0x10			/* pin direction GPIO 31-63 */
#define	PXA250_GPDR2		0x14			/* pin direction GPIO 64-80 */
#define	PXA250_GPSR0		0x18			/* pin set GPIO 0-31  */
#define	PXA250_GPSR1		0x1c			/* pin set GPIO 31-63 */
#define	PXA250_GPSR2		0x20			/* pin set GPIO 64-80 */
#define	PXA250_GPCR0		0x24			/* pin set GPIO 0-31  */
#define	PXA250_GPCR1		0x28			/* pin set GPIO 31-63 */
#define	PXA250_GPCR2		0x2c			/* pin set GPIO 64-80 */
#define	PXA250_GRER0		0x30			/* rising edge detect GPIO 0-31  */
#define	PXA250_GRER1		0x34			/* rising edge detect GPIO 31-63 */
#define	PXA250_GRER2		0x38			/* rising edge detect GPIO 64-80 */
#define	PXA250_GFER0		0x3c			/* falling edge detect GPIO 0-31  */
#define	PXA250_GFER1		0x40			/* falling edge detect GPIO 31-63 */
#define	PXA250_GFER2		0x44			/* falling edge detect GPIO 64-80 */
#define	PXA250_GEDR0		0x48			/* edge detect status GPIO 0-31  */
#define	PXA250_GEDR1		0x4c			/* edge detect status GPIO 31-63 */
#define	PXA250_GEDR2		0x50			/* edge detect status GPIO 64-80 */
#define	PXA250_GAFR0_L		0x54			/* alternate function GPIO 0-15 */
#define	PXA250_GAFR0_U		0x58			/* alternate function GPIO 16-31 */
#define	PXA250_GAFR1_L		0x5c			/* alternate function GPIO 32-47 */
#define	PXA250_GAFR1_U		0x60			/* alternate function GPIO 48-63 */
#define	PXA250_GAFR2_L		0x64			/* alternate function GPIO 64-79 */
#define	PXA250_GAFR2_U		0x68			/* alternate function GPIO 80    */

/*
 * -------------------------------------------------------------------------
 * Serial UARTs
 * -------------------------------------------------------------------------
 */
#define	PXA250_FFUART_BASE	0x40100000		/* base physical address */
#define	PXA250_BTUART_BASE	0x40200000		/* base physical address */
#define	PXA250_STUART_BASE	0x40700000		/* base physical address */
#define	PXA250_UART_SIZE	0x24

/*
 * Register offsets from register base
 */
#define	PXA250_RBR			0x00			/* Rx data */
#define	PXA250_THR			0x00			/* Tx data */
#define	PXA250_IER			0x04			/* interrupt enable */
#define	PXA250_IIR			0x08			/* interrupt identification */
#define	PXA250_FCR			0x08			/* fifo control */
#define	PXA250_LCR			0x0c			/* line control */
#define	PXA250_MCR			0x10			/* modem control */
#define	PXA250_LSR			0x14			/* line status */
#define	PXA250_MSR			0x18			/* modem status */
#define	PXA250_ISR			0x20			/* infrared selection */
#define	PXA250_DLL			0x00			/* divisor latch low  */
#define	PXA250_DLH			0x04			/* divisor latch high */

/*
 * IER bits
 */
#define	PXA250_IER_RAVIE	0x01			/* Rx data available */
#define	PXA250_IER_TIE		0x02			/* Tx request */
#define	PXA250_IER_RLSE		0x04			/* Rx line status */
#define	PXA250_IER_MIE		0x08			/* modem status */
#define	PXA250_IER_RTOIE	0x10			/* Rx timeout */
#define	PXA250_IER_NRZE		0x20			/* NRZ encoding */
#define	PXA250_IER_UUE		0x40			/* uart enable */
#define	PXA250_IER_DMAE		0x80			/* DMA request */
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
