minadanesh/apsc496/(commit log)

2010-01-07 initial file structure
    [APSC 496 - Functional Tree.xlsx, Term2.xlsx, david.xlsx, davy.xlsx, erica.xlsx, happy graphs.xlsx, ibrahim.xlsx, nicholas.xlsx]
2010-01-07 folder restructure
    [APSC 496 - Functional Tree.xlsx]
2010-01-07 added minutes folder
    [david.xlsx, davy.xlsx, erica.xlsx, ibrahim.xlsx, nicholas.xlsx]
2010-01-07 hours updated
    [davy.xlsx]
2010-01-09 schedules update
    [Erica.xlsx]
2010-01-09 hours update
    [david.xlsx, davy.xlsx, nicholas.xlsx]
2010-01-12 updated hours
    [david.xlsx, davy.xlsx]
2010-01-20 fixed nich's hours
    [nicholas.xlsx]
2010-01-25 hours update CFP update
    [erica.xlsx]
2010-01-27 nich's hours update
    [nicholas.xlsx]
2010-01-27 ib's hours update
    [ibrahim.xlsx]
2010-01-27 hours update and TAR update
    [david.xlsx, davy.xlsx, ibrahim.xlsx, nicholas.xlsx]
2010-02-11 hours update for erica
    [erica.xlsx]
2010-02-18 file structure update hours update
    [davy.xlsx]
2010-03-02 erica hours update
    [erica.xlsx]
2010-03-05 fixed dave's hours
    [david.xlsx, overall hours report.xlsx]
2010-03-06 spec sheets
    [power.xlsx]
2010-03-08 hours update add receipts add motor rma
    [davy.xlsx, overall hours report.xlsx]
2010-03-23 hours update add receipts
    [davy.xlsx, overall hours report.xlsx]
2010-03-28 hours update source add
    [david.xlsx, davy.xlsx, erica.xlsx, ibrahim.xlsx, nicholas.xlsx, overall hours report.xlsx]
2010-04-07 hours update finance update
    [davy.xlsx, erica.xlsx, overall hours report.xlsx]
2010-04-12 hours update src update
    [davy.xlsx, overall hours report.xlsx]
2010-04-24 move folder praxim models
    [3200_A_2RS1TN9_MT33.sldasm, 3200_A_2RS1TN9_MT33_PART1.sldprt, 3200_A_2RS1TN9_MT33_PART2.sldprt, 3200_A_2RS1TN9_MT33_PART3.sldprt, 3200_A_2RS1TN9_MT33_PART4.sldprt, 3200_A_2RS1TN9_MT33_PART5.sldprt, 3200_A_2RS1TN9_MT33_PART6.sldprt, 687.sldasm]
